machadoleonardo94/Echoes-of-Termina/Firmware/echoes_of_termina/docs/two-button-ui.md

# Two-button interface — evaluation

Scope: what the two buttons can express on this hardware, what was measured on the
bench board while building it, and where the current provisional mapping does not
hold up. Everything below is grounded in a serial capture of real presses, not in
a design sketch: the raw logs are `.pio/_btn_test.log` (diagnostic round) and
`.pio/_btn_final.log` (production round, both modes).

**Pictures:** `docs/diagrams/button-state-machine.png`, `gesture-map.png` and
`feedback-paths.png` (SVG next to each, for zooming). They are generated by
`tools/make_flowcharts.py`, which also self-checks its own layout — see section 10.

---

## 1. What was built

The single button's logic was replaced by two layers, so the interface can be
argued about without touching the state machine:

| file | role |
| --- | --- |
| `src/services/buttons.h` | pin levels → debounced gestures. Knows nothing about audio, WiFi or LEDs. Per-button click window (see section 9). |
| `src/services/controls.h` | gesture → feature. **The only file that decides what a gesture means.** |
| `src/services/audio_cues.h` | tones mixed into the Bluetooth PCM stream (feedback channel 1). |
| `src/services/ui_feedback.h` | the strip as an overlay: volume bar, animation blink count, mode-switch acknowledgement (feedback channel 2). |
| `src/services/wifi_portal.h` | gained a small facade (`audio_next_track`, `audio_restart_track`, `audio_set_volume_percent`, `audio_is_playing`, …) so the action layer never reaches into the player's internals. |
| `src/services/readings.h` | button code removed; keeps the ADC only. |
| `src/services/mode_manager.h` | no longer hard-codes the Bluetooth volume at boot; `controls_begin()` applies the persisted level to whichever backend came up. |
| `src/services/buttons.h` (`BUTTON_TRACE`) | diagnostic build: logs every raw edge plus a 5 s idle-level census, and suppresses the destructive actions. |

What went away: one pin, a shared press counter with four meanings, a 1000 ms
wait-and-see window, an `ISR`-vs-poll story spread over three files, and
`struct_buttonState`.

### Gesture ladder (per button)

```
MIN_PRESS   < 50 ms   electrical blip, discarded, leaves an open burst alone
CLICK       short press, released before 600 ms, no further press within 400 ms
DOUBLE      2 presses in one burst
TRIPLE      3 presses in one burst
HOLD        still down at 600 ms → then REPEAT every 150 ms → RELEASE on letting go
VERY_LONG   still down at 4000 ms, and it stops the repeat train
```

A hold swallows the burst it interrupted: press-press-hold is a `HOLD`, never a
`DOUBLE` followed by a hold.

---

## 2. Verified on hardware

Bench board, `echoes-v1` (8 MB, PSRAM disabled), flashed over OTA; both buttons
exercised by hand with COM7 capturing.

**Input layer — works, on both pins.**

```
[BTN] PROG on GPIO0, active LOW (press to GND) — idle level released
[BTN] EXT on GPIO4, active HIGH (press to 3V3) — idle level released
[BTN] levels: PROG(GPIO0)=HIGH EXT(GPIO4)=LOW          ← 5 s census, both idle correctly
[BTN] EXT raw -> PRESSED @29351 ms / released @29516 ms → [BTN] EXT click (165 ms)
[BTN] EXT double (118 ms)      [BTN] EXT triple (92 ms)
[BTN] PROG hold (600 ms)  →  repeat (750) (900) (1050) …  →  release (2783 ms)
[BTN] PROG very-long (4000 ms)
```

* **Zero** `ignored … blip` lines and zero phantom events across ~15 minutes on
  both pins. The old GPIO0 noise problem did not reappear, but the strip was not
  driving hard audio at the time — the polling design is what protects against it.
* Measured human tap durations: **96–190 ms** (PROG 122–157, EXT 124–190). The
  50 ms blip floor therefore has a 2–4× margin, and no tap ever approached the
  600 ms hold threshold. The thresholds are correctly placed on this hardware.
* Burst separation measured: two taps 273 ms apart → `DOUBLE`; three taps 300 and
  346 ms apart → `TRIPLE`; taps 1.5 s apart → three separate `CLICK`s. The 400 ms
  window is doing exactly what it claims.

**Both playback backends.**

| gesture | WiFi mode (local SD player) | Bluetooth mode (phone) |
| --- | --- | --- |
| PROG click | `[BUTTON] No track to pause` (nothing loaded) | `AVRCP pause` / `AVRCP play`, phone confirmed (`phone playback status -> 1/2`) |
| EXT click | `[CTRL] next: no playlist loaded` | `[CTRL] AVRCP next` — track changed |
| EXT double | `[CTRL] LED animation -> none/envelope/fft` | same |
| PROG triple | `[MODE] Switching to Bluetooth — restarting…` → rebooted, phone auto-reconnected | (reverse) |
| PROG/EXT hold | volume ramp 100→0 %, persisted | audible ramp 100→55 →100 %, `A2DP step 127→69→127` |

**Three defects the log exposed, all fixed and rebuilt:**

1. **NVS write per ramp tick.** A 2 s hold wrote flash 13 times
   (`Volume saved to NVS` every 150 ms). Now the ramp persists on its first tick
   and once on release — 2 writes per gesture — and rebooting actions persist
   first, so a 4 s hold that ends in a reboot cannot come back at the pre-hold
   level.
2. **Limit spam.** Holding a button already at 0 %/100 % logged one line every
   150 ms. Now it reports the limit once per gesture (re-verified: one line, then
   12 silent repeats).
3. **Two owners of the volume.** The portal's slider and the button ramp each kept
   their own idea of the level, so a slider move followed by a button press wrote
   the stale value back. There is now one percent, one writer, one NVS key.

**One observation to watch:** `ASSERT_WARN(1 9), in lc_task.c at line 1409` from
the Bluetooth controller, once, immediately after an AVRCP pause while streaming.
It is a warning, not a panic — the session continued normally. Not from this
firmware, but it is worth recognising if it ever shows up alongside a dropout.

---

## 3. Constraints the interface has to live inside

These are properties of the board and the libraries, each confirmed in this
session or in the library source. They are what make the interface design
non-obvious.

1. **A tap costs 400 ms before it does anything.** A single click cannot be
   committed until the multi-click window closes. Measured consequence: every
   play/pause press is felt ~0.4 s after the finger leaves the button. This is the
   price of having double- and triple-click mean something.

2. **The two modes are exclusive, and the same gesture has two backends.**
   Bluetooth = the phone is the transport (AVRCP only: no playlist, no seek, no
   exact restart). WiFi + standalone = the SD player is the transport, but
   playback **requires the radio down** (no PSRAM on this board: BT mode leaves
   ~42 KB free, WiFi mode ~88 KB, and lwIP plus the decoder do not fit together).
   So while a local track plays there is no portal, no OTA, and no AVRCP — and the
   button path back (`EXT` very-long → `wifi_enable()`) is not a nicety, it is the
   only exit that does not reboot.

3. **AVRCP commands block the main loop for ~100 ms each.** The library's
   `execute_avrc_command()` sends PRESSED, `delay(100)`, RELEASED
   (`BluetoothA2DPSink.cpp:1353-1372`, `delay_ms` is Arduino `delay`). Fine for a
   tap; fatal for a volume ramp, which is why the ramp drives the sink's local
   attenuation with `set_volume()` (no blocking) instead of `volume_up()`.

4. **Who owns the volume is genuinely ambiguous in Bluetooth mode.** Our
   `set_volume()` sets local digital attenuation *and* notifies the phone of the
   new level (`volume_set_by_local_host`); the phone's own slider arrives as
   `SET_ABSOLUTE_VOLUME` and lands in the same `s_volume` (`volume_set_by_controller`).
   Last writer wins. Measured: the button ramp is clearly audible, but a phone
   sitting at 20 % still caps the ceiling no matter what the ramp does.

5. **The local player cannot be created in Bluetooth mode** — `Audio`'s
   constructor installs `I2S_NUM_0`, which the A2DP sink already owns. The old
   firmware allowed a long-press "standalone show" in Bluetooth mode; that is now
   refused explicitly rather than half-executed into silence.

6. **`ESP32-audioI2S` has no mixing hook.** Nothing can be played *on top of* a
   local track, so audio cues behave differently in the two modes (section 5).

---

## 4. Evaluation of the provisional mapping

```
gesture            PROG (GPIO0)                  EXT (GPIO4)
click              play / pause                  next song
double             restart song                  cycle LED animation
triple             switch mode (reboots)         standalone show
hold + repeat      volume down                   volume up
very long (4 s)    reboot the board              bring WiFi back
```

**What holds up.** Hold = volume on both buttons is the best part of this map:
symmetric, memorable, no modes to learn, and it is the one gesture where
continuous input is the natural expression. Click = play/pause and click = next is
the industry-standard pair. Keeping the rare, destructive actions on the two
hardest gestures (triple, 4 s hold) means neither can be triggered by a pocket
squeeze or a dropped device.

**What does not hold up.**

* **P1 — the 400 ms tax is charged to the most frequent action.** Play/pause is
  the gesture a user makes most and feels most. It waits the longest. Mode switch
  (rare, rebooting, 8 s of silence) is what forces that wait.
* **P2 — the transport row is dead exactly where the device is reachable.** In
  WiFi mode with nothing loaded, a click does nothing but log
  (`No track to pause`, `no playlist loaded`). That is the state the device sits
  in when its owner walks up to it: idle, portal up. The most useful click there
  is "play something", not "pause nothing".
* **P3 — "switch animation" is a blind action.** Tapping EXT twice cycles
  none → envelope → fft, and the only confirmation is a serial line. Envelope and
  FFT do not differ visibly until audio is playing, so a user can cycle three
  times and have no idea where they landed. Same for the volume: with nothing
  playing, a ramp is completely silent and invisible.
* **P4 — "restart" is ambiguous, and both readings already share one button.**
  Double-click = restart the current song; 4 s hold = reboot the device. In
  Bluetooth mode "restart song" degrades to `AVRCP previous()`, which is the
  source app's decision, not ours — it may restart, or step back a track.
* **P5 — the very-long tier has no arming feedback.** Nothing tells the user that
  holding past 4 s is different from holding for 1 s, so the only way to learn it
  is to search for it. On a device whose entire output is a LED strip and a
  speaker, that is a missed opportunity — see section 5.
* **P6 — one button carries five gestures, the other five.** Fine on paper, but
  PROG is also the boot-strapping pin (holding it during a reset enters the ROM
  loader) and on the bench board it is the harder button to reach. Legibility
  would improve if the multi-click ladder lived on the accessible button only.

---

## 5. Audio feedback: what is actually possible

The device has a speaker, so "the interface talks back" is not decoration — with
no screen it is the only way some actions can be confirmed at all.

**Bluetooth mode — cues can be mixed into the stream. Feasible, and there are two
insertion points.** The library calls its hooks inside `audio_data_callback`
(`BluetoothA2DPSink.cpp:1311-1349`) in this order:

```
raw_stream_reader(data, len)          ← BEFORE volume control  (already used: the LED tap)
volume_control()->update_audio_data((Frame *)data, len / 4)
stream_reader(data, len)              ← AFTER volume control
write_audio(data, len)                → I2S
```

The buffer is mutable — the library itself casts it to `Frame*` and rewrites it in
place for both the channel swap and the volume — so a cue generator can add into
it. Two deliberate choices follow:

* **post-volume hook** (`set_stream_reader(cb, /*is_output=*/true)`): the cue is
  always audible at the same loudness, independent of the volume setting. This is
  the right place for "animation switched", "mode switch armed", "no source
  connected".
* **pre-volume hook**: the cue's loudness tracks the volume, which is exactly what
  a *volume* cue should do — the beep tells you how loud the output actually is,
  which is the one thing a volume ramp cannot otherwise communicate while silent.
* Caveat: `set_stream_reader()`'s second argument **is** `is_output`; passing
  `false` silences the DAC. This is already documented in `mode_manager.h` and is
  the reason the LED tap uses `set_raw_stream_reader()` instead.
* Cost: a precomputed sine table (a few hundred bytes of `static` data) and a
  couple of adds per frame on the BT data path, with ~33 KB free heap in that
  mode. No allocation, no blocking call — unlike AVRCP, which blocks 100 ms.

**WiFi / standalone mode — no cue can be mixed into a playing track.**
`ESP32-audioI2S` owns `I2S_NUM_0` and has no beep or mixing API. The options, in
order of preference:

1. **Use the strip as the feedback channel.** 144 addressable LEDs, already
   driven, works in both modes, costs nothing on the audio path. A volume ramp
   becomes a bar that fills as you hold; an animation switch becomes a short
   confirmation flash; a 4 s hold becomes a countdown; the mode switch becomes a
   colour. This is the highest-value change in this document, and it is mode
   independent.
2. **Short cue files from the SD card** — only usable between tracks or while
   idle (playing one means re-connecting the decoder to a different file, which
   stops the song), so it cannot serve volume or transport feedback mid-track.
3. **Accept silence** for local playback, and keep serial lines for development.

**Consequence for the feature list.** "Play" and "pause" are inherently audible
(the music starts and stops). "Next song" is audible in Bluetooth mode and
self-evident in local mode. **Volume, animation and mode switch are the three that
need help**, and they need it in both modes — which points at the strip for all
three, with in-stream cues in Bluetooth mode as the refinement that makes volume
feedback honest.

> Superseded in one respect by section 11: the board's *own* states (waiting for a
> phone, paired, hotspot, WiFi up/down) happen with no stream in existence, so a third
> path was added — tones written straight to the I2S wire while the DMA has no writer.
> A track that is already playing is still unreachable; that conclusion stands.

---

## 6. Options for the mapping

**Option A — keep it, tune it.** Leave the map as-is and drop the multi-click
window from 400 ms to 300 ms. Lowest risk, does not fix P1–P5.

**Option B — per-button windows (recommended).** Make the multi-click window a
per-button property, so a button whose clicks are single-purpose fires them
*immediately on release* instead of waiting:

```
PROG (single-purpose, instant)     EXT (laddered, 400 ms window)
click      play / pause            click      play-when-idle, else next song
hold       volume down             double     cycle LED animation
very long  reboot                  triple     switch mode (reboots)
                                   hold       volume up
                                   very long  bring WiFi back
```

This fixes P1 (pause is instant), P2 (the idle click starts a show rather than
aiming at nothing), and P6 (the hidden gestures concentrate on the accessible
button). It costs ~15 lines in `buttons.h`: a `multi_gap_ms` field per wiring
entry, with 0 meaning "commit the click on release".

**Option C — chord for the mode switch, everything instant.** Hold *both* buttons
for 3 s → switch mode, with the strip counting down. Then neither button needs a
multi-click window and every click is instant. The ramps cancel out naturally
during the chord (one steps up, one steps down in the same 150 ms tick), so no
extra arbitration is needed. The risk is an accidental chord — which is why the
countdown on the strip is not optional, and why this is the second choice: it buys
responsiveness by making a rebooting action easier to trigger by accident.

**Recommendation: B now, C only if the 400 ms tap lag on EXT also turns out to
annoy.** Both are cheap; B subsumes the immediate fix and leaves the chord open.

---

## 7. Parameters, as measured

| constant | value | where it came from |
| --- | --- | --- |
| `BTN_DEBOUNCE_MS` | 25 ms | unchanged from the old polled debouncer |
| `BTN_MIN_PRESS_MS` | 50 ms | measured taps 96–190 ms → 2–4× margin |
| `BTN_HOLD_MS` | 600 ms | felt right on hardware; separates cleanly from taps |
| `BTN_REPEAT_MS` | 150 ms | 6.7 steps/s |
| `CTRL_VOLUME_STEP_PERCENT` | 5 % | full sweep ≈ 3 s of holding (measured) |
| `BTN_VERY_LONG_MS` | 4000 ms | fires at exactly 4000 ms in the log |
| `BTN_MULTI_GAP_MS` | 400 ms | doubles at 273 ms and triples at 300/346 ms detected; 1.5 s taps correctly separate |
| A2DP volume range | 0–127 | 5 % ⇒ step 6.35 |
| local volume range | 0–21 | 5 % ⇒ step 1.05, hence the percent is authoritative |

---

## 8. Open questions

Answered by the device's owner:

1. **"Restart" — song or device?** → **Song.** There is therefore no reboot
   gesture at all; `POST /api/reboot` and the power switch remain for that. It also
   freed the second button's ladder (a reboot no longer competes with a transport
   action for a slot).
2. **Should the idle click become "play"?** → **Yes.** See the implemented map below.
3. **Which map?** → **B** (per-button click windows).
4. **Implement the cues?** → **Yes**, both channels: tones in the Bluetooth stream
   and the strip as an overlay.

---

## 9. What was implemented after this evaluation

### The map that ships

```
PROG (GPIO0) — single-purpose, clicks are instant (no multi-click window)
    click        play / pause   (with nothing loaded: play = start a standalone show)
    hold         volume down    (ramp, strip bar, rising/falling ticks)
    very long    restart the current song (the ramp is undone first)

EXT (GPIO4) — carries the ladder, clicks wait for the 400 ms window
    click        play when idle, otherwise next song
    double       cycle LED animation (1/2/3 blue blinks = which animation)
    triple       switch mode (3 white flashes, then the reboot)
    hold         volume up      (same feedback as PROG's ramp)
    very long    bring WiFi back after a standalone show tore it down
```

### The two feedback channels

| channel | file | works when | cannot do |
| --- | --- | --- | --- |
| tones mixed into the A2DP stream | `src/services/audio_cues.h` (`cue_mix`) | Bluetooth mode, **while audio is actually flowing** | anything in local playback; anything while the phone is paused or no source is connected (no data callback = no stream to mix into) |
| tones written straight to the I2S wire | `src/services/audio_cues.h` (`cue_wire_pump`, `cue_play_now`) | every state with no stream: Bluetooth waiting/paired, WiFi hotspot/connected/failed | while a track or a phone's stream owns the DMA (section 11) |
| the strip as an overlay | `src/services/ui_feedback.h` | both modes, always | show fine detail (it is a bar and a blink count) |

Measured reasons each is placed where it is:

* The cue mixer registers through `set_stream_reader(cue_mix, true)`, i.e. **after**
  volume control, so a cue is equally loud at 5 % and at 100 %. That is the right
  behaviour for "the animation changed", and it is why the *volume* cue reports the
  level by **pitch** (400 Hz → 1400 Hz) rather than by loudness.
* The overlay pre-empts both LED renderers. `run_lightshow()` and
  `run_led_animation()` consult `ui_feedback_active()` and stand down, because each
  renderer ends its frame in `majora.show()`, which blocks for the whole RMT
  transfer (~29 µs/LED, ~4 ms at 144 LEDs). Two renderers drawing the same frame
  would halve the frame rate for no visible gain.
* The ramp's strip bar refreshes on every tick (150 ms) and is deliberately not
  frame-paced, or the bar would visibly lag the finger on a long strip.
* `ui_flash_blocking()` (the mode-switch acknowledgement) blocks ~0.9 s on purpose:
  the action it confirms is about to take the CPU away, and a user who does not see
  the acknowledgement cannot tell an accepted triple-click from a missed one.

### Decisions taken while implementing

* **A very-long hold undoes the ramp it interrupted.** The gesture starts as a
  volume ramp and only becomes "restart" at 4 s; without the undo, restarting a
  song would also have dragged the volume to one end.
* **The Bluetooth→WiFi direction is the only one with an audible mode-switch
  cue.** The arpeggio is mixed into the A2DP stream, and that stream exists only
  while Bluetooth mode is up — switching *to* Bluetooth happens with the mixer off.
  Both directions get the white flashes.
* **The diagnostic build suppresses two actions, not three**: mode switch and
  play-from-idle (which tears WiFi down). A reboot gesture no longer exists to
  suppress.
* **`ctrl_reboot()` was removed** rather than left unused: the feature list asks for
  restart-the-song, and dead code that reboots a board is not worth keeping for
  nostalgia.
* `lightshow_frame_period_ms()` lost its `static`, because the overlay (included
  above the renderers so they can yield to it) paces its frames with it.

---

## 10. Diagrams

Generated by `tools/make_flowcharts.py` (matplotlib), written to `docs/diagrams/` as
PNG at 200 dpi plus SVG:

```
python tools/make_flowcharts.py
```

The script **checks its own layout** before it declares success, because the
diagrams were laid out without anyone looking at them: it registers every box, note
and arrow, then fails the run if two of them overlap, if any text is wider or taller
than the box holding it, if anything falls outside the canvas, or if an arrow starts
or ends in empty space rather than on a box. That is a real check, not a formality —
the first run reported five overlaps and one box hanging off the canvas.

### button-state-machine.png / .svg

The gesture ladder in `src/services/buttons.h`: the release path (click / double /
triple, and the `multi_gap_ms == 0` branch that makes PROG's clicks instant) and the
hold path (HOLD at 600 ms → REPEAT every 150 ms → VERY_LONG at 4 s → RELEASE).

### gesture-map.png / .svg

The interface as shipped, gesture by gesture, for both buttons — including the
actions the state machine can never produce for PROG, which is the consequence of a
zero click window.

### feedback-paths.png / .svg

How an action answers back: the strip overlay (both modes, always) and the tones
mixed into the A2DP stream (Bluetooth only, and only while the phone is sending
audio), plus the yield relationship that keeps the two LED renderers from drawing
the same frame twice.

---

## 11. State cues — the board says what it is doing

Gesture feedback answers a press. It says nothing about the far more common question:
**what is this thing doing right now?** In Bluetooth mode the answer used to be
unavailable everywhere — dark strip, silent speaker, and no way to tell "waiting for a
phone" from "hung". Five states now announce themselves.

### What each one sounds like, and why

| state | kind | motif | where it is triggered |
| --- | --- | --- | --- |
| Bluetooth mode, no source | `CUE_BT_WAIT` | two long low notes rising (D5→G5, 260 ms) | `setup_bluetooth_mode()`, immediately after `a2dp_sink.start()` — **once per boot** |
| source connected | `CUE_BT_PAIRED` | three fast notes, 880→1175→1568 Hz | `cue_on_bt_connection_state()` → `CONNECTION_STATE_CONNECTED` |
| config hotspot created | `CUE_AP_UP` | the same note twice, 60 ms apart | the WiFiManager `setAPCallback()` in `wifi_settings.h` |
| WiFi up | `CUE_WIFI_OK` | rising triad ending high | `setup_WIFI()` on success, and `wifi_enable()` when the 4 s hold works |
| no network | `CUE_WIFI_FAIL` | falling triad ending low | `setup_WIFI()` on portal timeout, and `wifi_enable()` when it cannot reconnect |

One rule makes the set learnable after two or three encounters: **rising = on, falling
= no, a repeated note = "listen, I need something"**. The state motifs also sit in a
different register from the transport cues, so "paired" cannot be mistaken for
"playing".

Three decisions worth recording:

* **"Waiting" plays once, not forever.** A repeating beacon would answer "is it even
  on?" better, but it is also the sound a user would hate by day two. The owner chose
  once-at-boot; the change of state gets announced instead.
* **Disconnect is silent on purpose.** `set_auto_reconnect(true, 3)` cycles through
  `DISCONNECTED` up to three times, so an announcement there would stutter.
* **A cue is never lost to ordering.** `ctrl_switch_mode()` and `ctrl_wifi_restore()`
  call `cue_play_now()` (render here, return when done) because both are followed by
  blocking work — three flashes, or a reboot — that would starve the loop pump.

### Why a second sink was needed

The stream mixer can only speak while the phone is *sending audio*, which is exactly
never in the four states above. What makes the cues possible is the shape of the A2DP
sink itself:

* `a2dp_sink.start()` → `init_i2s()` → `out->begin()` → `i2s_driver_install(I2S_NUM_0)`
  (`BluetoothA2DPSink.cpp:231-237`, `BluetoothA2DPOutput.cpp:74-104`) at 44100 Hz /
  16-bit / stereo with `tx_desc_auto_clear=true` — the DAC is clocked and fed silence
  from boot.
* The base `BluetoothA2DPSink` has **no I2S task**: `i2s_task_handler()` and
  `bt_i2s_task_start_up()` are empty dummies meant for `BluetoothA2DPSinkQueued`
  (`BluetoothA2DPSink.h:603-605`). PCM reaches I2S only from `audio_data_callback()`.

So until a source streams, the DMA has no writer and the wire belongs to the firmware.
The cue engine (`services/audio_cues.h`) renders the **same** `CuePattern` table into
`i2s_write()` for that window, from one dedicated voice, so a cue is identical whichever
sink carries it.

Rules that keep this safe:

* **The gate is the AUDIO state, not the connection state.** `handle_connection_state()`
  publishes `CONNECTED` *before* invoking our callback, so gating on
  `is_connected()` would silence the one cue that matters most. The wire is free while
  `get_audio_state() != STARTED`.
* **In WiFi mode the peripheral is installed per cue.** The decoder is created lazily
  (`wifi_portal.h:_ensure_player`), so nothing owns `I2S_NUM_0` at boot — the cue
  installs it, plays, and uninstalls, which is the sequence the boot beep test already
  proved on both boards. Its DMA is 2 KB, not the decoder's 32 KB, and a silent tail is
  pushed before the uninstall so a cue never ends in a click.
* **One request, one render.** `cue_play()` drops a request into a single slot; both
  sinks claim it under one critical section, so it is rendered exactly once. The pump
  checks that the wire is free *before* claiming, so a cue requested while music plays
  is left for the mixer instead of being consumed and lost.
* **The volume cue stays pitch-coded.** The wire path bypasses the sink's volume
  control entirely, so a cue written there is the same loudness at 0 % and at 100 % —
  correct for a status beep, useless for reporting a level, which is why
  `CUE_VOLUME_TICK` still reports the level as pitch (400→1400 Hz).
* **Nothing here is heard in local playback.** `ESP32-audioI2S` owns the DMA while a
  track runs and has no mixing hook, so `cue_play()` is a no-op in WiFi mode and the
  strip remains the channel for gestures there.

---

## 12. "Next song" walked a one-entry playlist

**Symptom reported from the bench board:** with a standalone show playing off the SD
card (WiFi mode), an EXT click **restarted the same song** instead of moving to the
next one.

**What the log said** (`.pio/_next_bug.log`, pre-fix):

```
[Lightshow] t=96000 ms  fired=461  next=96043 ms  period=5 ms  leds=28
[BTN] EXT click (125 ms)
[AUDIO] SD file 4331564 bytes, first4=49 44 33 04 (ID3=1 MP3sync=0)
[PORTAL] Playing: /Echoes/Lightshows/wisdom/wisdom.mp3
[AUDIO] play_index -> running=1 rate=48000 ch=2 bits=16 dur=0 s size=4331564
[Lightshow] Attaching /Echoes/Lightshows/wisdom/wisdom.echoes
[Lightshow] t=0 ms  fired=0  next=2000 ms  period=5 ms  leds=28
```

The transport was right — `_play_next()` ran, the file was re-opened, the show was
re-attached — but the *index it moved to was index 0 of a one-entry list*.

**Cause.** `_play_path()` built `playlist` from the **parent folder** of the track it
was given, and the card's layout is one song per Lightshows project
(`/Echoes/Lightshows/<project>/<song>.<ext>` + `<song>.echoes`). So
`playlist.size() == 1`, `_play_next()` computed `index + 1 == 1`, `_play_index()`
wrapped it to `0`, and the same file started again from the top with its lightshow
restarted at t=0. Three projects on the card, and the transport could only ever see
one of them.

**A second, quieter face of the same bug** was visible in the same capture: every
track looped itself at its natural end. `wisdom.mp3` is 270.7 s, the reset happened at
`t=270000 ms`, and `audio_eof_mp3()` → `player_eof` → `_play_next()` hit the identical
wrap. 240 s of capture showed one song playing twice, and a click was *not* required
to reproduce it — which is also why the report ("a click resets the song") was
plausible but the mechanism was not the click.

**Fix** (`src/services/wifi_portal.h`). When the current folder IS a Lightshows project
folder — a direct child of `/Echoes/Lightshows` — and it holds at most one playable
track, the playlist is widened to **one track per project, sorted by path**
(`_build_lightshows_playlist()`, capped at `PLAYLIST_MAX_TRACKS` = 128 with a log line
when the cap is hit). A folder that holds several songs keeps the per-folder list, so
`/Echoes/Music` (three songs, flat) behaves exactly as before. `_play_next()`,
`_play_prev()` and the end-of-track advance are untouched — they simply have
somewhere to go now:

| case | playlist before | playlist after |
| --- | --- | --- |
| a Lightshows project folder (1 song) | `[wisdom.mp3]` | `[changing_seasons.mp3, lost_woods.mp3, wisdom.mp3]` |
| `/Echoes/Music` (3 songs) | its 3 songs | its 3 songs |

Sorted order means `changing_seasons → lost_woods_stereo → wisdom → wrap`, and the
`[PORTAL] Playing:` line now reports the position (`(track 2/3)`) so a skip can be
confirmed from the serial log alone.

**Verified after the OTA flash** (`.pio/_next_fixed.log`):

```
[BTN] EXT click (102 ms)
[CTRL] nothing loaded — starting a standalone show
[SHOW] Standalone: /Echoes/Lightshows/changing_seasons/changing_seasons.mp3  +  .../changing_seasons.echoes
[PORTAL] Playing: /Echoes/Lightshows/changing_seasons/changing_seasons.mp3  (track 1/3)
[BTN] EXT click (115 ms)
[PORTAL] Playing: /Echoes/Lightshows/lost_woods_stereo/lost_woods.mp3  (track 2/3)
[Lightshow] Attaching /Echoes/Lightshows/lost_woods_stereo/lost_woods_stereo.echoes
[Lightshow] Streaming /Echoes/Lightshows/lost_woods_stereo/lost_woods_stereo.echoes  (first command at 3429 ms, heap 28 KB free)
```

Two clicks, two different songs, and the second song brought **its own** lightshow
(28 KB free after the swap — the load fits while a track is streaming). The click is
still silent in local playback for the reason in section 11, so the change of song is
its own confirmation.

**Note for whoever measures next:** the widening happens while the radio is down
(~86 KB free at build time, 127 KB after `wifi_disable_for_show()`), so the extra
`String`s are cheap there — but `_play_index()` runs the swap *while streaming* with
~31 KB free, which is why the list is built once at play time and never rebuilt on a
skip.

---

## 13. Status lights — the strip as a state display

Section 11 makes the board *say* what changed. A cue is an **edge**: it fires at the
transition and then there is nothing. The question a user asks from across a room, in
silence, of a mask hanging on a wall, is the **level**: what is this doing *now*?

There is one case where the cue set cannot answer it at all. `CUE_WIFI_FAIL` fires from
`setup_WIFI()` on portal timeout and from `wifi_enable()` when the 4 s hold cannot
reconnect. A connection that drops *hours after* a successful join is announced
nowhere: the portal is unreachable, the phone is not streaming, the strip is idle — and
the board is indistinguishable from a healthy one until somebody tries the portal and
finds it gone. That, more than convenience, is what justifies this section.

Four rules govern it:

1. **It never fights the show.** The status layer is a renderer like the others and
   stands down exactly as `run_lightshow()` and `run_led_animation()` already do
   (`ui_feedback_active()`).
2. **It never fights the owner.** Two settings, below.
3. **It is readable by pattern, not only by hue** — see the colour-blindness note.
4. **It costs little.** A few pixels at a cap well under the show ceiling
   (`led_config.h`), because a held indicator is a permanent load.

### 13.1 Which radio, and what state

The modes are exclusive: `setup_bluetooth_mode()` calls `WiFi.mode(WIFI_OFF)`, so hue
alone cannot carry both *which radio* and *how it stands*. **Hue carries the radio,
pattern carries the state.**

| state | class | hue | pattern | where the state comes from |
| --- | --- | --- | --- | --- |
| Bluetooth paired | idle | blue | steady, very dim | `a2dp_sink.is_connected()` |
| Bluetooth awaiting a source | idle | cyan | two short breaths | boot, and after a disconnect |
| Wi-Fi connected | idle | green | steady, very dim | `WiFi.status() == WL_CONNECTED` |
| Wi-Fi lost after a join | idle | green | one long breath | Wi-Fi mode with `status() != WL_CONNECTED` |
| config portal open | transient | white-amber | double-blink | WiFiManager `setAPCallback()`, ≤60 s |
| file transfer running | activity | yellow | chase, **one step per chunk written** | `POST /api/upload` handler |
| drop-in update | activity | purple | **static** | `updatefromSD()` |
| OTA update | activity | purple | ramp | `ArduinoOTA.onProgress` |
| SD card unreadable | fault | red | fast double-blink | SD mount failure |
| battery low | action | red | three blinks, then unlatch | ADC < 3.1 V and not charging |

Three consequences worth stating:

* **"Wi-Fi lost" is green, and that is deliberate.** Red is reserved for faults — the
  card and the battery — because a mask whose network went away still plays everything
  on its card. Losing Wi-Fi is a *degraded connection*, not a failure, and painting it
  red would teach the user to ignore red.
* **The fresh-board ambiguity is solved by family, not by brightness.** A board that
  never connected shows green-breathing (Wi-Fi mode) or cyan-breathing (fallback to
  Bluetooth); the two breaths differ in length *and* the hues differ, which survives
  red-green colour blindness where a red/amber pair would not.
* **Red and amber are now free of the transfer colour.** Yellow is an activity hue and
  never appears beside a warm idle hue, in the same way purple never does.

**Which pixels carry it.** The board knows which shape it is wearing from its own LED
count (`/api/leds` `count`, 1–200): a mask is the 28-zone default, and a plain strip is
almost never exactly 28 pixels.

| board | pixels lit for a status colour |
| --- | --- |
| mask (`count == 28`) | the ten onboard spikes only |
| strip (anything else) | the whole chain, at the status brightness cap |

Two assumptions worth confirming on the board rather than trusting: that the ten onboard
pixels are the first ten of the chain (so a status colour cannot land on a detached
breakout strip), and that no real strip is 28 pixels long. The second is a known
collision, accepted — a 28-pixel strip would be treated as a mask and light only its
first ten pixels.

**Two chains are easier to count than one.** The mask chain stays where it already is,
`LED_output` (GPIO23); the second strip hangs off GPIO33. A board with that second output
declares its shape in hardware, so nothing has to be inferred from a number:

| board | what `count` means | how "is this a mask?" is answered |
| --- | --- | --- |
| two outputs (GPIO23 + GPIO33) | the **additional** strip's length; the mask chain is fixed at its own 28 | by the hardware, not by the number |
| one output (GPIO23 only) | the total chain length | `count == 28` → mask, anything else → strip |

That also decides the status colour: on a two-output board the spikes are always the mask
chain, whatever `count` says. The I2S pins are untouched by any of it — GPIO27 stays the
amplifier's bit clock. The only untested part is the second output itself.

### 13.2 Two layers, two lifetimes

An idle indicator holds for hours; an activity indicator holds for as long as the
operation. They are not the same kind of thing and must not share a timeout.

**Priority, highest first:**

```
drop-in / OTA update
> file transfer
> low-battery alert
> gesture acknowledgement (existing ui_feedback overlay)
> SD fault
> show (lightshow or animation)
> status colour
> idle decoration
```

The status colour draws only when nothing above it wants the strip, which is why "idle"
is in its name: a running show owns the pixels, and a status light that interrupted a
show would be the loudest possible version of the wrong idea. The one exception is
deliberate and opt-in: `anim=3` (13.4) spends the animation slot itself on the status
colour.

**Idle decoration** starts after roughly 60 s in which nothing user-visible happened —
no button gesture, no transport change, no HTTP request, no audio. It is the answer to
a mask being used as a decoration: dim, moving, or dark, chosen by the owner. **The
default is dark** — the feature ships silent, and a pulse or an animation is something
the owner switches on. Once on, it runs until the low-battery cutoff; nothing else stops
it. At roughly 5 % white a 28-pixel mask draws on the order of 80 mA, so "animated"
costs about a day on a 2000 mAh cell — the practical bound on the feature, not a bug.

### 13.3 The radio while idle

Two tiers, because a connected radio and a dark one cost different amounts and the same
mask needs both behaviours at different moments:

| tier | when | radio | portal reachable |
| --- | --- | --- | --- |
| 1 | the first ~10 min of idle | associated, **modem sleep on** (`WiFi.setSleep(true)`) | yes |
| 2 | after that | `WIFI_OFF`, the same call the show teardown uses | **no** |

Tier 1 exists because tier 2 makes the board undiscoverable: with the radio off, mDNS
goes with it, the HTTP server cannot be reached, and the editor's discovery cannot find
`echoes.local`. Ten minutes is far longer than the 60 s HTTP-activity timer, so anyone
actually using the portal never falls through to tier 2, and anyone who walked away does.

This changes one line at the source. `get_saved_wifi()` currently forces
`WiFi.setSleep(false)`, so the radio draws at full RX whenever the board is up; modem
sleep is the fix and costs nothing in reachability. Playback is unaffected either way —
a track tears the radio down completely (`wifi_disable_for_show()`), which is the same
`WIFI_OFF` state as tier 2.

**One wake path serves both tiers.** Any press, or any of the intent events, returns the
board to tier 1 and — if it had fallen to tier 2 — runs the bounded reconnect in 13.5. A
failed reconnect reports offline and leaves the board in tier 1, so the next wake tries
again instead of parking the user with a portal that looks dead.

**The 4 s hold is the manual recovery, and that is what makes tier 2 safe.** The EXT
very-long hold calls `ctrl_wifi_restore()` → `wifi_enable()`, which releases the decoder's
buffers, re-inits the driver (`WIFI_OFF` → `WIFI_STA` → `WiFi.begin()`), restarts the
portal if it was down, re-arms OTA and cues `CUE_WIFI_OK` / `CUE_WIFI_FAIL` on the result.
So a board can be genuinely network-independent — `retry_on_wake=no`, radio off in tier 2 —
and still not be unreachable to someone who wants the portal: press to wake, hold to
restore. One code consequence: `wifi_enable()` currently sets `WiFi.setSleep(false)`,
which under this policy undoes tier 1 — it should leave modem sleep on.

Scope: Wi-Fi mode only. Bluetooth mode has its radio off already, and the tiers are
meaningless there.

### 13.4 Settings

Two LED selectors under `POST /api/leds`, beside the existing `LED_count` and `anim`:

| setting | values | meaning |
| --- | --- | --- |
| `status` | `off` / `change` / `always` | lights off; a brief indication on each state change; held while the state lasts |
| `idle` | `dark` / `dim` / `animated` | what an idle board does after the timeout (default `dark`) |

And one connectivity preference, which belongs with the credentials in the `"wifi"`
namespace rather than with the LED settings:

| setting | values | meaning |
| --- | --- | --- |
| `retry_on_wake` | `yes` / `no` | whether waking a board that is in Wi-Fi mode but offline re-tries the saved network (13.5) |

The settings are preferences and persist: `status` and `idle` in the same `"leds"`
namespace that already holds `LED_count` and `anim`, `retry_on_wake` in `"wifi"` beside
the credentials. The **states** are not stored at all. The board
re-derives everything at boot and re-measures the battery rather than remembering it, so
a persisted "was offline" or "was idling" would only be a stale copy of something already
known — and one that could disagree with reality after the battery is swapped.

**One rename and one new mode, recorded so the code can follow the doc.**

* `count` becomes **`LED_count`**: same value, unambiguous name. The NVS key moves with
  it, and there is deliberately no legacy fallback — nothing is in production, the testers
  expect breakage, and a renamed key that a board forgets exactly once (back to 28 pixels
  and the 28-pixel ceiling) is the cheapest migration available. The portal takes the new
  argument name; there is no reason to carry the old one.
* `anim` keeps its name and gains a fourth value, **`3` = status echo**:

  | value | mode | what the strip does for a track with no `.echoes` show |
  | --- | --- | --- |
  | 0 | none | stays dark (the default) |
  | 1 | envelope | amplitude bar, mirrored from the centre |
  | 2 | FFT | frequency spectrum, low end in the middle |
  | 3 | status echo | draws the state colour |

  It costs nothing on the audio path — no PCM-tap processing, none of the FFT's ~5.2 KB
  — because it renders the same code the status layer already uses. It does not overlap
  the idle layer either: the animation slot only runs during playback, and the status
  colour only runs when nothing above it wants the strip.

### 13.5 Waking a board that is idling

A hung mask will be brushed against, and a touch module gives no tactile feedback to
tell a real press from a sleeve. The module drives the existing `button` input (GPIO19 on
Marajoara V3), so it presents itself to the firmware as an ordinary active-high press and
nothing in `buttons.h` or `controls.h` changes. So:

* **The first press is absorbed.** While idle decoration runs, any press cancels it and
  is consumed; the gesture the user then makes behaves normally. This is what keeps a
  brush from pausing music or switching modes, and it makes the destructive gestures
  (mode switch, reboot, standalone show) require a second, deliberate interaction.
* **The acknowledgement is three bright blinks of the current state colour** —
  `ui_flash(3, color)`, which already fits `UI_FLASH_TOTAL_MS` (700 ms, 233 ms a blink)
  and caps at four. Bright flashes for a transient, dim steady/breathing for a held
  state: the same hue at two brightnesses is not ambiguous.
* **Events that already imply intent do not need the gate.** A Bluetooth connection, an
  HTTP request, or playback starting cancels the decoration without consuming anything.
* **A wake can re-check the network.** If the board is in Wi-Fi mode and currently
  offline, the wake runs a bounded attempt against the saved credentials — five seconds,
  no captive portal, no AP — and reports the result. Some owners deliberately run this
  board with no network at all while still wanting the standalone show the touch button
  starts, which is why this is the `retry_on_wake` setting rather than fixed behaviour.
  A failure is announced on the edge as well as held as a colour: the cue fires when the
  speaker is free, and the light always.
* **Cost, stated honestly:** skipping a track from idle becomes press-then-double-click.

### 13.6 Low battery

`ADC < 3.1 V` and not charging — where "not charging" is now unambiguous, because
CHRG/STDBY both read HIGH only when the module has no VBUS. Three dim red blinks, then
the latch is released.

* **Checked early on boot**, before `setup_WIFI()` is allowed to bring the radio up, and
  again every 60 s.
* **Sag is the signal, not the noise.** While charging the battery sources nothing, so
  it cannot sag; while discharging, a 3.1 V reading during a Wi-Fi burst or a
  MAX98357A peak is the warning itself. Triggering protection on it is the point —
  waiting for a resting voltage lets the cell go deeper for no benefit.
* **The blinks are deliberately dim.** They land at the moment the rail is weakest, and
  a full-brightness ring there is the one thing that could brown the board out
  mid-signal.
* **No NVS latch.** After a shutdown the board re-measures on the next boot and shuts
  down again if it is still low: the indication repeats, which is the desired
  behaviour, and nothing has to be cleared by hand.

**Charge sensing on Marajoara V3.** The TP4056's `CHRG#`/`STDBY#` are wired to the charge
LEDs and nothing else — the V3 board file carries no net on either pad beyond the package's
own pin names — so there is no MCU path today and this revision has to add one.

**No single status pin can carry the answer.** With VBUS absent the TP4056 is unpowered, and
its output pins are dragged near ground by the pull-up leaking through the pin's ESD diode —
so both `CHRG#` and `STDBY#` read LOW, which is also what "terminated" reads on one pin
alone. Two pins plus the ADC resolve it completely:

| `CHRG#` | `STDBY#` | V_REG | state |
| --- | --- | --- | --- |
| LOW | HIGH | climbing | charging |
| HIGH | LOW | ≥ ~4.1 V and steady | charge complete |
| LOW | LOW | falling, sagging under load | unpowered — discharging |
| LOW | LOW | ~4.05 → 4.2 V, brief | the recharge transition, not a fault |

Both-low is the "the charger is not talking" signature; V_REG and the history separate an
unplugged cell from the recharge transition. Steady both-low with a *falling* cell is the
unplugged case, and the only one where the mask has to think about battery life.

**VBUS is not measured, and it would buy nothing.** With Q3/Q4 holding the battery off the
load whenever VBUS is present, the cell cannot discharge during a charge, and a charger too
weak for the load browns the rail out rather than draining the cell — a failure the BMS
handles bluntly on its own. Either VBUS is there or it is not; what the ADC contributes is
the cell's voltage, not the rail's.

**Pins: `CHRG#` on GPIO4, `STDBY#` on GPIO35, second strip output on GPIO33.** GPIO4 brings
its own pull-up; GPIO35 is input-only with none, so an external one is required — and the
board already carries 100 k, so two in parallel (~50 k) is the value to use rather than
introducing a 47 k. Keeping it weak is better electrically too: ~50 k drives only tens of µA
into the unpowered part's ESD diode, holding the node at a comfortable logic low instead of
pushing it into the ambiguous band that a stiff pull-up would. That leaves **GPIO39** as the
only spare pin on the board, which is why it is pencilled in for a second touch input.

GPIO33 becoming the second strip output means the ten-spike rule in 13.1 now needs a story
for two chains — carried to 13.8.

Reading `STDBY#` rather than `CHRG#` is the cleaner half of the pair: "charge complete" is
asserted directly instead of inferred from the cell having reached 4.1 V. Rapid `STDBY#`
cycling is the fault case — a healthy full cell re-enters the 4.05 V recharge threshold
every few hours at most, so flipping every few seconds means the cell cannot hold its
voltage. That is also what V1 looks like from outside, because its board load steals charge
current and the TP4056 never reaches termination; V3's VBUS-supplied topology is the fix.

**No board needs the rule gated off.** A cell being charged is being pushed up, not
drained, so the ADC cannot read below 3.1 V while a charger is attached; a board that reads
low is genuinely low, and the correct answer is to blink, unlatch and let it charge rather
than let the user force another session out of a flat cell. The BMS will cut the drain far
less politely, and browning out under the amplifier is worse than a mask that declines to
start. `PINOUT_HAS_CHARGE_SENSE` therefore buys an accurate state for the log, not safety.

### 13.7 Where each piece goes

| piece | file |
| --- | --- |
| the renderer, joining the `ui_feedback_active()` stand-down gate | `services/ui_feedback.h` |
| a `status_state()` poll (1 Hz is enough) feeding it | `services/mode_manager.h` / `loop()` |
| transfer step, one per chunk | `_portal_upload_handler` in `services/wifi_portal.h` |
| update colour | `components/SDCARD/setup.h`, `features/update_firmware_ota.h` |
| battery threshold and unlatch | `main.cpp` (boot check before mode setup) + `read_adc()` |
| the LED settings | `_portal_leds` in `services/wifi_portal.h` |
| the wake reconnect (`retry_on_wake`) | `services/wifi_settings.h`, polled from `loop()` |

**The one real hazard:** during a drop-in update the flash cache is disabled while
`Update.writeStream()` erases and writes, so code in flash and DMA-driven peripherals
must not be touched. Render purple **once, before `Update.begin()`**, then stay silent
through the write — the reboot or the failure path is what follows. The OTA path is the
opposite: `ArduinoOTA.onProgress` runs in `loop()` in normal context, so a real ramp is
safe there, which is why the two purple behaviours differ.

Two notes on the wake reconnect. It must be a **polled state machine with a five-second
deadline, never a `while` loop** — the wake press usually also starts playback, and five
blocking seconds would stall the audio pump and the lightshow behind it. And the
"offline" cue can only be played when the decoder does not own `I2S_NUM_0` (section 11:
`cue_play_now()` installs the peripheral per cue in Wi-Fi mode), so a wake that goes
straight into a track reports by light alone. A successful reconnect re-binds the OTA
socket (`setup_OTA()` is idempotent and re-arms port 3232 on the new netif); the portal
itself never stopped listening.

### 13.8 Open

Settled while writing this section: a dropped connection announces itself on the edge
(cue) and holds as a light (green breath), and it does not re-announce on its own — the
wake path is what re-checks it; states are never stored, settings are; a mask lights its
ten spikes and a strip lights the whole chain; the idle default is `dark`; the radio
sleeps through two tiers; and nothing stops the decoration except the low-battery cutoff.

Still open:

1. **Idle animations** — a soft pulse, a clock, rainbow fluid. Not today: the default is
   no animation, and `idle=animated` therefore has no animation assigned to it yet. Worth
   noting before one is chosen that a *clock* needs network time, so it can only ever
   work in Wi-Fi mode connected.
2. **Which chain indices are the ten spikes.** The renderer should index 0–9 only once
   that is confirmed on Marajoara V3.
3. **The second strip output itself.** The pins are settled — mask chain on `LED_output`
   (GPIO23), second chain on GPIO33, amplifier bit clock untouched on GPIO27 — and so is
   the counting rule in 13.1. What remains is that the second output has never been driven:
   no cable, no strip, no measured frame rate with two chains refreshing.
