machadoleonardo94/Echoes-of-Termina/Executable/echoes/projects/Azumi Takahashi - Changing Seasons -Reload- (lopk223)/album.jpg

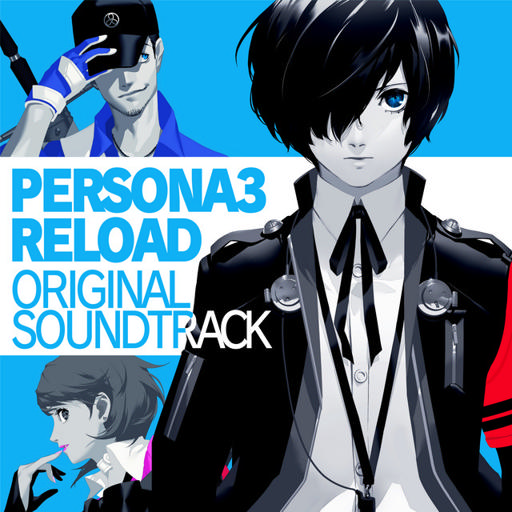
Executable/echoes/projects/Azumi Takahashi - Changing Seasons -Reload- (lopk223)/album.jpg
