machadoleonardo94/Echoes-of-Termina/Firmware/echoes_of_termina/docs/diagrams/button-state-machine.png

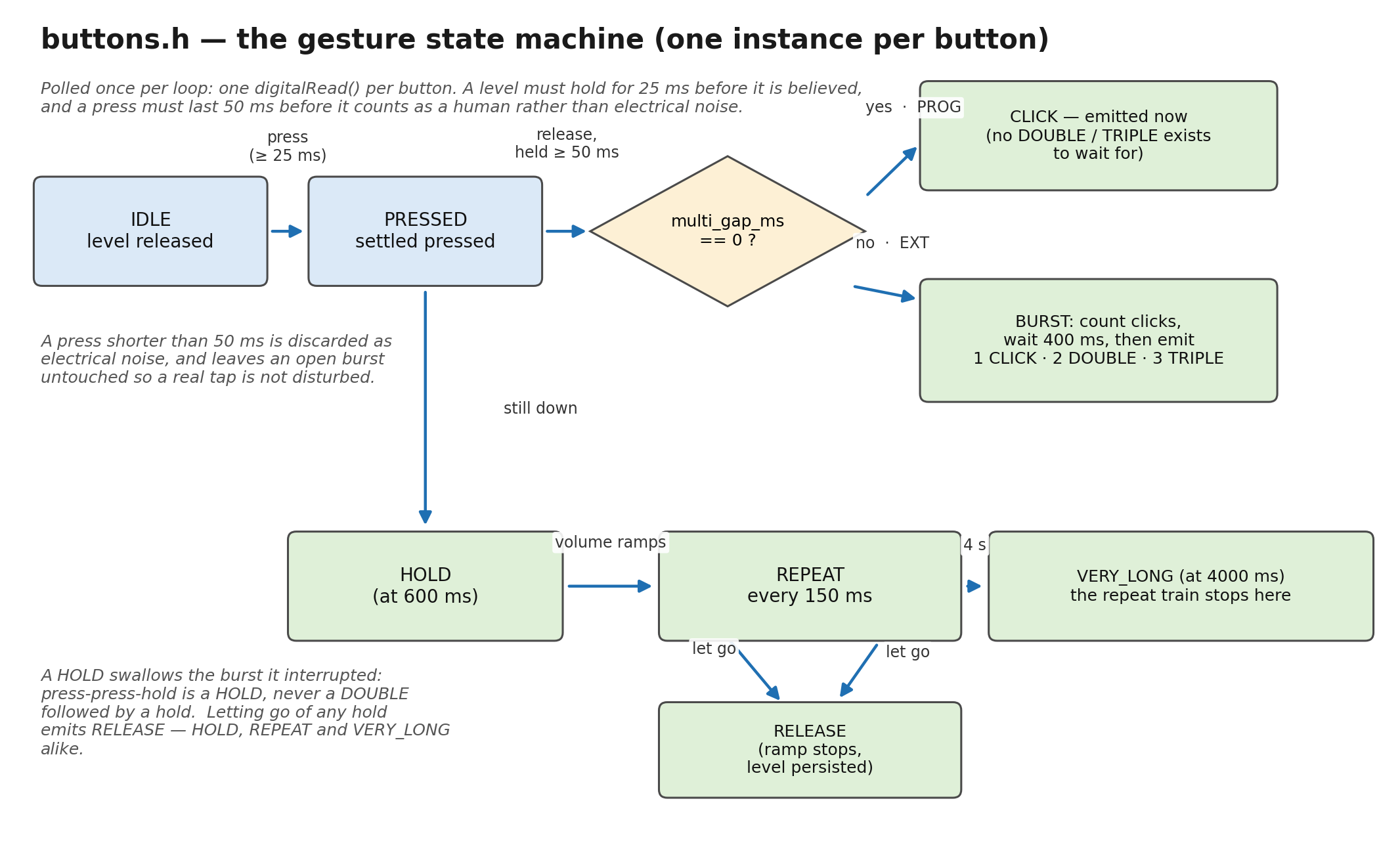
Firmware/echoes_of_termina/docs/diagrams/button-state-machine.png
