machadoleonardo94/Echoes-of-Termina/Firmware/echoes_of_termina/docs/diagrams/feedback-paths.png

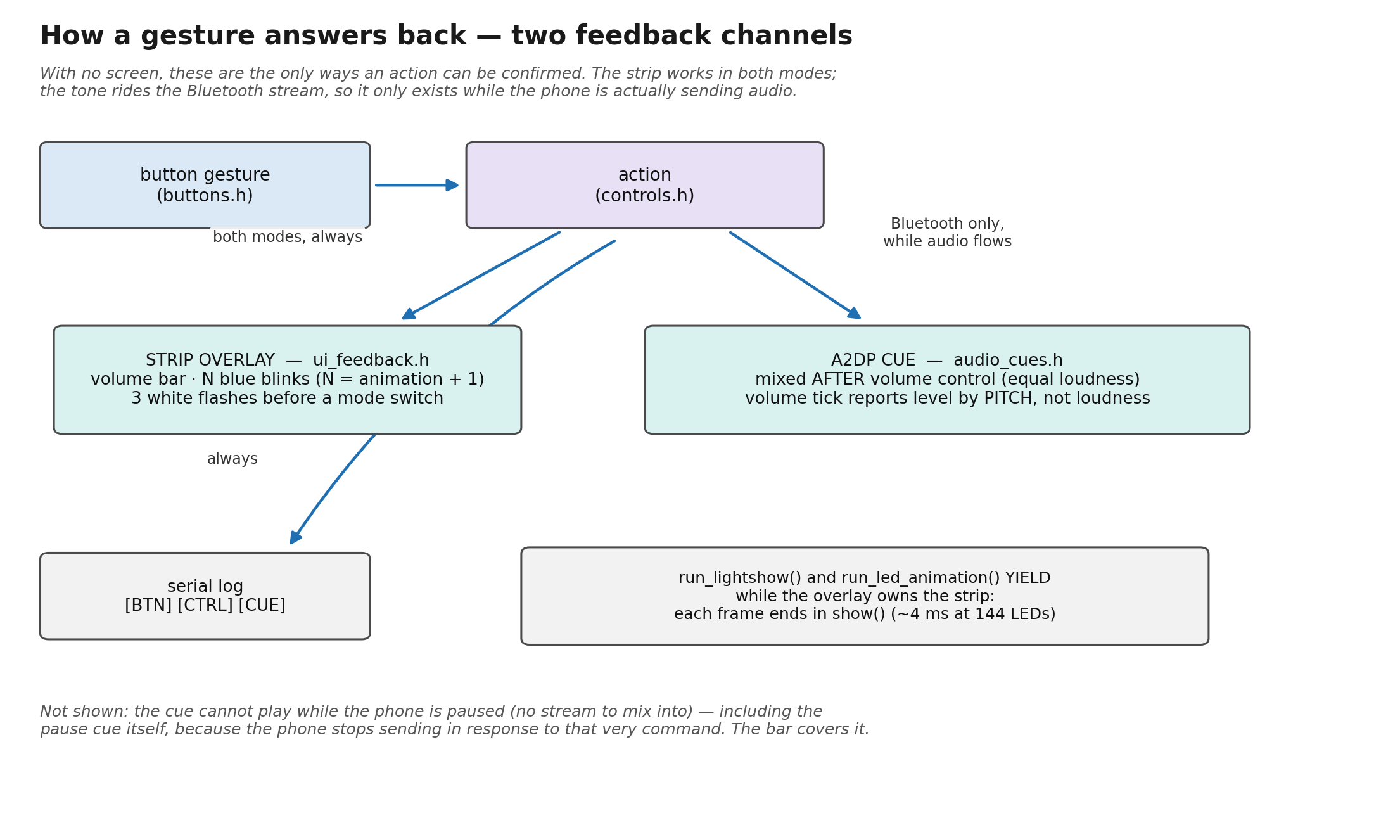
Firmware/echoes_of_termina/docs/diagrams/feedback-paths.png
