machadoleonardo94/Echoes-of-Termina/Firmware/echoes_of_termina/docs/diagrams/gesture-map.png

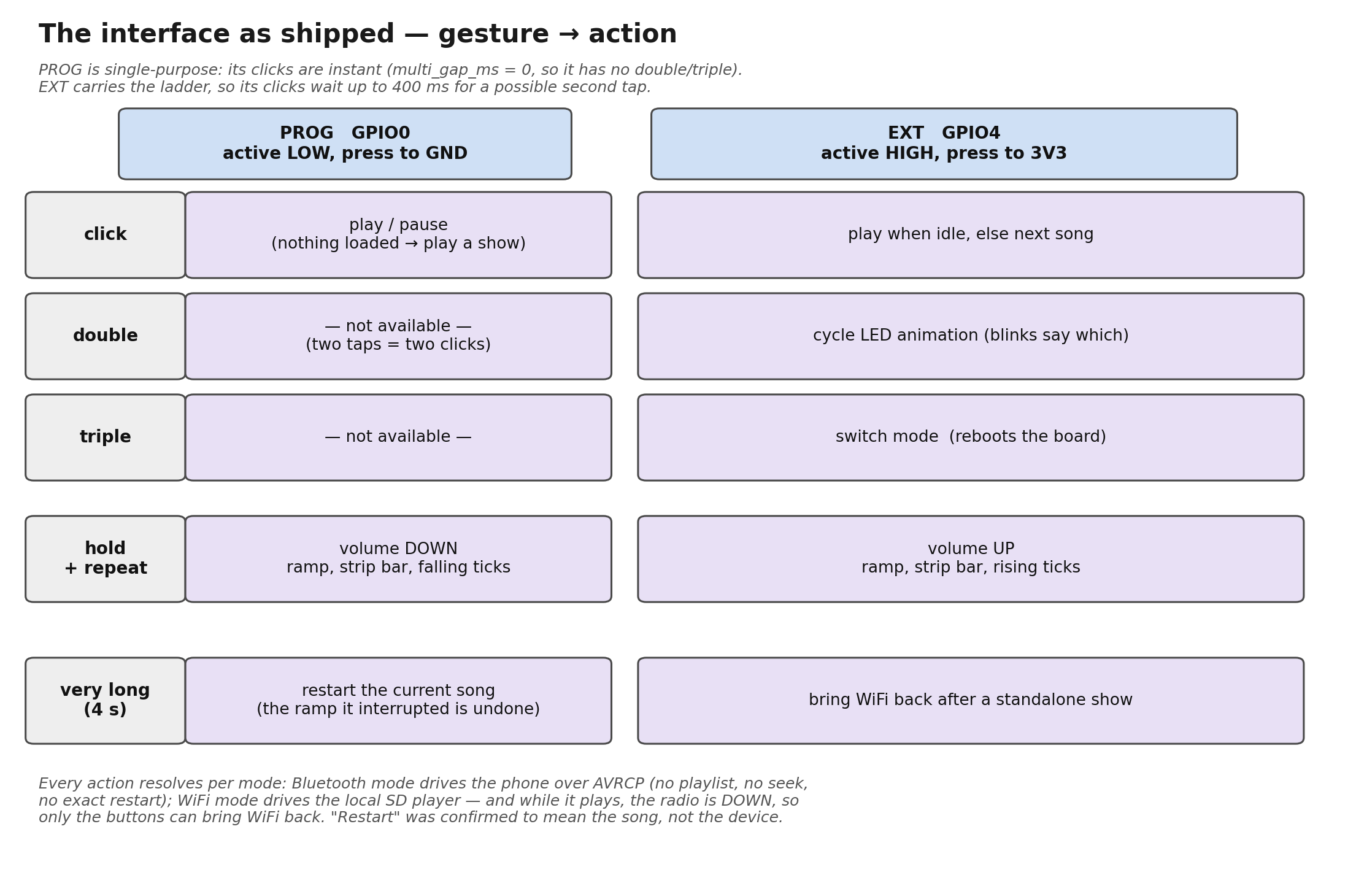
Firmware/echoes_of_termina/docs/diagrams/gesture-map.png
