machadoleonardo94/Echoes-of-Termina/Hardware/Marajoara_V3/Assets/V3.jpg

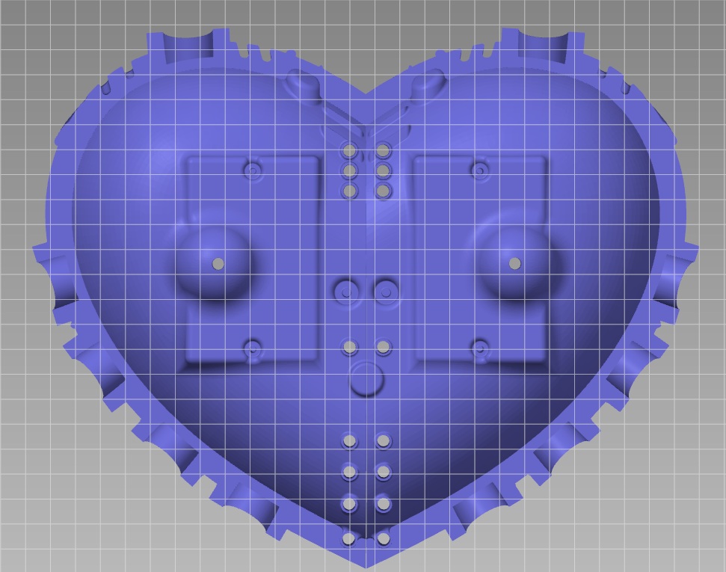
Hardware/Marajoara_V3/Assets/V3.jpg
