machadoleonardo94/Echoes-of-Termina/Hardware/Marajoara_V3/yahaha.jpg

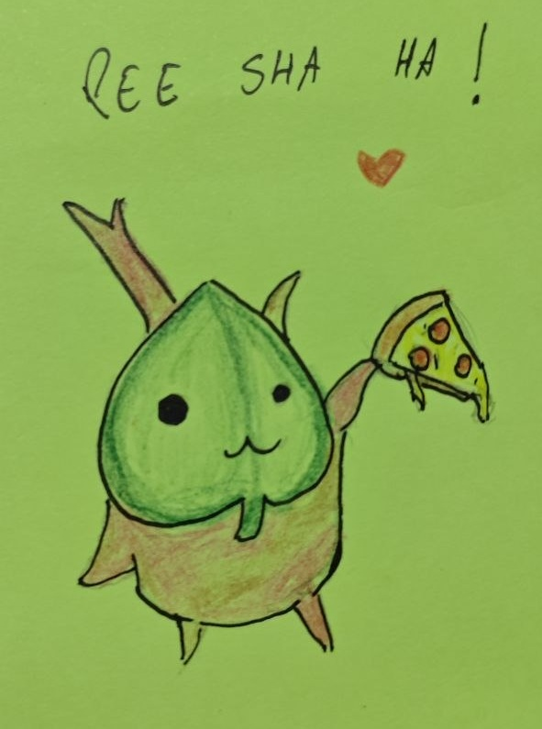
Hardware/Marajoara_V3/yahaha.jpg
