machadoleonardo94/Echoes-of-Termina/Hardware/PCBs/Marajoara_V3/Assets/Marajoara_V3.png

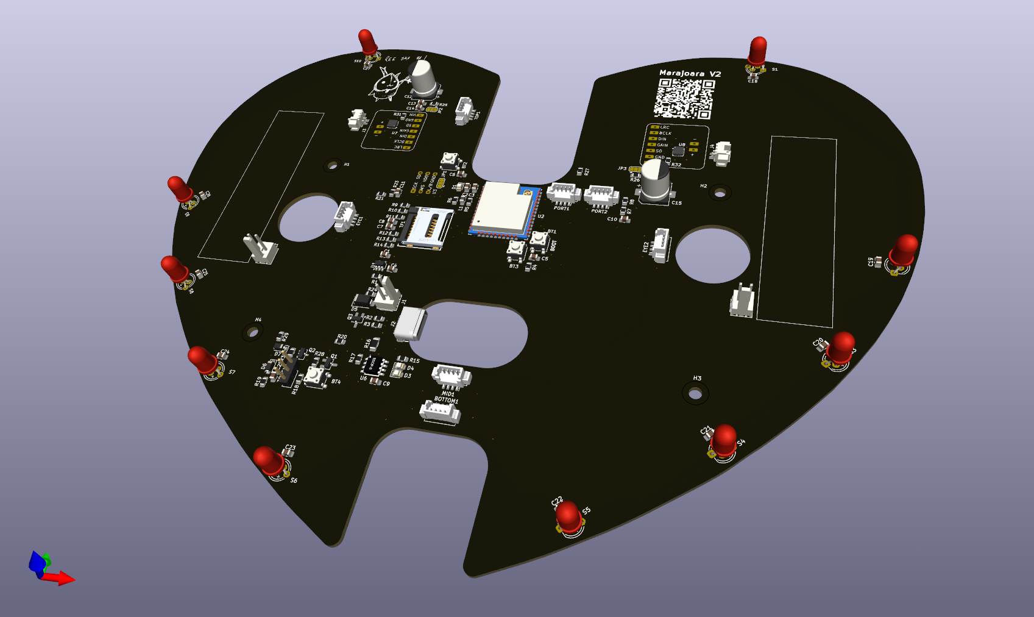
Hardware/PCBs/Marajoara_V3/Assets/Marajoara_V3.png
