machadoleonardo94/Echoes-of-Termina/Media/C3_no_audio_version.jpg

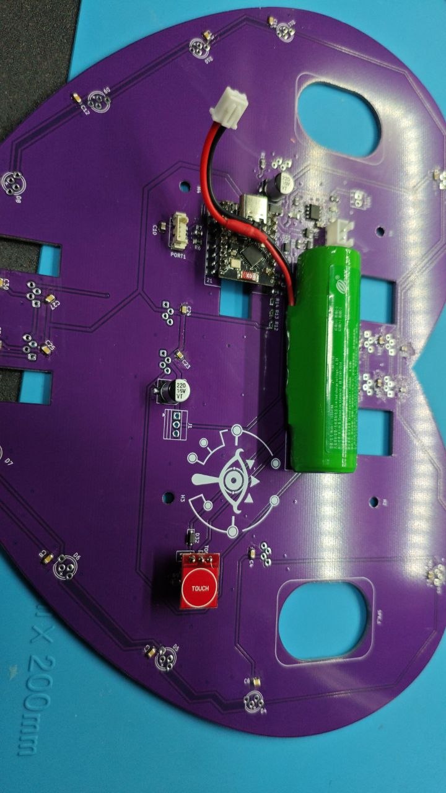
Media/C3_no_audio_version.jpg
