machadoleonardo94/Echoes-of-Termina/Media/Echoes V1 PCB render.jpg

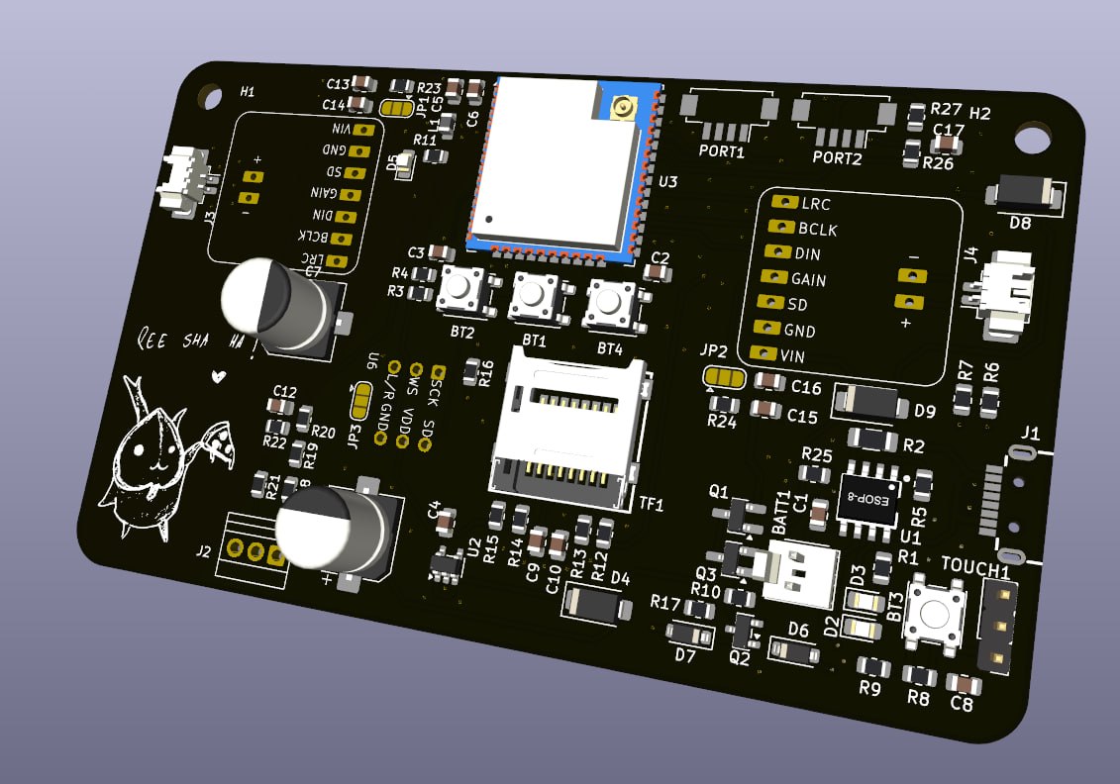
Media/Echoes V1 PCB render.jpg
