machadoleonardo94/Echoes-of-Termina/Media/Echoes V1.jpg

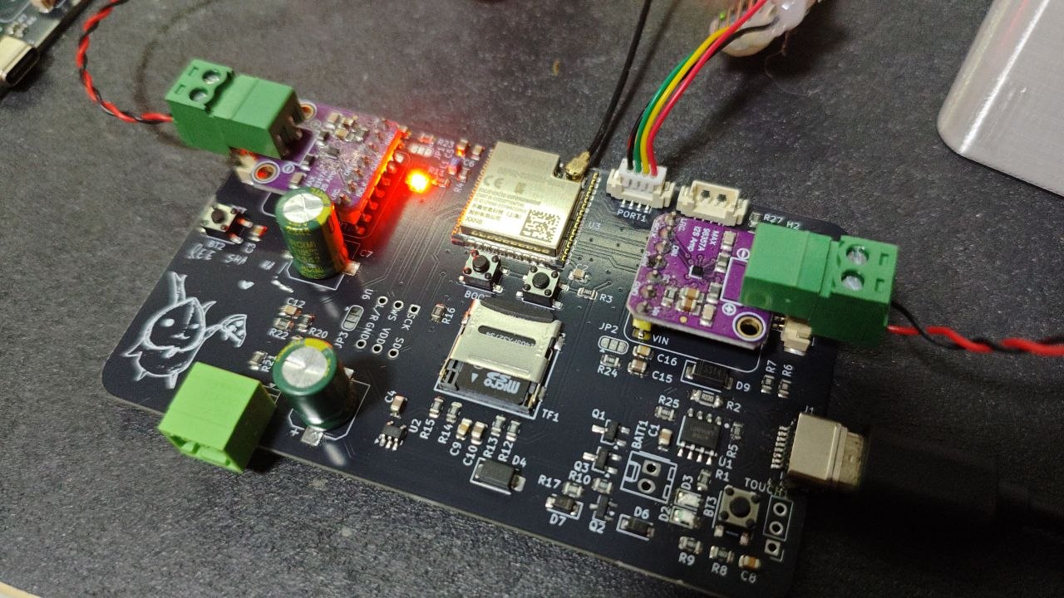
Media/Echoes V1.jpg
