machadoleonardo94/Echoes-of-Termina/Media/Echoes_V1_PCB.jpg

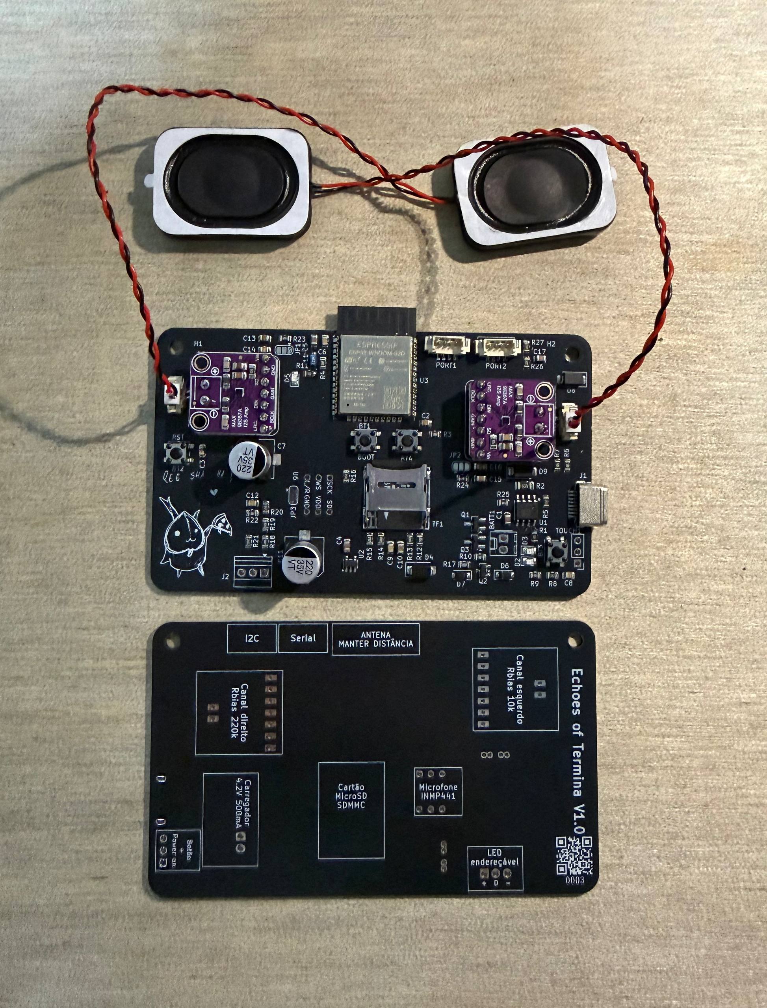
Media/Echoes_V1_PCB.jpg
