machadoleonardo94/Echoes-of-Termina/Media/Executable_example_FFT.jpg

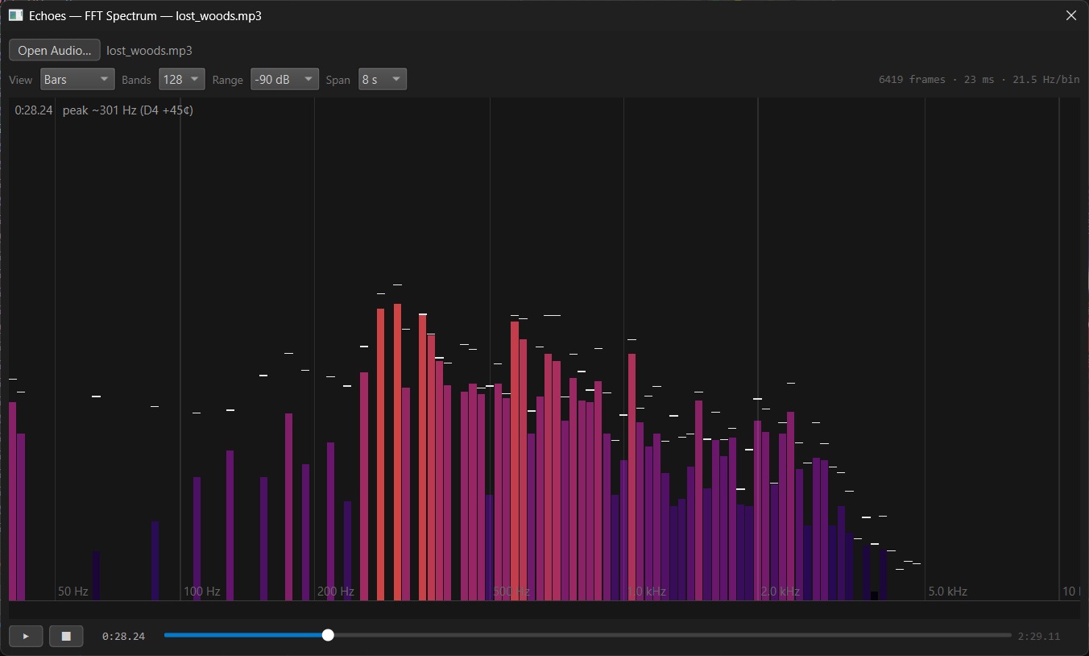
Media/Executable_example_FFT.jpg
