machadoleonardo94/Echoes-of-Termina/Media/PCB + Mask render.jpg

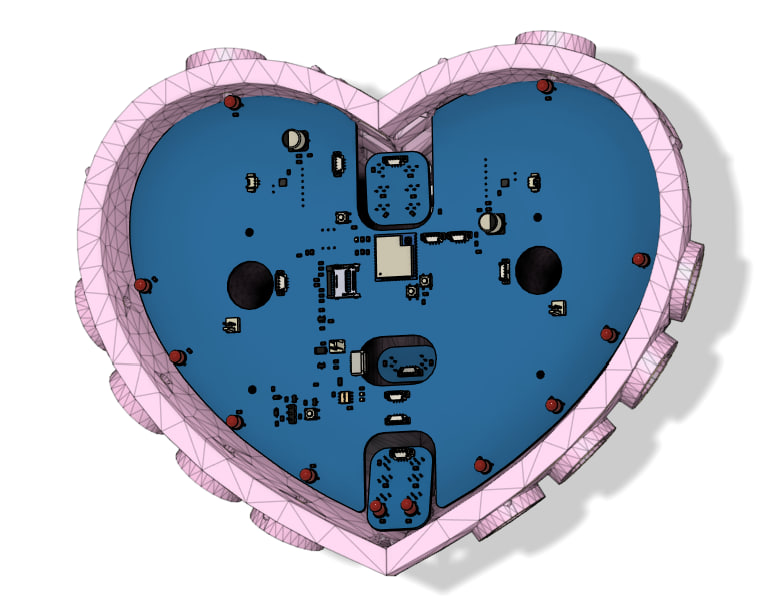
Media/PCB + Mask render.jpg
