machadoleonardo94/Echoes-of-Termina/Hardware/Marajoara_V3/production/bom.csv

Designator | Footprint | Quantity | Value | LCSC Part #
BATT1, BATT2, J1 | Molex_KK-254_AE-6410-02A_1x02_P2.54mm_Vertical | 3 | Conn_01x02_Socket | C49023803
BOTTOM1, EYE1, EYE2, MID1, PORT1, PORT2, TOP1 | Hirose_DF13C_CL535-0404-8-51_1x04-1MP_P1.25mm_Vertical | 7 | Conn_01x04_Socket | C7433470
BT1, BT2, BT3, BT4 | SW_SPST_PTS647_Sx38 | 4 | SW_Push | C2888502
C1, C10, C13, C16, C2, C7, C9 | 0805 | 7 | 10u | C162422
C11, C14, C17, C18, C19, C20, C21, C22, C23, C24, C25, C26, C27, C28, C3, C4, C5, C6, C8 | 0805 | 19 | 100n | C49678
C12, C15 | Cap_polymer | 2 | 220uF | C2162971
D1 | 0805 | 1 | LED_GREEN | C84256
D3 | 0805 | 1 | LED_BLUE | C965817
D4 | 0805 | 1 | LED_RED | C84256
D5 | D_SMA | 1 | SS14 | C2909920
D6, D7 | D_SOD-123 | 2 | 1N4148W | C83528
J2 | USB-C-SMD_GT-USB-7101A | 1 | USB_C_Receptacle_USB2.0_8P | C7469647
J3, J4 | Molex_PicoBlade_53261-0271_1x02-1MP_P1.25mm_Horizontal | 2 | Conn_01x02_Socket | C7433468
L1 | 0805 | 1 | 22n | C108962
Q1, Q3, Q4 | SOT-23_Handsoldering | 3 | PMOS | C42456992
Q2 | SOT-23 | 1 | 2N7002K | C65189
R1, R19, R20, R22, R23, R25, R26, R28 | 0805 | 8 | 100k | C149504
R10, R11, R12, R13, R14, R18, R30, R31, R4, R5, R9 | 0805 | 11 | 10k | C17414
R15, R17, R6, R7, R8 | 0805 | 5 | 2.2k | C17520
R16 | 1206 | 1 | 220mR 1W 1% | C2683384
R2, R3 | 0805 | 2 | 5.1k | C27834
R21, R32 | 0805 | 2 | 220k | C149504
R27, R29 | 0805 | 2 | 330 | C17630
S1, S10, S2, S3, S4, S5, S6, S7, S8, S9 | WS2812B_PTH_staggered | 10 | WS2812B
TF1 | TF-SMD_TF-CARD-XG8P-H1.5 | 1 | microSD tray
TOUCH1 | PinHeader_1x03_P2.54mm_Vertical | 1 | Conn_01x03_Socket
U1 | SOT-23-5 | 1 | AP2112K-3.3 | C51118
U2 | ESP32-WROOM-32U | 1 | ESP32-WROOM-32-N8R2 | C5361945
U3 | INMP441 Module | 1 | INMP441
U6 | ESOP-8_L4.9-W3.9-P1.27-LS6.0-BL-EP | 1 | TP4056 | C382139
U7, U8 | TQFN-16_L3.0-W3.0-P0.50-BL-EP1.5 | 2 | MAX98357AETE+T | C910544
