machadoleonardo94/Echoes-of-Termina/Hardware/Bottom_8_WS2812B/production/bom.csv

Designator | Footprint | Quantity | Value | LCSC Part #
BOT1 | Hirose_DF13C_CL535-0404-8-51_1x04-1MP_P1.25mm_Vertical | 1 | Conn_01x04_Socket | C7433470
C1, C2, C3, C4, C5, C6, C7, C8 | 0805 | 8 | 100n | C49678
U1, U2, U3, U4, U5, U6, U7, U8 | WS2812B_PTH_staggered | 8 | WS2812B
