machadoleonardo94/Echoes-of-Termina/Hardware/Marajoara_V3/Assets/Marajoara V3 - full.dxf

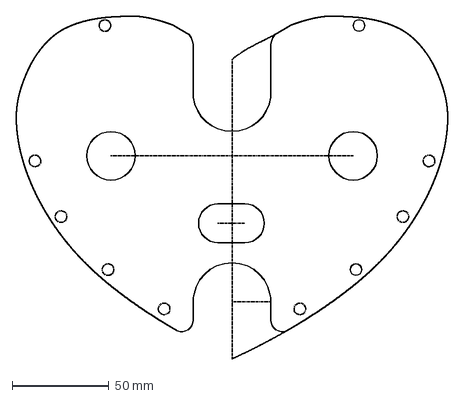
[picture p18: CAD file, 2026-09-07]
Hardware/Marajoara_V3/Assets/Marajoara V3 - full.dxf
222.6 x 176.9 mm
