machadoleonardo94/Echoes-of-Termina/Hardware/Printed parts/Speaker_40mm_Case/export/assembly.stl

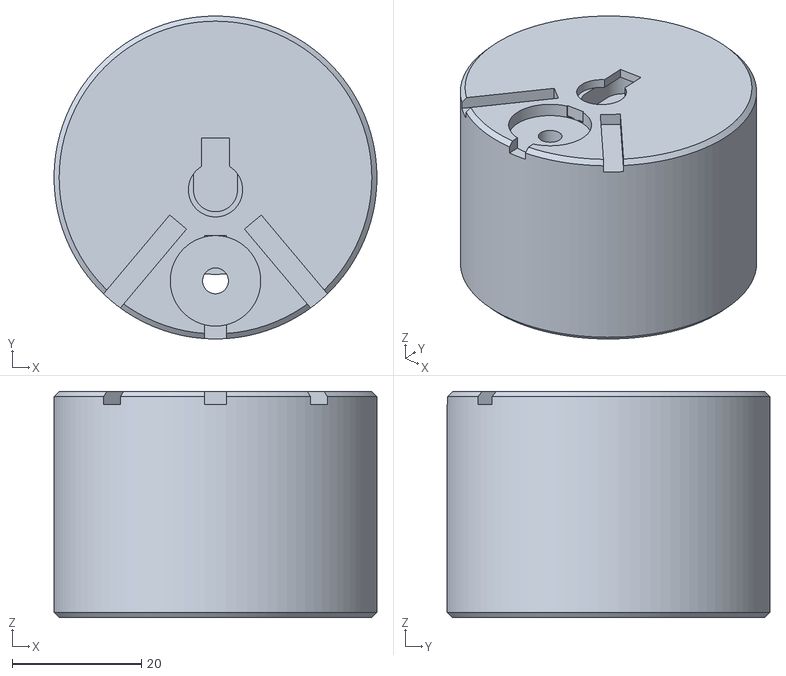
[picture p19: CAD file, 2026-10-22]
Hardware/Printed parts/Speaker_40mm_Case/export/assembly.stl
50.0 x 50.0 x 35.0
