machadoleonardo94/Echoes-of-Termina/Executable/echoes/assets/echoes_outline.dxf

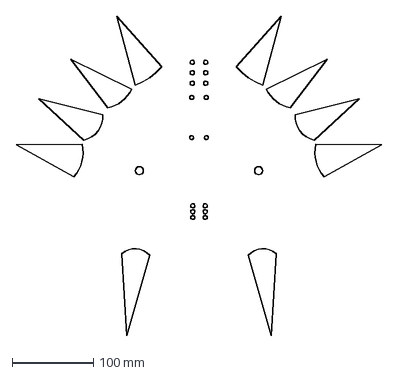
[picture p20: CAD file, 2026-08-06]
Executable/echoes/assets/echoes_outline.dxf
448.9 x 392.3 mm
