machadoleonardo94/Echoes-of-Termina/Firmware/Executable/echoes/assets/LED_order.dxf

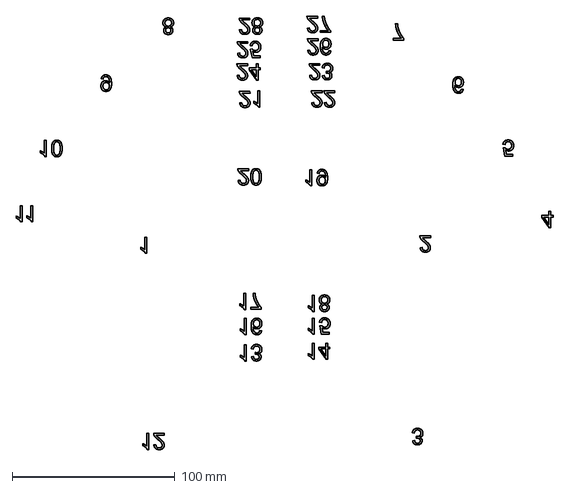
[picture p21: CAD file, 2026-08-06]
Firmware/Executable/echoes/assets/LED_order.dxf
329.5 x 265.9 mm
