machadoleonardo94/Echoes-of-Termina/Hardware/Bottom_8_WS2812B/Bottom LEDs.dxf

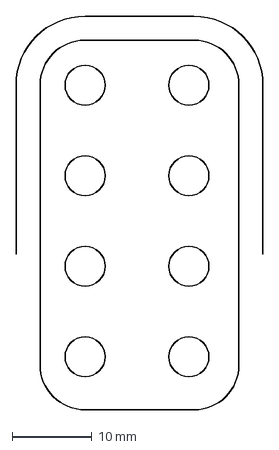
[picture p22: CAD file, 2026-09-29]
Hardware/Bottom_8_WS2812B/Bottom LEDs.dxf
30.9 x 49.3 mm
