machadoleonardo94/Echoes-of-Termina/Hardware/Marajoara_V3/Assets/Echoes Base 35.dxf

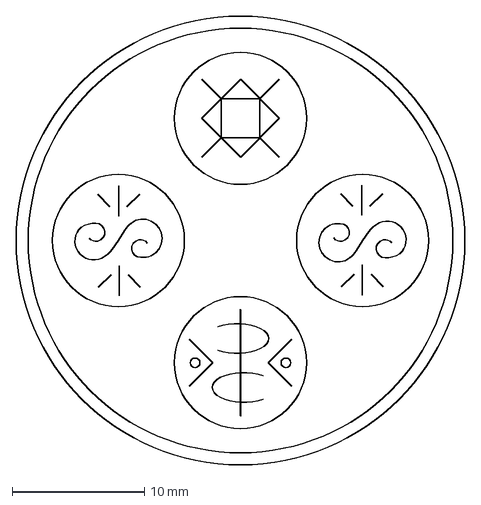
[picture p23: CAD file, 2026-09-29]
Hardware/Marajoara_V3/Assets/Echoes Base 35.dxf
34.0 x 34.0 mm
