machadoleonardo94/Echoes-of-Termina/Hardware/Marajoara_V3/Marajoara_V3.step

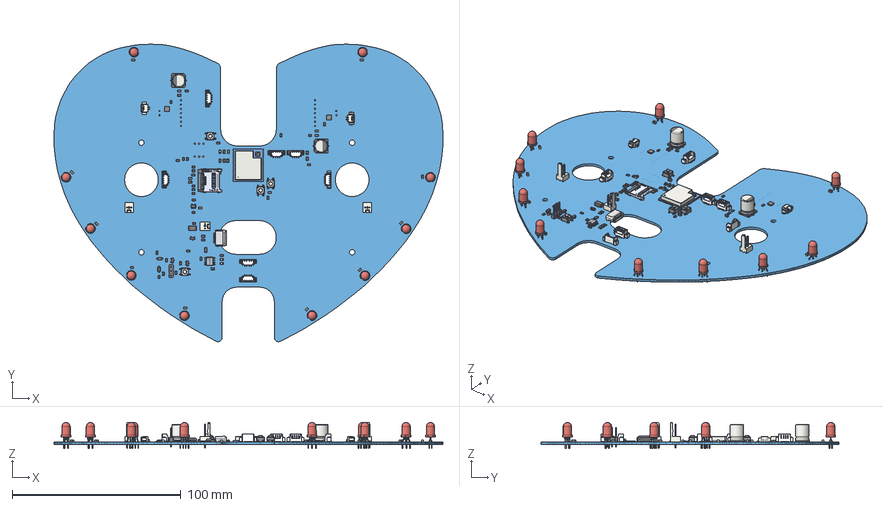
[picture p24: CAD file, 2026-09-29]
Hardware/Marajoara_V3/Marajoara_V3.step
230.7 x 176.5 x 15.7 mm
CONN-SMD_4P-P1.25_HCZZ0015-4 x 7
C_0805_2012Metric x 26
LED_0805_2012Metric x 3
R_1206_3216Metric
R_0805_2012Metric x 30
SW_SPST_PTS647Sx38 x 4
Marajoara_V3 1.10.1
LED_D5.0mm-4_RGB_Staggered_Pins x 10
Molex_KK-254_AE-6410-02A_1x02_P2.54mm_Vertical x 3
L_0805_2012Metric
D_SMA
Molex_PicoBlade_53261-0271_1x02-1MP_P1.25mm_Horizontal x 2
SOT-23 x 3
D_SOD-123 x 2
TQFN-16_L3.0-W3.0-P0.50-BL-EP1.5 x 2
CP_Elec_8x10.5 x 2
USB-C-SMD_GT-USB-7101A
PinHeader_1x03_P2.54mm_Vertical
ESP32-WROOM-32U
SOT-23-5
Marajoara_V3_PCB
