machadoleonardo94/Echoes-of-Termina/Hardware/Mid_2_WS2812B/Mid_2_WS2812B.step

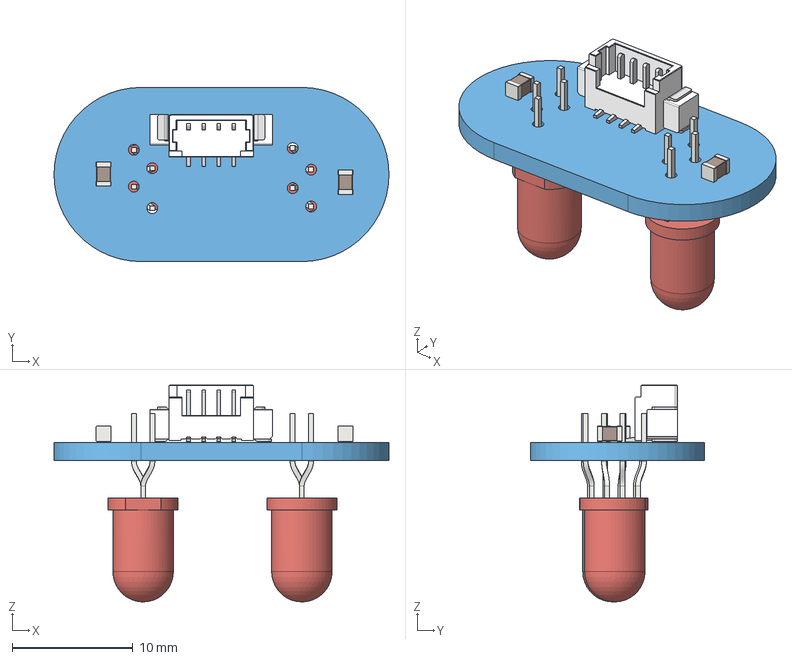
[picture p25: CAD file, 2026-09-29]
Hardware/Mid_2_WS2812B/Mid_2_WS2812B.step
27.7 x 14.4 x 17.9 mm
C_0805_2012Metric x 2
CONN-SMD_4P-P1.25_HCZZ0015-4
LED_D5.0mm-4_RGB_Staggered_Pins x 2
Mid_2_WS2812B_PCB
