machadoleonardo94/Echoes-of-Termina/Hardware/PCBs/Echoes_V2/Echoes_V2.step

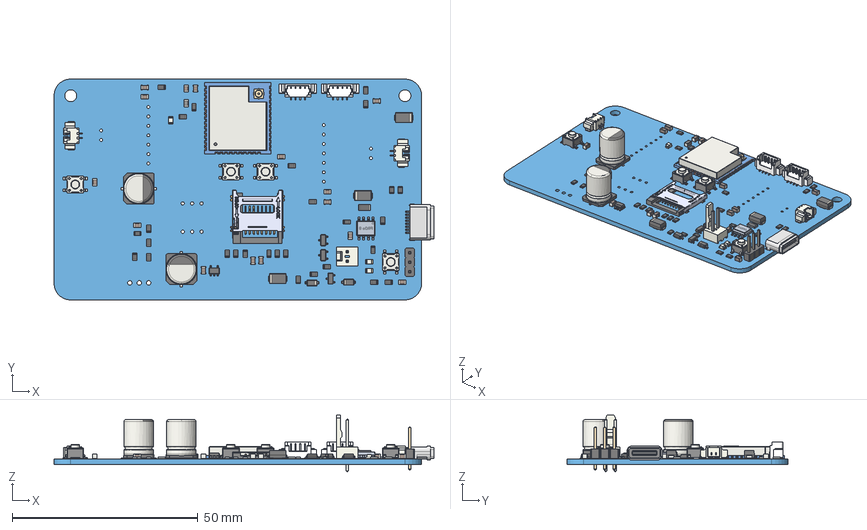
[picture p26: CAD file, 2026-10-22]
Hardware/PCBs/Echoes_V2/Echoes_V2.step
102.3 x 59.5 x 15.3 mm
CONN-SMD_4P-P1.25_HCZZ0015-4 x 2
LED_0805_2012Metric x 3
R_0805_2012Metric x 28
SW_SPST_PTS647Sx38 x 4
C_0805_2012Metric x 15
L_0805_2012Metric
SOT-23 x 3
D_SMA x 3
D_SOD-123 x 2
Molex_PicoBlade_53261-0271_1x02-1MP_P1.25mm_Horizontal x 2
Molex_KK-254_AE-6410-02A_1x02_P2.54mm_Vertical
R_1206_3216Metric
CP_Elec_8x10.5 x 2
SOT-23-5
Echoes_of_Termina 1.58.1
ESP32-WROOM-32U
PinHeader_1x03_P2.54mm_Vertical
USB-C-SMD_GT-USB-7101A
Echoes_of_Termina_PCB
