machadoleonardo94/Echoes-of-Termina/Hardware/PCBs/LED breakout boards/Bottom_8_WS2812B/Bottom_8_WS2812B.step

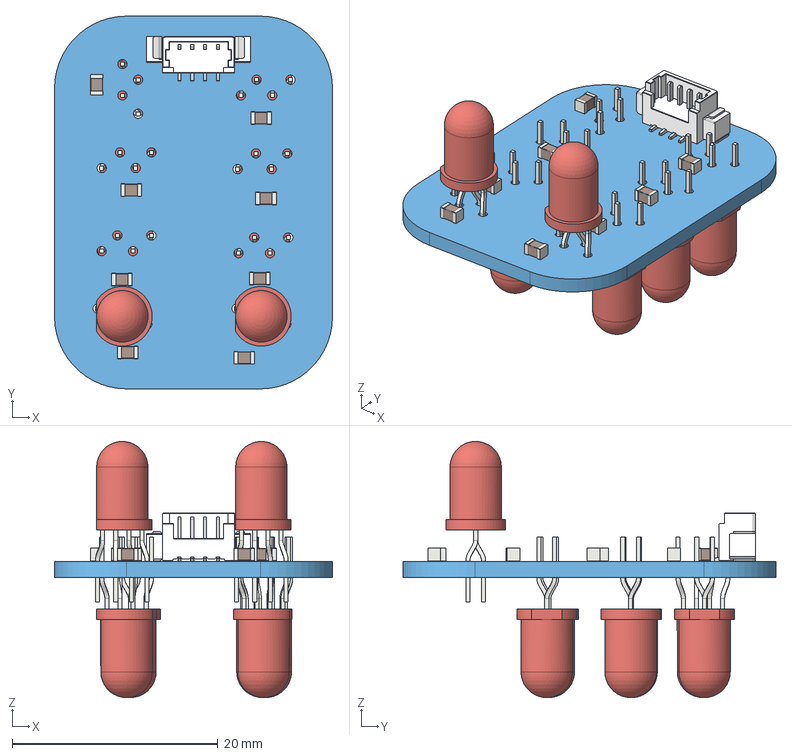
[picture p27: CAD file, 2026-10-22]
Hardware/PCBs/LED breakout boards/Bottom_8_WS2812B/Bottom_8_WS2812B.step
27.0 x 36.2 x 24.9 mm
C_0805_2012Metric x 8
LED_D5.0mm-4_RGB_Staggered_Pins x 8
CONN-SMD_4P-P1.25_HCZZ0015-4
Bottom_8_WS2812B_PCB
