machadoleonardo94/Echoes-of-Termina/Hardware/PCBs/Marajoara_V3/Assets/Echoes Base.dxf

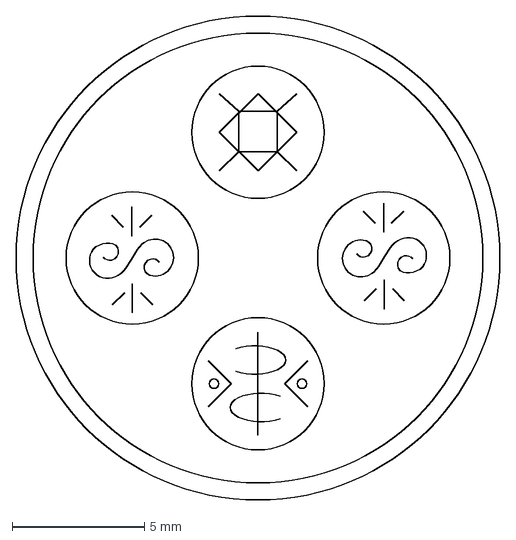
[picture p28: CAD file, 2026-10-22]
Hardware/PCBs/Marajoara_V3/Assets/Echoes Base.dxf
18.3 x 18.3 mm
