machadoleonardo94/Echoes-of-Termina/Hardware/Printed parts/Basic Echoes case/Echoes tampa.stl

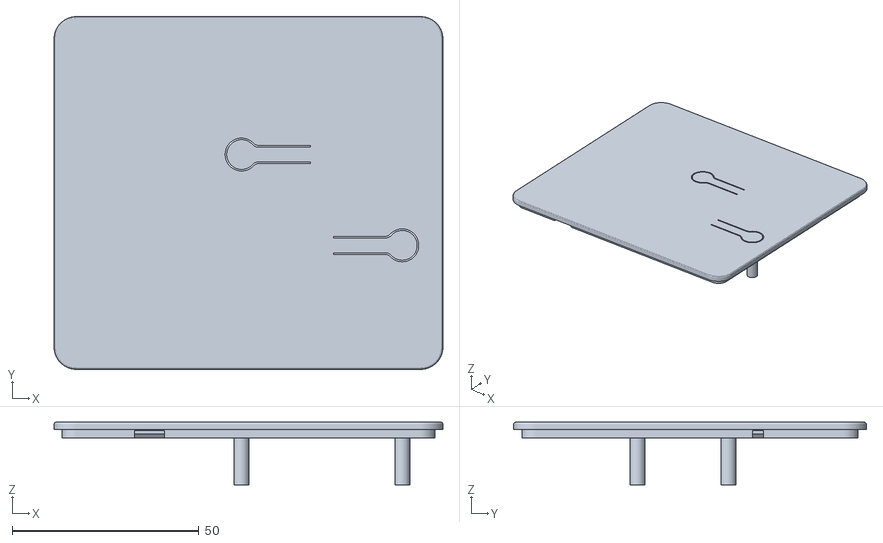
[picture p29: CAD file, 2026-10-22]
Hardware/Printed parts/Basic Echoes case/Echoes tampa.stl
104.2 x 94.5 x 16.8
