machadoleonardo94/Echoes-of-Termina/Hardware/Printed parts/Speaker_40mm_Case/export/print_plate.stl

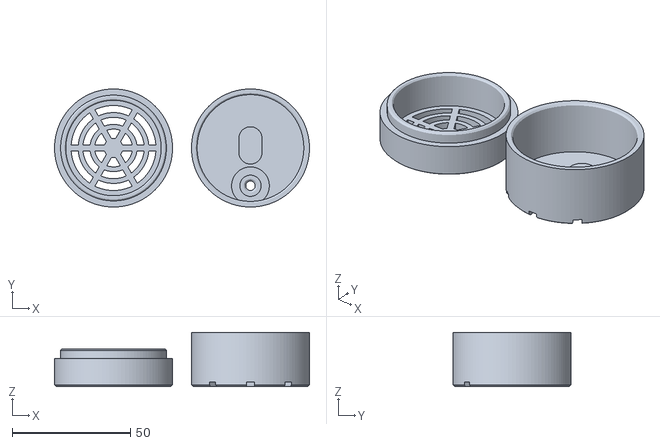
[picture p30: CAD file, 2026-10-22]
Hardware/Printed parts/Speaker_40mm_Case/export/print_plate.stl
108.0 x 50.0 x 23.0
