machadoleonardo94/Echoes-of-Termina/Hardware/Printed parts/Speaker_40mm_Case/Fusion360/Spk 40mm Faceplate v1.stl

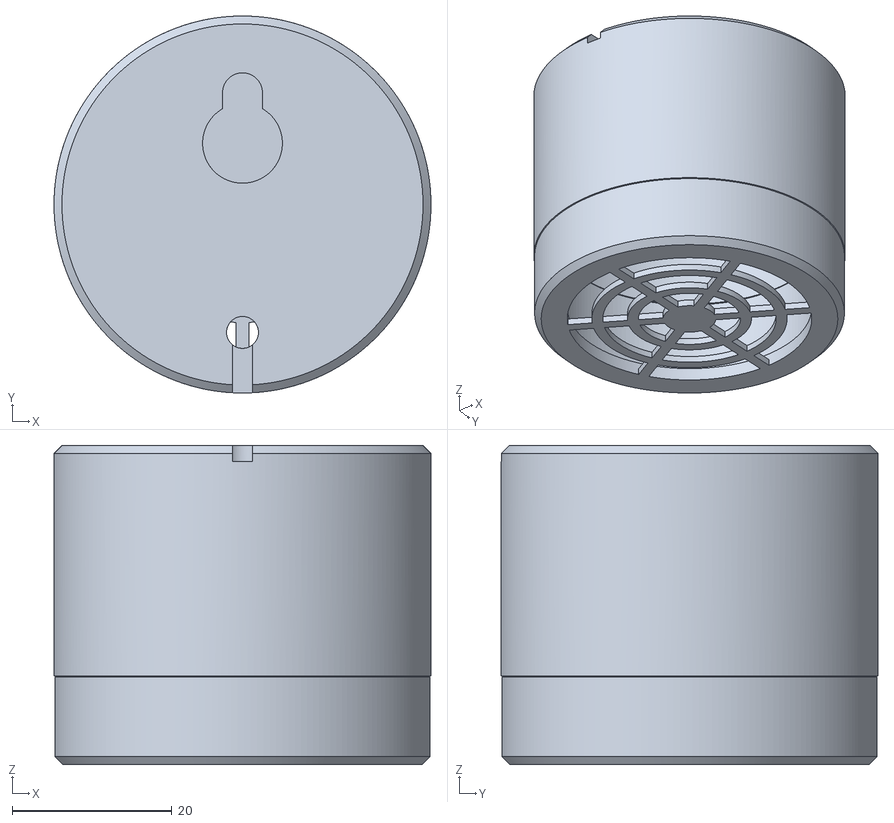
[picture p31: CAD file, 2026-10-22]
Hardware/Printed parts/Speaker_40mm_Case/Fusion360/Spk 40mm Faceplate v1.stl
47.2 x 47.2 x 40.0
