machadoleonardo94/Echoes-of-Termina/Hardware/Top_6_WS2812B/Top_6_WS2812B.step

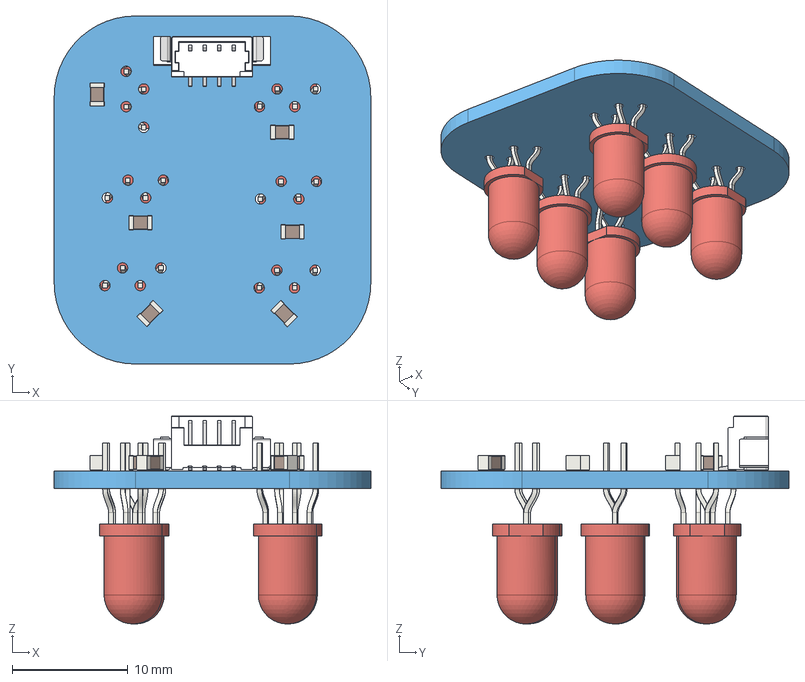
[picture p32: CAD file, 2026-09-29]
Hardware/Top_6_WS2812B/Top_6_WS2812B.step
27.3 x 30.0 x 17.9 mm
C_0805_2012Metric x 6
CONN-SMD_4P-P1.25_HCZZ0015-4
LED_D5.0mm-4_RGB_Staggered_Pins x 6
Top_6_WS2812B_PCB
