machadoleonardo94/Echoes-of-Termina/Firmware/Executable/echoes/assets/areas_clean.dxf

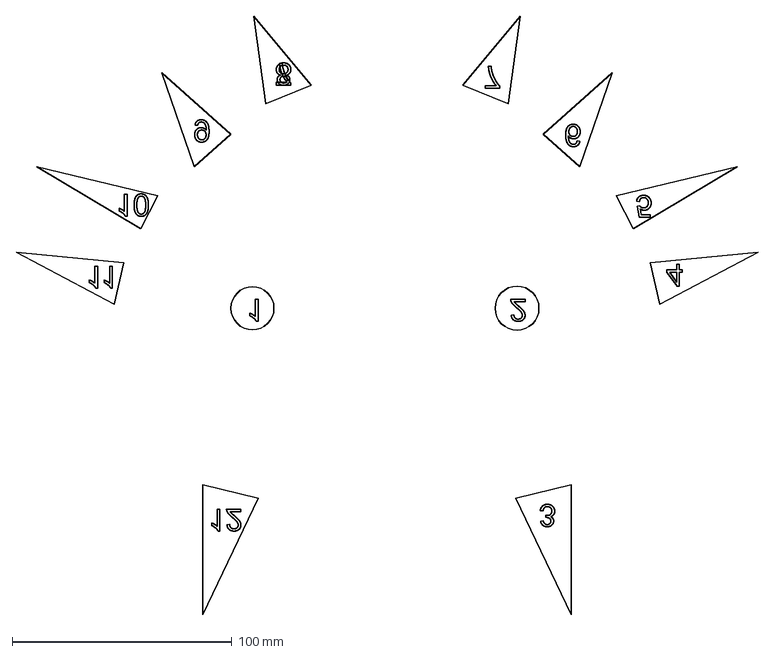
[picture p33: CAD file, 2026-08-06]
Firmware/Executable/echoes/assets/areas_clean.dxf
337.5 x 272.4 mm
