machadoleonardo94/Echoes-of-Termina/Hardware/Marajoara_V3/Assets/majora low poly 1-10.stl

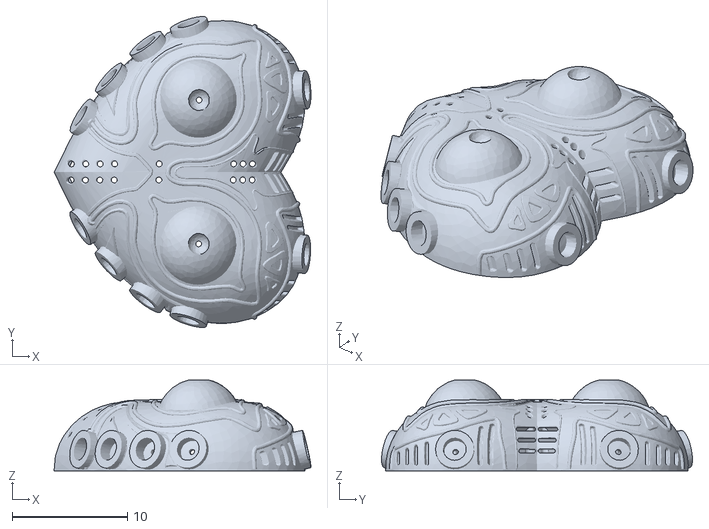
[picture p34: CAD file, 2026-09-29]
Hardware/Marajoara_V3/Assets/majora low poly 1-10.stl
22.3 x 27.0 x 7.88
