machadoleonardo94/Echoes-of-Termina/Hardware/Printed parts/Basic Echoes case/Echoes base.stl

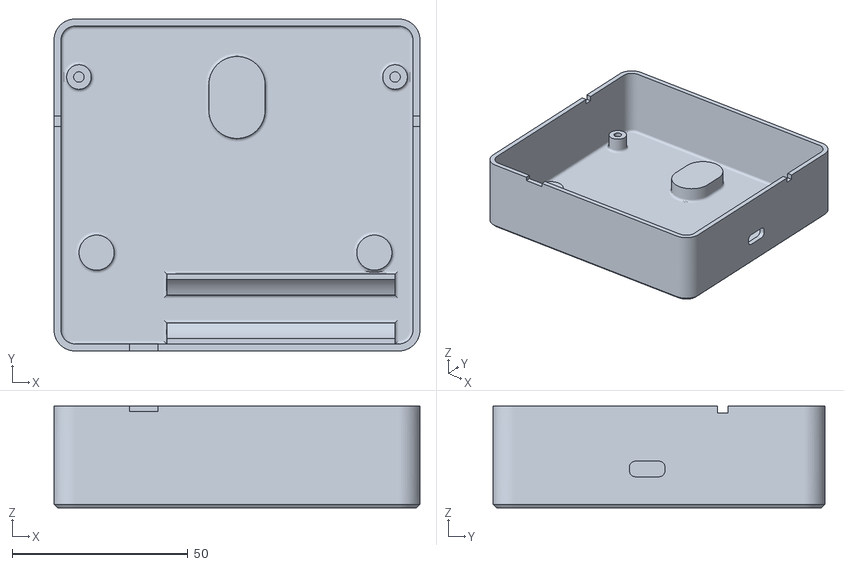
[picture p36: CAD file, 2026-10-22]
Hardware/Printed parts/Basic Echoes case/Echoes base.stl
104.2 x 94.5 x 29.0
