machadoleonardo94/Echoes-of-Termina/Hardware/Printed parts/Speaker_40mm_Case/export/part_A_front_bezel.stl

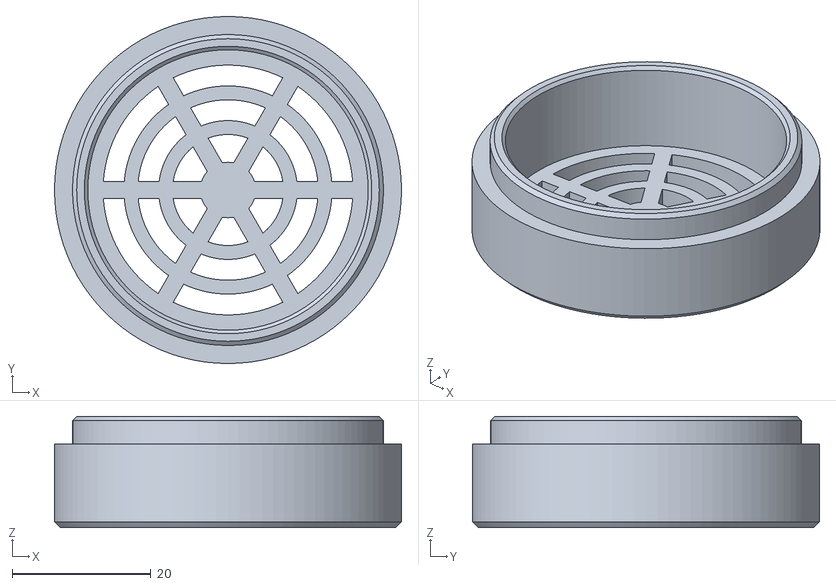
[picture p37: CAD file, 2026-10-22]
Hardware/Printed parts/Speaker_40mm_Case/export/part_A_front_bezel.stl
50.0 x 50.0 x 16.0
