machadoleonardo94/Echoes-of-Termina/Hardware/Speaker_40mm_Case/export/cavity.stl

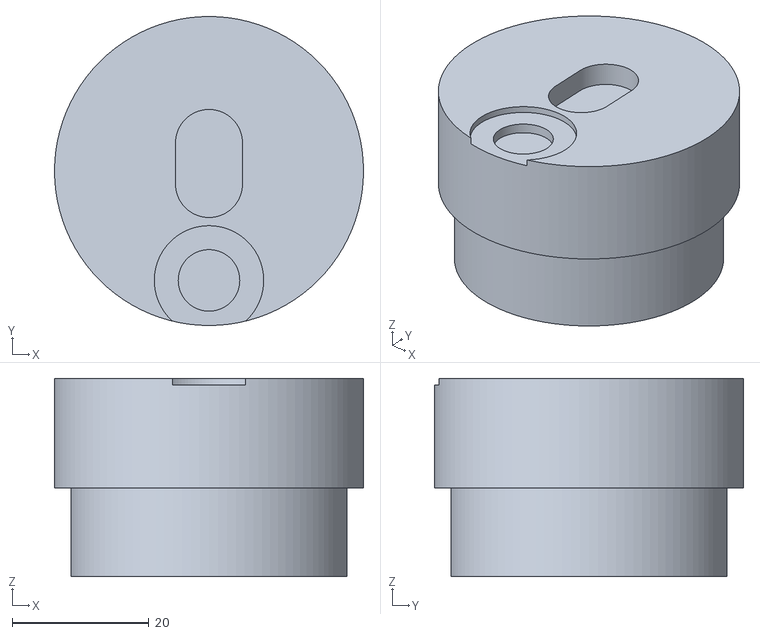
[picture p38: CAD file, 2026-10-21]
Hardware/Speaker_40mm_Case/export/cavity.stl
45.2 x 45.2 x 29.0
