machadoleonardo94/Echoes-of-Termina/Hardware/Top_6_WS2812B/Top LEDs.dxf

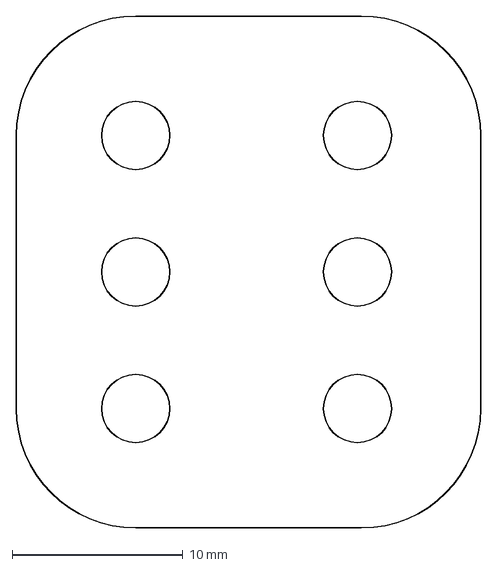
[picture p39: CAD file, 2026-09-29]
Hardware/Top_6_WS2812B/Top LEDs.dxf
27.2 x 30.0 mm
