machadoleonardo94/Echoes-of-Termina/Firmware/Executable/echoes/assets/LED_order2.dxf

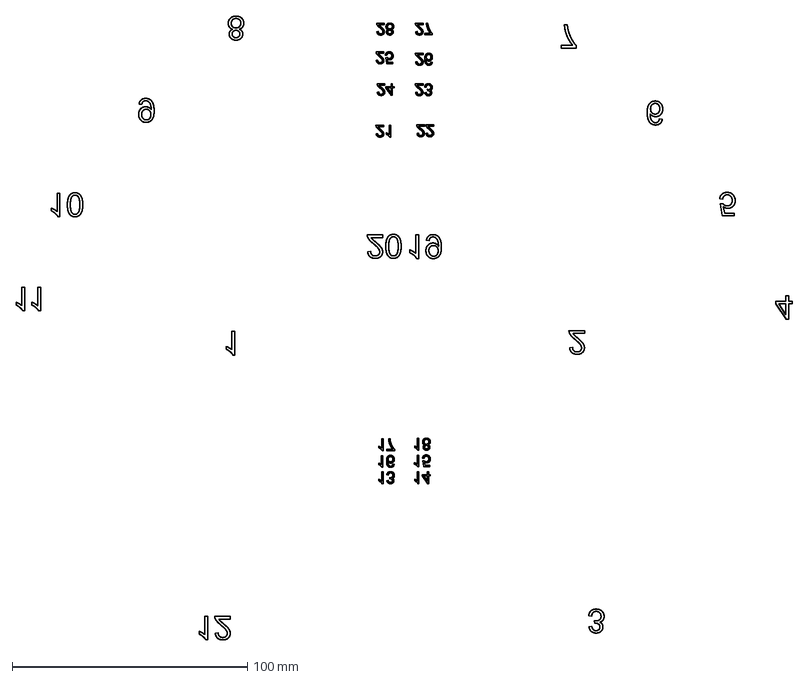
[picture p40: CAD file, 2026-08-06]
Firmware/Executable/echoes/assets/LED_order2.dxf
329.5 x 264.9 mm
