machadoleonardo94/Echoes-of-Termina/Hardware/Marajoara_V3/Assets/majora low poly.stl

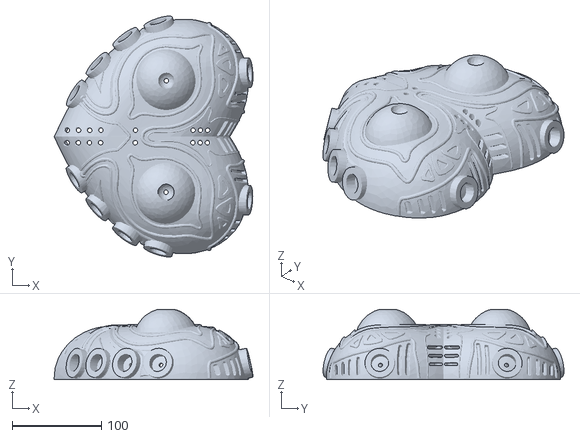
[picture p41: CAD file, 2026-09-29]
Hardware/Marajoara_V3/Assets/majora low poly.stl
223.0 x 270.0 x 78.8
