machadoleonardo94/Echoes-of-Termina/Hardware/PCBs/Marajoara_V3/Assets/V3_rough_sketch.stl

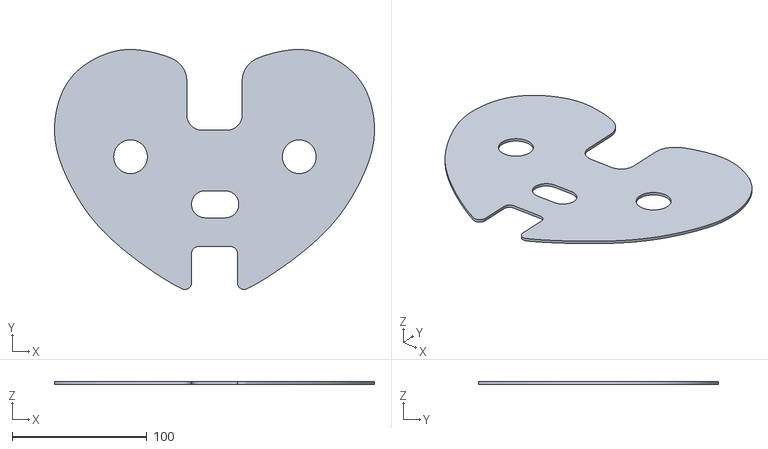
[picture p42: CAD file, 2026-10-22]
Hardware/PCBs/Marajoara_V3/Assets/V3_rough_sketch.stl
237.2 x 177.9 x 2.00
