machadoleonardo94/Echoes-of-Termina/Hardware/Printed parts/Speaker_40mm_Case/export/part_B_back_cup.stl

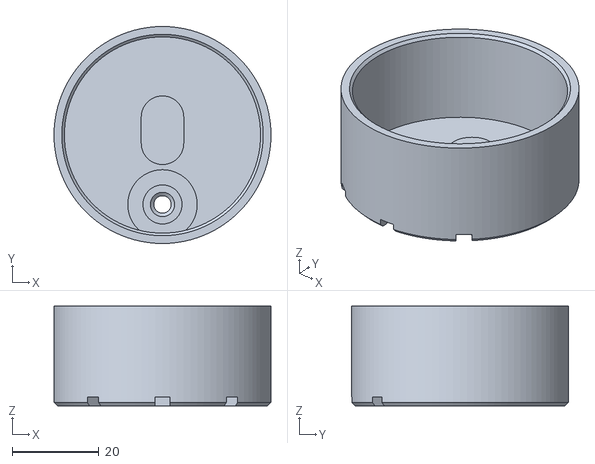
[picture p43: CAD file, 2026-10-22]
Hardware/Printed parts/Speaker_40mm_Case/export/part_B_back_cup.stl
50.0 x 50.0 x 23.0
