machadoleonardo94/Echoes-of-Termina/Firmware/Executable/echoes/assets/LED_areas.dxf

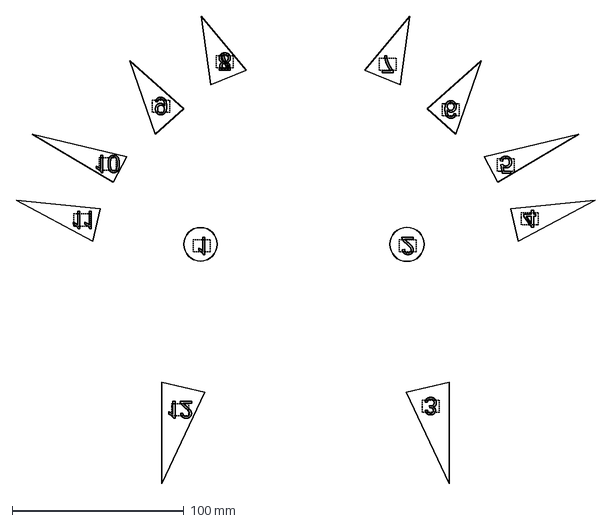
[picture p44: CAD file, 2026-08-06]
Firmware/Executable/echoes/assets/LED_areas.dxf
337.5 x 272.4 mm
