machadoleonardo94/Echoes-of-Termina/Hardware/PCBs/Marajoara_V3/Assets/ugauga.step

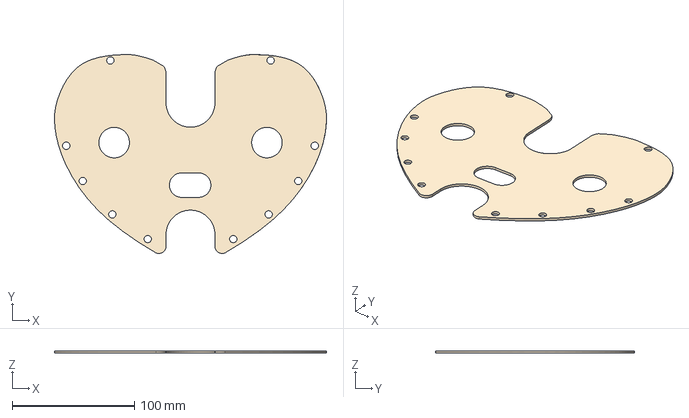
[picture p45: CAD file, 2026-10-22]
Hardware/PCBs/Marajoara_V3/Assets/ugauga.step
222.6 x 162.8 x 2.00 mm
