machadoleonardo94/Echoes-of-Termina/Hardware/Marajoara_V3/Assets/Marajoara V3.dxf

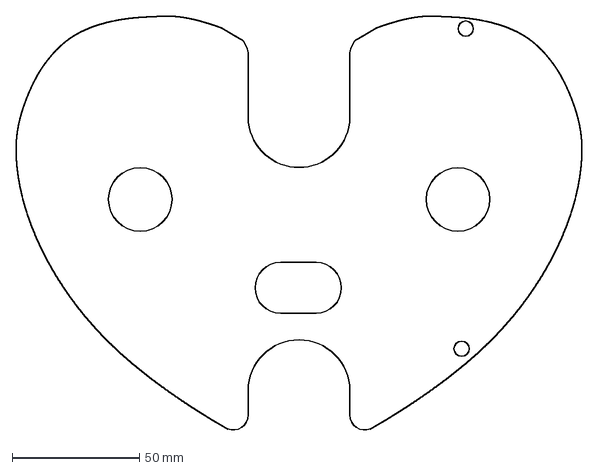
[picture p46: CAD file, 2026-09-07]
Hardware/Marajoara_V3/Assets/Marajoara V3.dxf
222.6 x 163.1 mm
