machadoleonardo94/Echoes-of-Termina/(list of files, cad)

Other CAD files:
Hardware/Speaker_40mm_Case/export/section_2d_case.dxf
Hardware/Speaker_40mm_Case/Fusion360/Spk 40mm Faceplate.step
Executable/Echoes_V2/assets/echoes_timesheet.dxf
Hardware/Echoes_of_Termina/Case/Echoes base.stl
Hardware/Echoes_of_Termina/Case/Echoes tampa.stl
Hardware/PCBs/Marajoara_V2/STEPs and 3D printing/Marajoara V2.dxf
Hardware/PCBs/Marajoara_V2/STEPs and 3D printing/V2_body.dxf
Hardware/Printed parts/Basic Echoes case/Echoes box.f3z
Hardware/Printed parts/Speaker_40mm_Case/Fusion360/Spk 40mm Faceplate.f3d
