machadoleonardo94/Echoes-of-Termina/Hardware/Echoes_of_Termina/Echoes_of_Termina.pdf

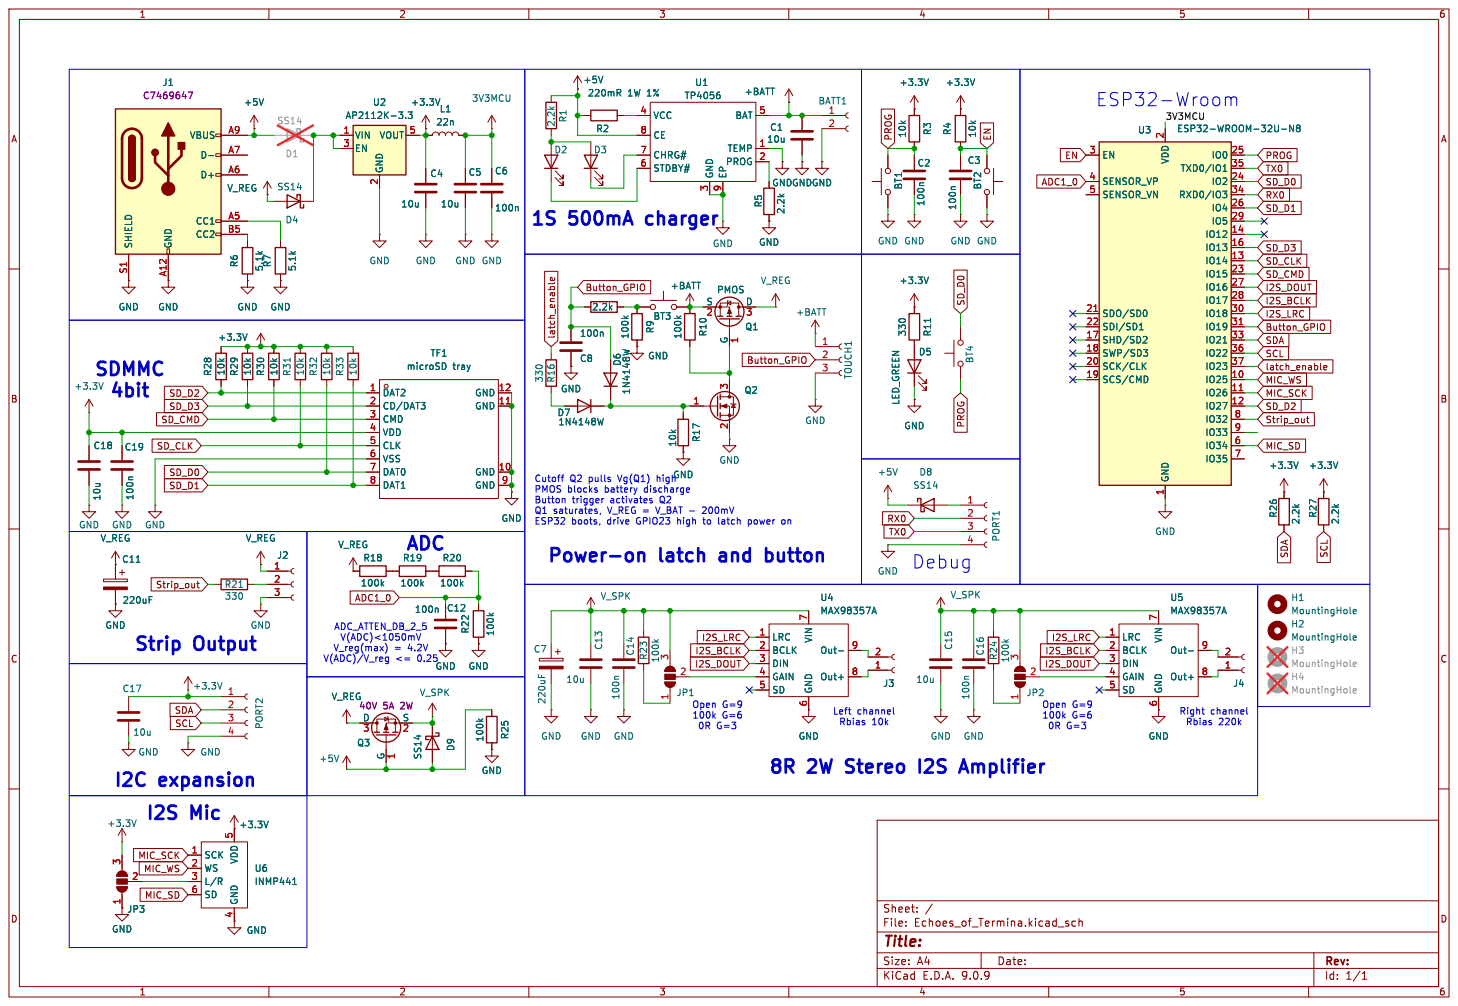
[picture p47: page 1]

9 BAT 5 TEMP 1 PROG 2 U1 TP4056 330 R16 D4 SS14 GND GND

9 BAT 5 TEMP 1 PROG 2GND GND
3V3MCU Open G=9

6 Out- 9 Out+ 8 U5 MAX98357A H3 MountingHole H4 MountingHole H2 MountingHole H1 MountingHole BT2 GND GND

6 Out- 9 Out+ 8 GND 100k R9 100k R10 GND R17 10k GND D6 1N4148W

ESP32 boots, drive GPIO23 high to latch power on

V_REG
Id: 1/1 Title: File: Echoes_of_Termina.kicad_sch Sheet: / C11

Right channel Rbias 220k ADC_ATTEN_DB_2_5 V(ADC)<1050mV

Left channel Rbias 10k 8R 2W Stereo I2S Amplifier
