machadoleonardo94/Echoes-of-Termina/Hardware/Marajoara_V3/Marajoara_V3.pdf

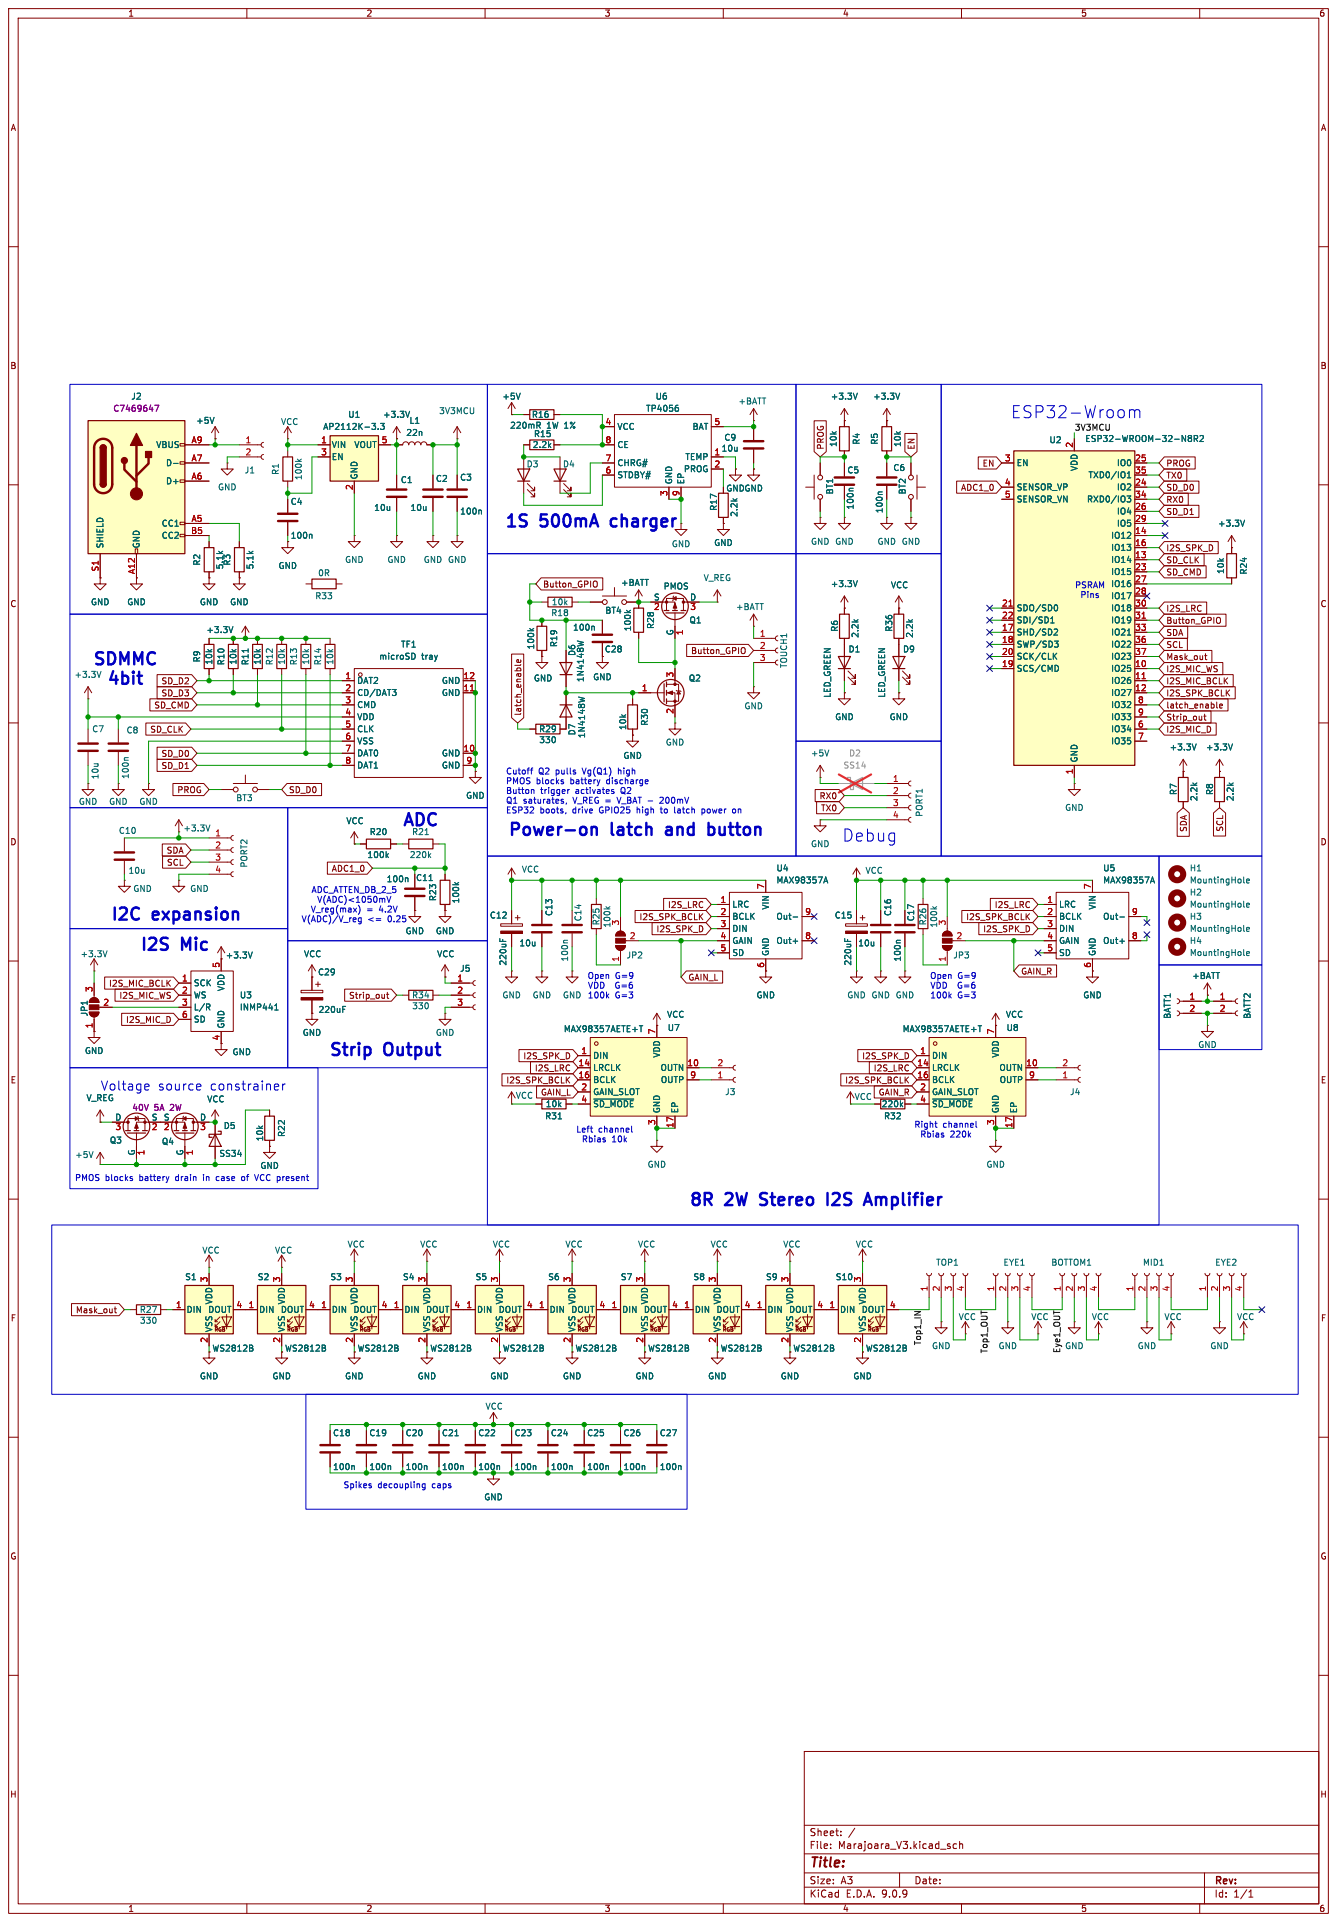
[picture p48: page 1]

9 BAT 5 TEMP 1 PROG 2 U6 TP4056 GND

9 BAT 5 TEMP 1 PROG 2 GND

ESP32 boots, drive GPIO25 high to latch power on

6 Out- 9 Out+ 8 U5 MAX98357A H1 MountingHole H3 MountingHole H4 MountingHole H2 MountingHole GND GND GND GND GND

3 EP 17 OUTN 10 OUTP 9 C17 100n GND C16

6 Out- 9 Out+ 8 GND GND

Right channel Rbias 220k Open G=9 VDD G=6

3 EP 17 OUTN 10 OUTP 9 VCC

3 EP 17 OUTN 10 OUTP 9 MAX98357AETE+T U8 VCC

Id: 1/1 Title: File: Marajoara_V3.kicad_sch Sheet: /
