machadoleonardo94/Echoes-of-Termina/Hardware/PCBs/Echoes_V2/Echoes_V2.pdf

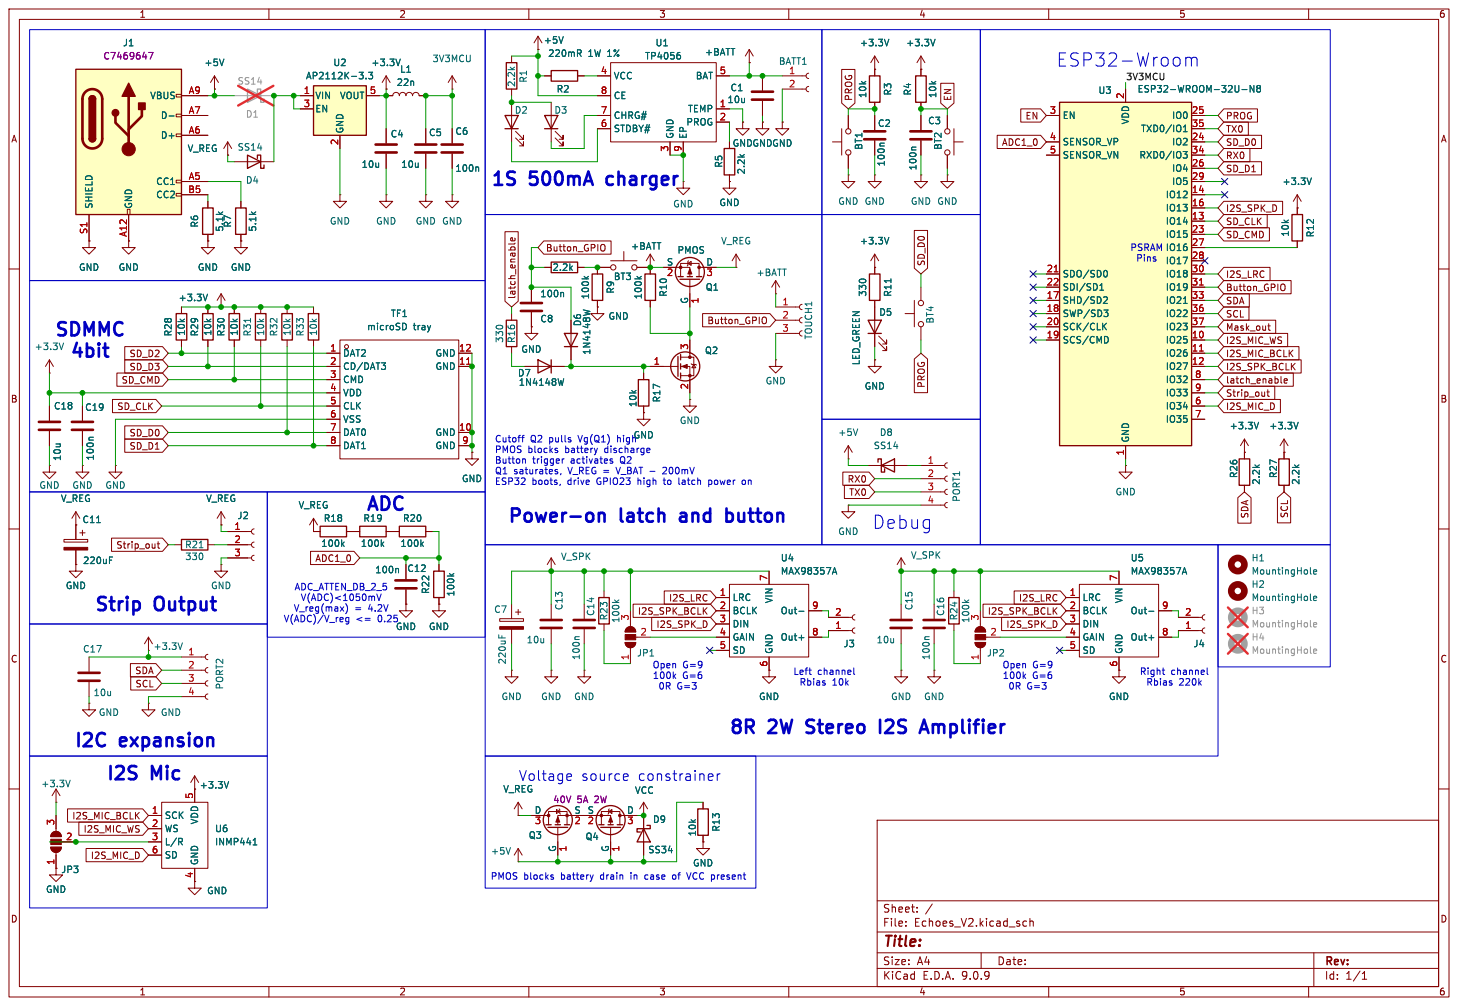
[picture p49: page 1]

9 BAT 5 TEMP 1 PROG 2 100k R10 +BATT R9 100k 2.2k +3.3V C1

ESP32 boots, drive GPIO23 high to latch power on SDMMC
+3.3V GND GND GND

6 Out- 9 Out+ 8 U5 MAX98357A GND GND

Id: 1/1 Title: File: Echoes_V2.kicad_sch Sheet: /
