machadoleonardo94/Echoes-of-Termina/Hardware/PCBs/Marajoara_PCB/Marajoara_PCB.pdf

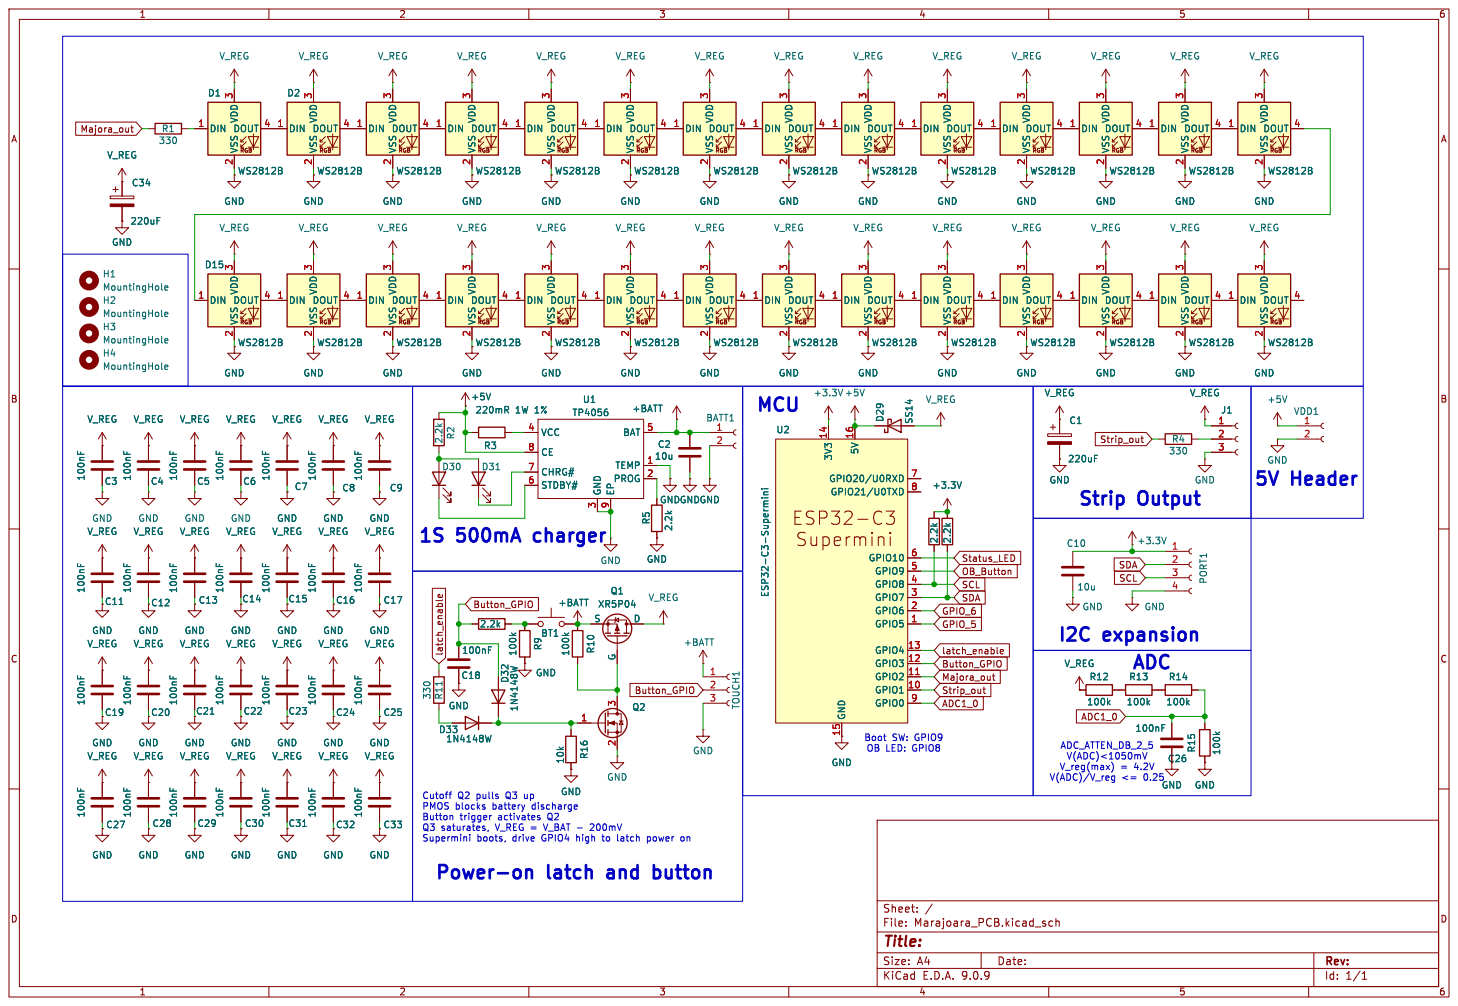
[picture p50: page 1]

2 DOUT 4 GND WS2812B DIN 1 VDD

2 DOUT 4 GND GND GND WS2812B DIN 1 VDD

2 DOUT 4 GND GND GND GND GND GND GND

2 DOUT 4 GND GND GND GND

2 DOUT 4 GND GNDWS2812B DIN 1 VDD

2 DOUT 4 GND GND WS2812B DIN 1 VDD

9 BAT 5 TEMP 1 PROG 2 U1 TP4056 GND

9 BAT 5 TEMP 1 PROG 2 GND R9 100k R16 10k GND GND Q2

Id: 1/1 Title: File: Marajoara_PCB.kicad_sch Sheet: /
