machadoleonardo94/Echoes-of-Termina/Hardware/PCBs/Marajoara_V3/Marajoara_V3.kicad_pcb

## KiCad design Hardware/PCBs/Marajoara_V3/Marajoara_V3.kicad_pcb (2026-10-22)

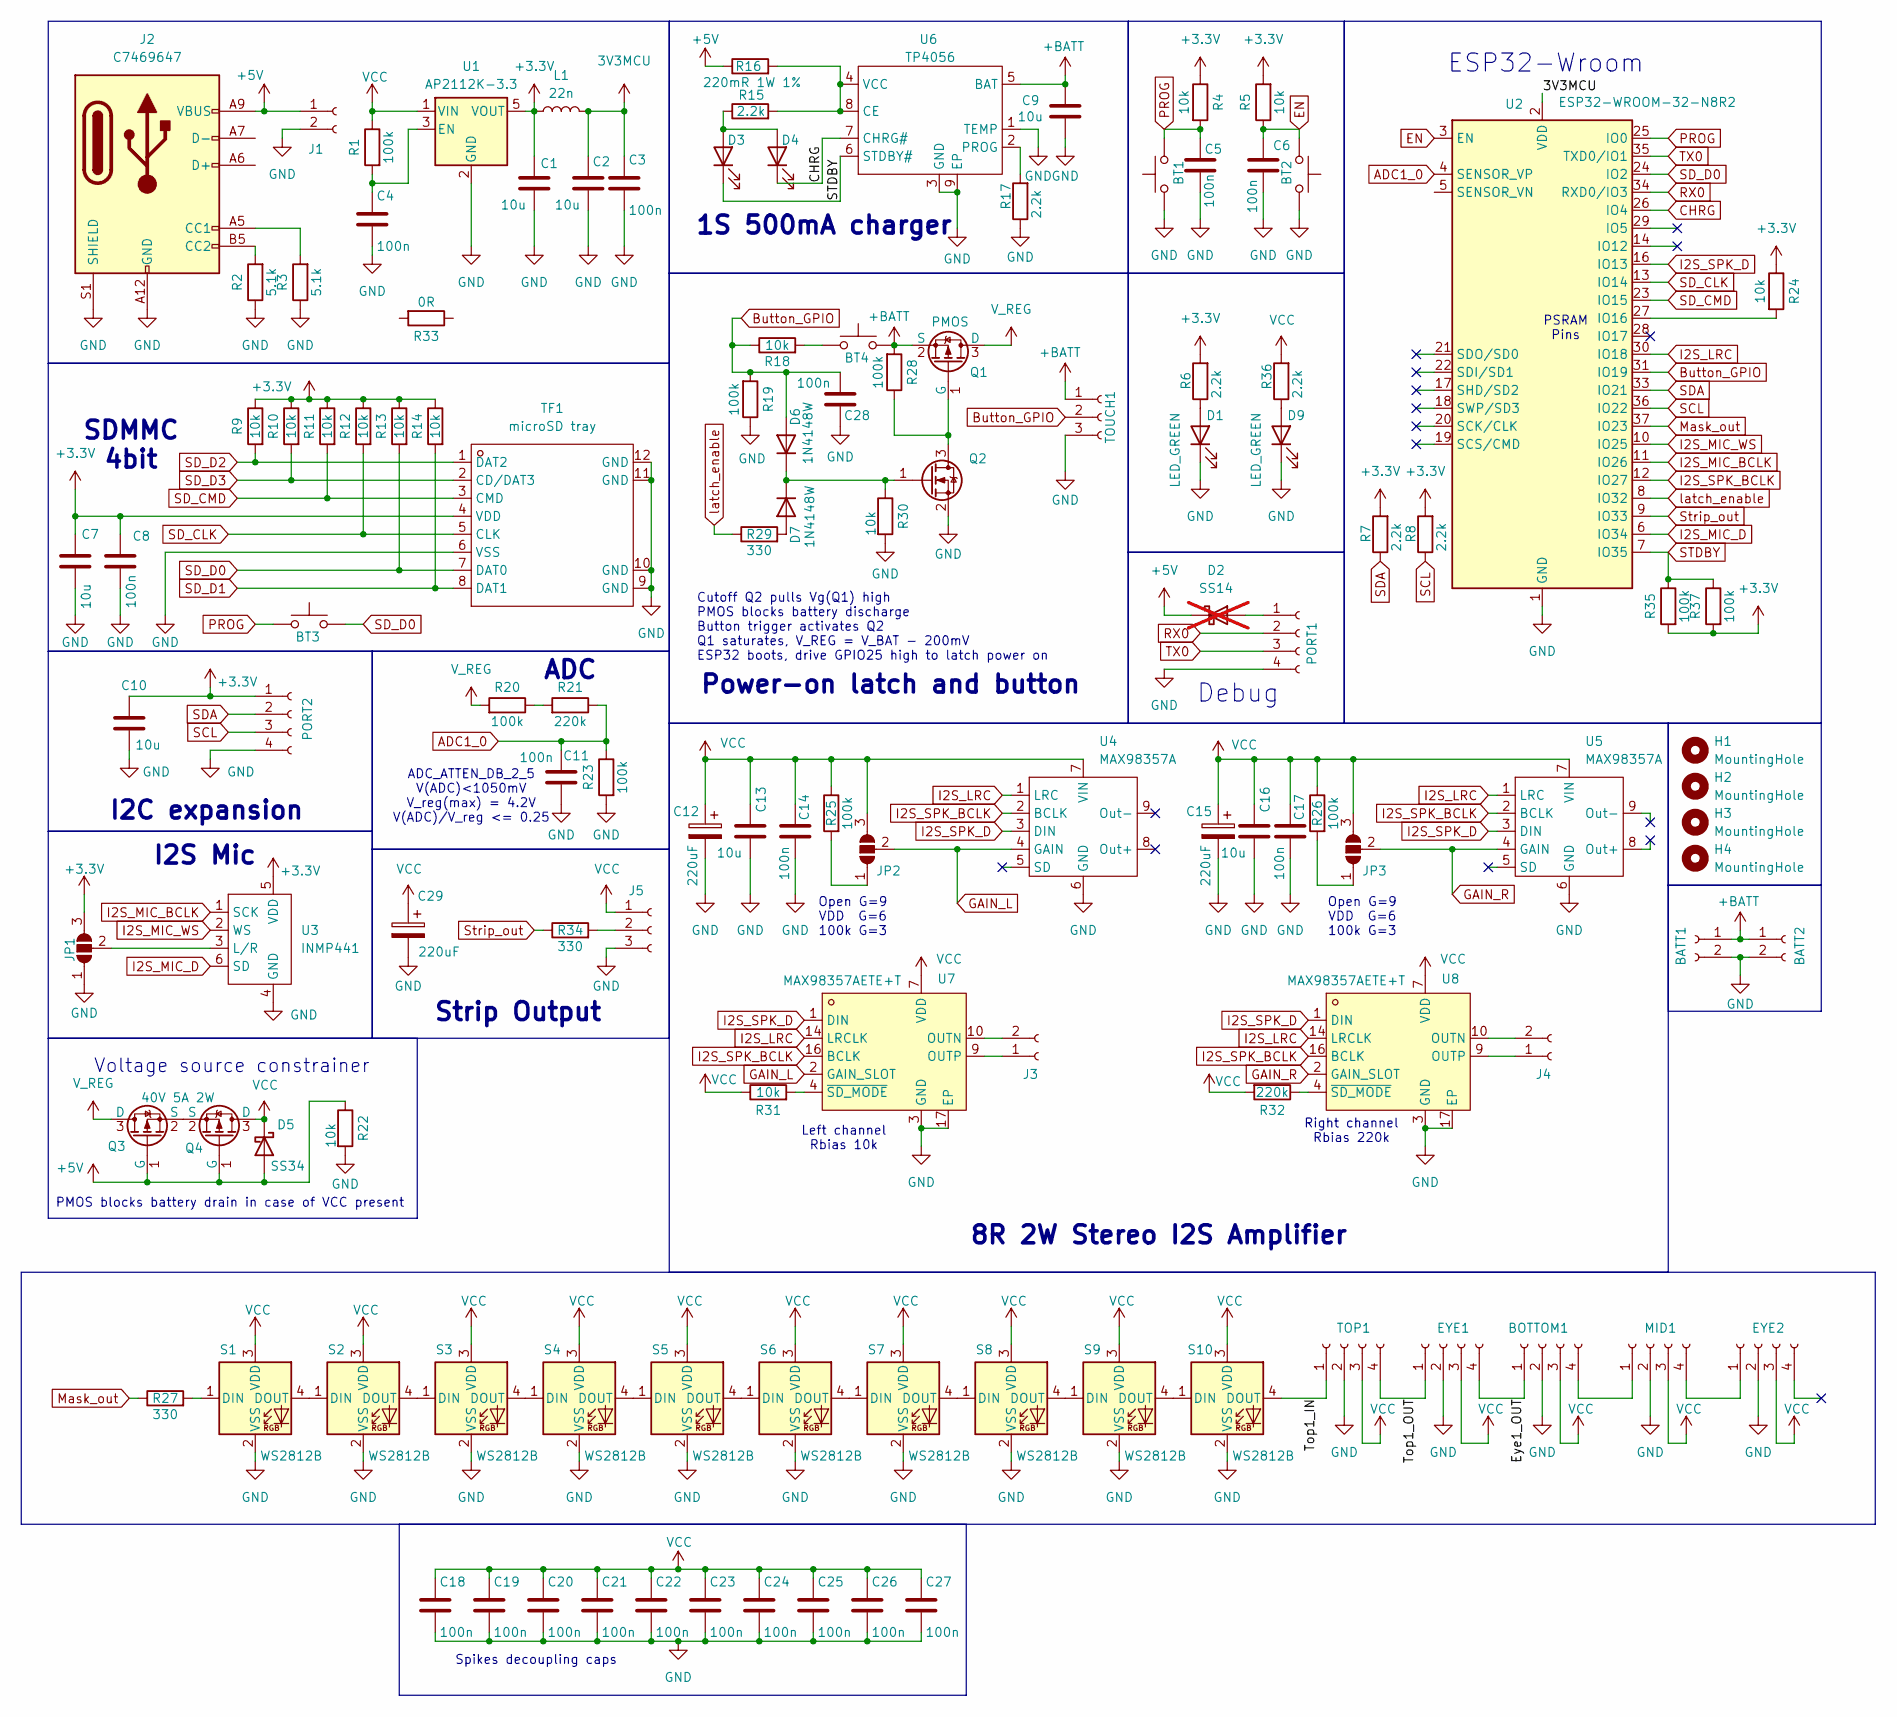
[picture p51: schematic Marajoara_V3.kicad_sch]

Parts:
BATT1, BATT2: Conn_01x02_Socket; Molex_KK-254_AE-6410-02A_1x02_P2.54mm_Vertical; LCSC C49023803
BOTTOM1: Conn_01x04_Socket; Hirose_DF13C_CL535-0404-8-51_1x04-1MP_P1.25mm_Vertical; LCSC C7433470
BT1, BT2, BT3, BT4: SW_Push; SW_SPST_PTS647_Sx38; LCSC C2888502
C1, C2, C7, C9, C10, C13, C16: 10u; C_0805_2012Metric_Pad1.18x1.45mm_HandSolder; LCSC C162422
C3, C4, C5, C6, C8, C11, C14, C17, C18, C19, C20, C21, C22, C23, C24, C25, C26, C27, C28: 100n; C_0805_2012Metric_Pad1.18x1.45mm_HandSolder; LCSC C49678
C12, C15: 220uF; Cap_polymer; LCSC C2162971
C29: 220uF; Cap_polymer; Mfr. Part Number 35TKV220M8X10.5; LCSC C2162971
D1, D9: LED_GREEN; LED_0805_2012Metric_Pad1.15x1.40mm_HandSolder; LCSC C84256
D2: SS14; D_SMA; LCSC C2480; not fitted
D3: LED_BLUE; LED_0805_2012Metric_Pad1.15x1.40mm_HandSolder; LCSC C965817
D4: LED_RED; LED_0805_2012Metric_Pad1.15x1.40mm_HandSolder; LCSC C84256
D5: SS34; D_SMC_Handsoldering; Mfr. Part Number SS34; LCSC C8678
D6, D7: 1N4148W; D_SOD-123; LCSC C83528
EYE1, EYE2: Conn_01x04_Socket; Hirose_DF13C_CL535-0404-8-51_1x04-1MP_P1.25mm_Vertical; LCSC C7433470
H1, H2, H3, H4: MountingHole; MountingHole_3.2mm_M3
J1: Conn_01x02_Socket; Molex_KK-254_AE-6410-02A_1x02_P2.54mm_Vertical; LCSC C49023803
J2: USB_C_Receptacle_USB2.0_8P; USB-C-SMD_GT-USB-7101A; LCSC C7469647
J3, J4: Conn_01x02_Socket; Molex_PicoBlade_53261-0271_1x02-1MP_P1.25mm_Horizontal; LCSC C7433468
J5: Conn_01x03_Socket; TerminalBlock_Xinya_XY308-2.54-3P_1x03_P2.54mm_Horizontal
JP1, JP2, JP3: SolderJumper_3_Open; SolderJumper-3_P1.3mm_Open_RoundedPad1.0x1.5mm
L1: 22n; L_0805_2012Metric_Pad1.05x1.20mm_HandSolder; LCSC C108962
MID1: Conn_01x04_Socket; Hirose_DF13C_CL535-0404-8-51_1x04-1MP_P1.25mm_Vertical; LCSC C7433470
PORT1, PORT2: Conn_01x04_Socket; Hirose_DF13C_CL535-0404-8-51_1x04-1MP_P1.25mm_Vertical; LCSC C7433470
Q1, Q3, Q4: PMOS; SOT-23_Handsoldering; LCSC C42456992
Q2: 2N7002K; SOT-23; LCSC C65189
R1, R19, R20, R23, R25, R26, R28, R35, R37: 100k; R_0805_2012Metric_Pad1.20x1.40mm_HandSolder; LCSC C149504
R2, R3: 5.1k; R_0805_2012Metric_Pad1.20x1.40mm_HandSolder; LCSC C27834
R4, R5, R9, R10, R11, R12, R13, R14, R18, R22, R24, R30, R31: 10k; R_0805_2012Metric_Pad1.20x1.40mm_HandSolder; LCSC C17414
R6, R7, R8, R15, R17, R36: 2.2k; R_0805_2012Metric_Pad1.20x1.40mm_HandSolder; LCSC C17520
R16: 220mR 1W 1%; R_1206_3216Metric_Pad1.30x1.75mm_HandSolder; LCSC C2683384
R21, R32: 220k; R_0805_2012Metric_Pad1.20x1.40mm_HandSolder; LCSC C149504
R27, R29, R34: 330; R_0805_2012Metric_Pad1.20x1.40mm_HandSolder; LCSC C17630
R33: 0R; R_0805_2012Metric_Pad1.20x1.40mm_HandSolder; LCSC 1
S1, S2, S3, S4, S5, S6, S7, S8, S9, S10: WS2812B; WS2812B_PTH_staggered
TF1: microSD tray; TF-SMD_TF-CARD-XG8P-H1.5; LCSC Part Name 翻盖式 MicroSD卡(TF卡) 卡座
TOP1: Conn_01x04_Socket; Hirose_DF13C_CL535-0404-8-51_1x04-1MP_P1.25mm_Vertical; LCSC C7433470
TOUCH1: Conn_01x03_Socket; PinHeader_1x03_P2.54mm_Vertical
U1: AP2112K-3.3; SOT-23-5; LCSC C51118
U2: ESP32-WROOM-32-N8R2; ESP32-WROOM-32UE; LCSC C5361945
U3: INMP441; INMP441 Module
U4, U5: MAX98357A; LCSC C910544
U6: TP4056; ESOP-8_L4.9-W3.9-P1.27-LS6.0-BL-EP; LCSC Part Name 1A锂电池充电IC
U7, U8: MAX98357AETE+T; TQFN-16_L3.0-W3.0-P0.50-BL-EP1.5; MPN MAX98357AETE+T; LCSC Part C910544

Connections:
3V3MCU: C2.1, C3.1, L1.2, U2.2 (VDD)
+3.3V: C1.1, C7.1, C8.2, C10.1, JP1.3 (B), L1.1, PORT2.1, R4.1, R5.2, R6.2, R7.2, R8.2, R9.1, R10.1, R11.1, R12.1, R13.1, R14.1, R24.1, R35.2, R37.2, TF1.4 (VDD), U1.5 (VOUT), U3.5 (VDD)
+5V: D2.1 (K), D5.2 (A), J1.1, J2.A9 (VBUS), J2.B9 (VBUS), Q3.1 (G), Q4.1 (G), R16.1, R22.1
+BATT: BATT1.1, BATT2.1, BT4.1, C9.1, Q1.2 (S), R28.2, TOUCH1.1, U6.5 (BAT)
/Eye1_OUT: BOTTOM1.1, EYE1.4
/Top1_IN: S10.4 (DOUT), TOP1.1
/Top1_OUT: EYE1.1, TOP1.4
ADC1_0: C11.2, R21.1, R23.1, U2.4 (SENSOR_VP)
Button_GPIO: C28.2, D6.2 (A), R18.1, R19.2, TOUCH1.2, U2.31 (IO19)
EN: BT2.2, C6.1, R5.1, U2.3 (EN)
GAIN_L: JP2.2 (C), U4.4 (GAIN), U7.2 (GAIN_SLOT)
GAIN_R: JP3.2 (C), U5.4 (GAIN), U8.2 (GAIN_SLOT)
GND: BATT1.2, BATT2.2, BOTTOM1.2, BT1.1, BT2.1, C1.2, C2.2, C3.2, C4.2, C5.2, C6.2, C7.2, C8.1, C9.2, C10.2, C11.1, C12.2, C13.2, C14.1, C15.2, C16.2, C17.1, C18.2, C19.2, C20.2, C21.2, C22.2, C23.2, C24.2, C25.2, C26.2, C27.2, C28.1, C29.2, D1.1 (K), D9.1 (K), EYE1.2, EYE2.2, J1.2, J2.A12 (GND), J2.B12 (GND), J2.S1 (SHIELD), J5.3, JP1.1 (A), MID1.2, PORT1.4, PORT2.4, Q2.2 (S), R2.1, R3.1, R17.1, R19.1, R22.2, R23.2, R30.2, S1.2 (VSS), S2.2 (VSS), S3.2 (VSS), S4.2 (VSS), S5.2 (VSS), S6.2 (VSS), S7.2 (VSS), S8.2 (VSS), S9.2 (VSS), S10.2 (VSS), TF1.6 (VSS), TF1.9 (GND), TF1.10 (GND), TF1.11 (GND), TF1.12 (GND), TOP1.2, TOUCH1.3, U1.2 (GND), U2.1 (GND), U2.15 (GND), U2.38 (GND), U2.39 (GND), U3.4 (GND), U4.6 (GND), U5.6 (GND), U6.1 (TEMP), U6.3 (GND), U6.9 (EP), U7.3 (GND), U7.11 (GND), U7.15 (GND), U7.17 (EP), U8.3 (GND), U8.11 (GND), U8.15 (GND), U8.17 (EP)
I2S_LRC: U2.30 (IO18), U4.1 (LRC), U5.1 (LRC), U7.14 (LRCLK), U8.14 (LRCLK)
I2S_MIC_BCLK: U2.11 (IO26), U3.1 (SCK)
I2S_MIC_D: U2.6 (IO34), U3.6 (SD)
I2S_MIC_WS: U2.10 (IO25), U3.2 (WS)
I2S_SPK_BCLK: U2.12 (IO27), U4.2 (BCLK), U5.2 (BCLK), U7.16 (BCLK), U8.16 (BCLK)
I2S_SPK_D: U2.16 (IO13), U4.3 (DIN), U5.3 (DIN), U7.1 (DIN), U8.1 (DIN)
Mask_out: R27.1, U2.37 (IO23)
unnamed: BOTTOM1.4, MID1.1
unnamed: BT4.2, R18.2
unnamed: D1.2 (A), R6.1
unnamed: D3.2 (A), D4.2 (A), R15.1
unnamed: D3.1 (K), U6.6 (STDBY#)
unnamed: D4.1 (K), U6.7 (CHRG#)
unnamed: D6.1 (K), D7.1 (K), Q2.1 (G), R30.1
unnamed: D7.2 (A), R29.2
unnamed: D9.2 (A), R36.1
unnamed: EYE2.1, MID1.4
unnamed: J2.A5 (CC1), R3.2
unnamed: J2.B5 (CC2), R2.2
unnamed: J3.1, U7.9 (OUTP)
unnamed: J3.2, U7.10 (OUTN)
unnamed: J4.1, U8.9 (OUTP)
unnamed: J4.2, U8.10 (OUTN)
unnamed: J5.2, R34.2
unnamed: JP1.2 (C), U3.3 (L/R)
unnamed: JP2.1 (A), R25.2
unnamed: JP3.1 (A), R26.2
unnamed: D2.2 (A), PORT1.1
unnamed: Q1.1 (G), Q2.3 (D), R28.1
unnamed: Q3.2 (S), Q4.2 (S)
unnamed: R20.1, R21.2
unnamed: R35.1, R37.1, U2.7 (IO35)
unnamed: R27.2, S1.1 (DIN)
unnamed: S1.4 (DOUT), S2.1 (DIN)
unnamed: S2.4 (DOUT), S3.1 (DIN)
unnamed: S3.4 (DOUT), S4.1 (DIN)
unnamed: S4.4 (DOUT), S5.1 (DIN)
unnamed: S5.4 (DOUT), S6.1 (DIN)
unnamed: S6.4 (DOUT), S7.1 (DIN)
unnamed: S7.4 (DOUT), S8.1 (DIN)
unnamed: S8.4 (DOUT), S9.1 (DIN)
unnamed: S9.4 (DOUT), S10.1 (DIN)
unnamed: C4.1, R1.2, U1.3 (EN)
unnamed: R24.2, U2.27 (IO16)
unnamed: R15.2, R16.2, U6.4 (VCC), U6.8 (CE)
unnamed: R17.2, U6.2 (PROG)
unnamed: R31.2, U7.4 (~SD_MODE)
unnamed: R32.1, U8.4 (~SD_MODE)
PROG: BT1.2, BT3.2, C5.1, R4.2, U2.25 (IO0)
RX0: PORT1.2, U2.34 (RXD0/IO3)
SCL: PORT2.3, R8.1, U2.36 (IO22)
SDA: PORT2.2, R7.1, U2.33 (IO21)
SD_CLK: R12.2, TF1.5 (CLK), U2.13 (IO14)
SD_CMD: R11.2, TF1.3 (CMD), U2.23 (IO15)
SD_D0: BT3.1, R13.2, TF1.7 (DAT0), U2.24 (IO2)
SD_D2: R9.2, TF1.1 (DAT2)
SD_D3: R10.2, TF1.2 (CD/DAT3)
Strip_out: R34.1, U2.9 (IO33)
TX0: PORT1.3, U2.35 (TXD0/IO1)
latch_enable: R29.1, U2.8 (IO32)

Notes on the sheet:
PMOS blocks battery drain in case of VCC present
Right channel Rbias 220k
I2S Mic
Open G=9 VDD G=6 100k G=3
Power-on latch and button
8R 2W Stereo I2S Amplifier
ADC_ATTEN_DB_2_5 V(ADC)<1050mV V_reg(max) = 4.2V V(ADC)/V_reg <= 0.25
ADC
Spikes decoupling caps
SDMMC 4bit
Left channel Rbias 10k
I2C expansion
Cutoff Q2 pulls Vg(Q1) high PMOS blocks battery discharge Button trigger activates Q2 Q1 saturates, V_REG = V_BAT - 200mV ESP32 boots, drive GPIO25 high to latch power on
Strip Output
PSRAM Pins
Debug
Voltage source constrainer
ESP32-Wroom
1S 500mA charger

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
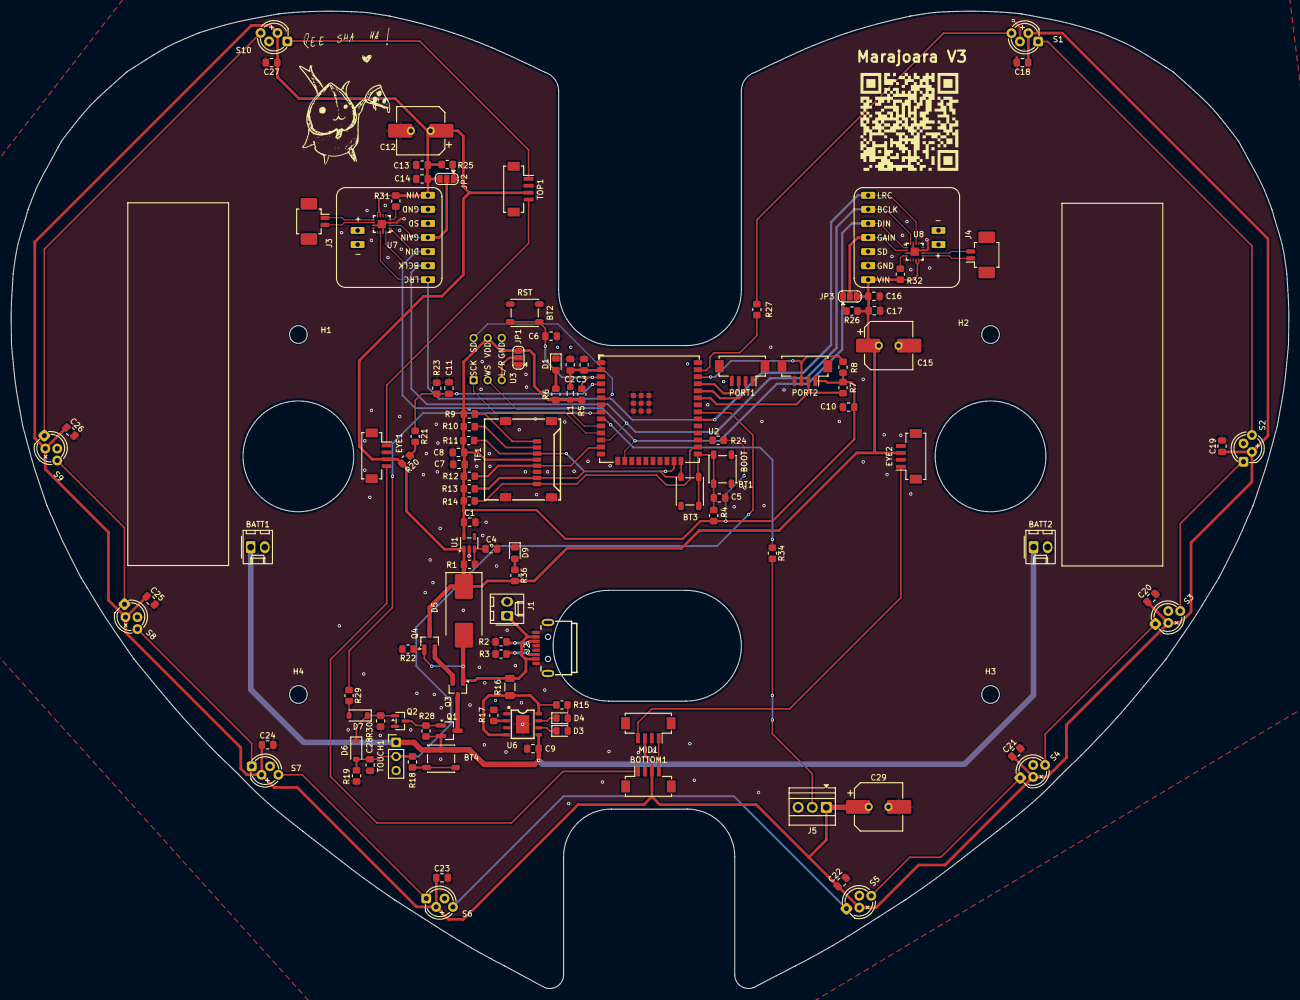
[picture p52: board Marajoara_V3.kicad_pcb from above]

Board: 2 copper layers, 230.7 x 176.5 mm, 121 parts (1 on the bottom side), 74 nets.
