machadoleonardo94/Echoes-of-Termina/Hardware/PCBs/Echoes_V2/Echoes_V2.kicad_pcb

## KiCad design Hardware/PCBs/Echoes_V2/Echoes_V2.kicad_pcb (2026-10-22)

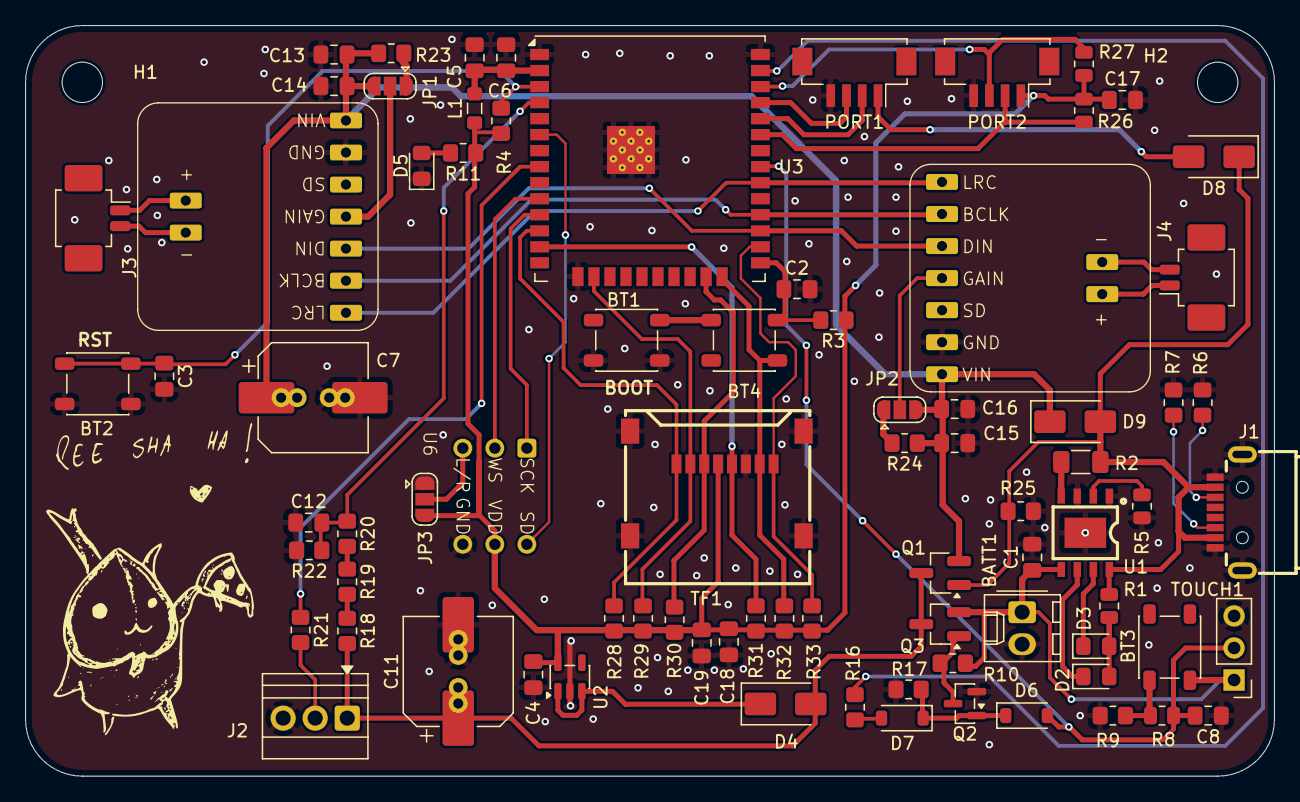
[picture p53: board Echoes_V2.kicad_pcb from above]

Board: 2 copper layers, 99.0 x 59.5 mm, 82 parts (0 on the bottom side), 55 nets.

Parts:
BATT1: Conn_01x02_Socket; Molex_KK-254_AE-6410-02A_1x02_P2.54mm_Vertical
BT1, BT2, BT3, BT4: SW_Push; SW_SPST_PTS647_Sx38
C1, C4, C5, C13, C15, C17, C18: 10u; C_0805_2012Metric_Pad1.18x1.45mm_HandSolder
C2, C3, C6, C8, C12, C14, C16, C19: 100n; C_0805_2012Metric_Pad1.18x1.45mm_HandSolder
C7, C11: 220uF; Cap_polymer
D2: LED_BLUE; LED_0805_2012Metric_Pad1.15x1.40mm_HandSolder
D3: LED_RED; LED_0805_2012Metric_Pad1.15x1.40mm_HandSolder
D4, D8, D9: SS14; D_SMA
D5: LED_GREEN; LED_0805_2012Metric_Pad1.15x1.40mm_HandSolder
D6, D7: 1N4148W; D_SOD-123
H1, H2: MountingHole; MountingHole_3.2mm_M3
J1: USB_C_Receptacle_USB2.0_8P; USB-C-SMD_GT-USB-7101A
J2: Conn_01x03_Socket; TerminalBlock_Xinya_XY308-2.54-3P_1x03_P2.54mm_Horizontal
J3, J4: Conn_01x02_Socket; Molex_PicoBlade_53261-0271_1x02-1MP_P1.25mm_Horizontal
JP1, JP2, JP3: SolderJumper_3_Open; SolderJumper-3_P1.3mm_Open_RoundedPad1.0x1.5mm
L1: 22n; L_0805_2012Metric_Pad1.05x1.20mm_HandSolder
PORT1, PORT2: Conn_01x04_Socket; Hirose_DF13C_CL535-0404-8-51_1x04-1MP_P1.25mm_Vertical
Q1, Q3: PMOS; SOT-23_Handsoldering
Q2: 2N7002K; SOT-23
R1, R5, R8, R26, R27: 2.2k; R_0805_2012Metric
R2: 220mR 1W 1%; R_1206_3216Metric_Pad1.30x1.75mm_HandSolder
R3, R4, R17, R28, R29, R30, R31, R32, R33: 10k; R_0805_2012Metric_Pad1.20x1.40mm_HandSolder
R6, R7: 5.1k; R_0805_2012Metric_Pad1.20x1.40mm_HandSolder
R9, R10, R18, R19, R20, R22, R23, R24, R25: 100k; R_0805_2012Metric_Pad1.20x1.40mm_HandSolder
R11, R16, R21: 330; R_0805_2012Metric_Pad1.20x1.40mm_HandSolder
TF1: microSD tray; TF-SMD_TF-CARD-XG8P-H1.5
TOUCH1: Conn_01x03_Socket; PinHeader_1x03_P2.54mm_Vertical
U1: TP4056; ESOP-8_L4.9-W3.9-P1.27-LS6.0-BL-EP
U2: AP2112K-3.3; SOT-23-5
U3: ESP32-WROOM-32U-N8; ESP32-WROOM-32U
U4, U5: MAX98357A
U6: INMP441; INMP441 Module

Connections:
3V3MCU: C5.1, C6.1, L1.2, U3.2 (VDD)
+3.3V: C4.1, C17.1, C18.1, C19.2, JP3.3 (B), L1.1, PORT2.1, R3.1, R4.2, R11.1, R26.2, R27.2, R28.1, R29.1, R30.1, R31.1, R32.1, R33.1, TF1.4 (VDD), U2.5 (VOUT), U6.5 (VDD)
+5V: D8.1 (K), D9.2 (A), J1.A9 (VBUS), J1.B9 (VBUS), Q3.1 (G), R1.1, R2.1, R25.2, U1.8 (CE)
+BATT: BATT1.1, BT3.1, C1.1, Q1.2 (S), R10.2, TOUCH1.1, U1.5 (BAT)
ADC1_0: C12.2, R20.1, R22.1, U3.4 (SENSOR_VP)
Button_GPIO: C8.2, D6.2 (A), R8.2, TOUCH1.2, U3.31 (IO19)
EN: BT2.2, C3.1, R4.1, U3.3 (EN)
GND: BATT1.2, BT1.1, BT2.1, C1.2, C2.2, C3.2, C4.2, C5.2, C6.2, C7.2, C8.1, C11.2, C12.1, C13.2, C14.1, C15.2, C16.1, C17.2, C18.2, C19.1, D5.1 (K), J1.A12 (GND), J1.B12 (GND), J1.S1 (SHIELD), J2.3, JP3.1 (A), PORT1.4, PORT2.4, Q2.2 (S), R5.1, R6.1, R7.1, R9.1, R17.2, R22.2, R25.1, TF1.6 (VSS), TF1.9 (GND), TF1.10 (GND), TF1.11 (GND), TF1.12 (GND), TOUCH1.3, U1.1 (TEMP), U1.3 (GND), U1.9 (EP), U2.2 (GND), U3.1 (GND), U3.15 (GND), U3.38 (GND), U3.39 (GND), U4.6 (GND), U5.6 (GND), U6.4 (GND)
I2S_BCLK: U3.28 (IO17), U4.2 (BCLK), U5.2 (BCLK)
I2S_DOUT: U3.27 (IO16), U4.3 (DIN), U5.3 (DIN)
I2S_LRC: U3.30 (IO18), U4.1 (LRC), U5.1 (LRC)
MIC_SCK: U3.11 (IO26), U6.1 (SCK)
MIC_SD: U3.6 (IO34), U6.6 (SD)
MIC_WS: U3.10 (IO25), U6.2 (WS)
unnamed: BT3.2, R8.1, R9.2
unnamed: D2.2 (A), D3.2 (A), R1.2
unnamed: D2.1 (K), U1.6 (STDBY#)
unnamed: D3.1 (K), U1.7 (CHRG#)
unnamed: D4.1 (K), U2.1 (VIN), U2.3 (EN)
unnamed: D5.2 (A), R11.2
unnamed: D6.1 (K), D7.1 (K), Q2.1 (G), R17.1
unnamed: D7.2 (A), R16.2
unnamed: D8.2 (A), PORT1.1
unnamed: J1.A5 (CC1), R7.2
unnamed: J1.B5 (CC2), R6.2
unnamed: J2.2, R21.2
unnamed: J3.1, U4.8 (Out+)
unnamed: J3.2, U4.9 (Out-)
unnamed: J4.1, U5.8 (Out+)
unnamed: J4.2, U5.9 (Out-)
unnamed: JP1.1 (A), R23.2
unnamed: JP1.2 (C), U4.4 (GAIN)
unnamed: JP2.1 (A), R24.2
unnamed: JP2.2 (C), U5.4 (GAIN)
unnamed: JP3.2 (C), U6.3 (L/R)
unnamed: Q1.1 (G), Q2.3 (D), R10.1
unnamed: R18.1, R19.2
unnamed: R19.1, R20.2
unnamed: R5.2, U1.2 (PROG)
unnamed: R2.2, U1.4 (VCC)
PROG: BT1.2, BT4.2, C2.1, R3.2, U3.25 (IO0)
RX0: PORT1.2, U3.34 (RXD0/IO3)
SCL: PORT2.3, R27.1, U3.36 (IO22)
SDA: PORT2.2, R26.1, U3.33 (IO21)
SD_CLK: R31.2, TF1.5 (CLK), U3.13 (IO14)
SD_CMD: R30.2, TF1.3 (CMD), U3.23 (IO15)
SD_D0: BT4.1, R32.2, TF1.7 (DAT0), U3.24 (IO2)
SD_D1: R33.2, TF1.8 (DAT1), U3.26 (IO4)
SD_D2: R28.2, TF1.1 (DAT2), U3.12 (IO27)
SD_D3: R29.2, TF1.2 (CD/DAT3), U3.16 (IO13)
Strip_out: R21.1, U3.8 (IO32)
TX0: PORT1.3, U3.35 (TXD0/IO1)
V_REG: C11.1, D4.2 (A), J2.1, Q1.3 (D), Q3.3 (D), R18.2
V_SPK: C7.1, C13.1, C14.2, C15.1, C16.2, D9.1 (K), JP1.3 (B), JP2.3 (B), Q3.2 (S), R23.1, R24.1, U4.7 (VIN), U5.7 (VIN)
latch_enable: R16.1, U3.37 (IO23)
