machadoleonardo94/Echoes-of-Termina/Hardware/PCBs/LED breakout boards/Top_6_WS2812B/Top_6_WS2812B.kicad_pcb

## KiCad design Hardware/PCBs/LED breakout boards/Top_6_WS2812B/Top_6_WS2812B.kicad_pcb (2026-10-22)

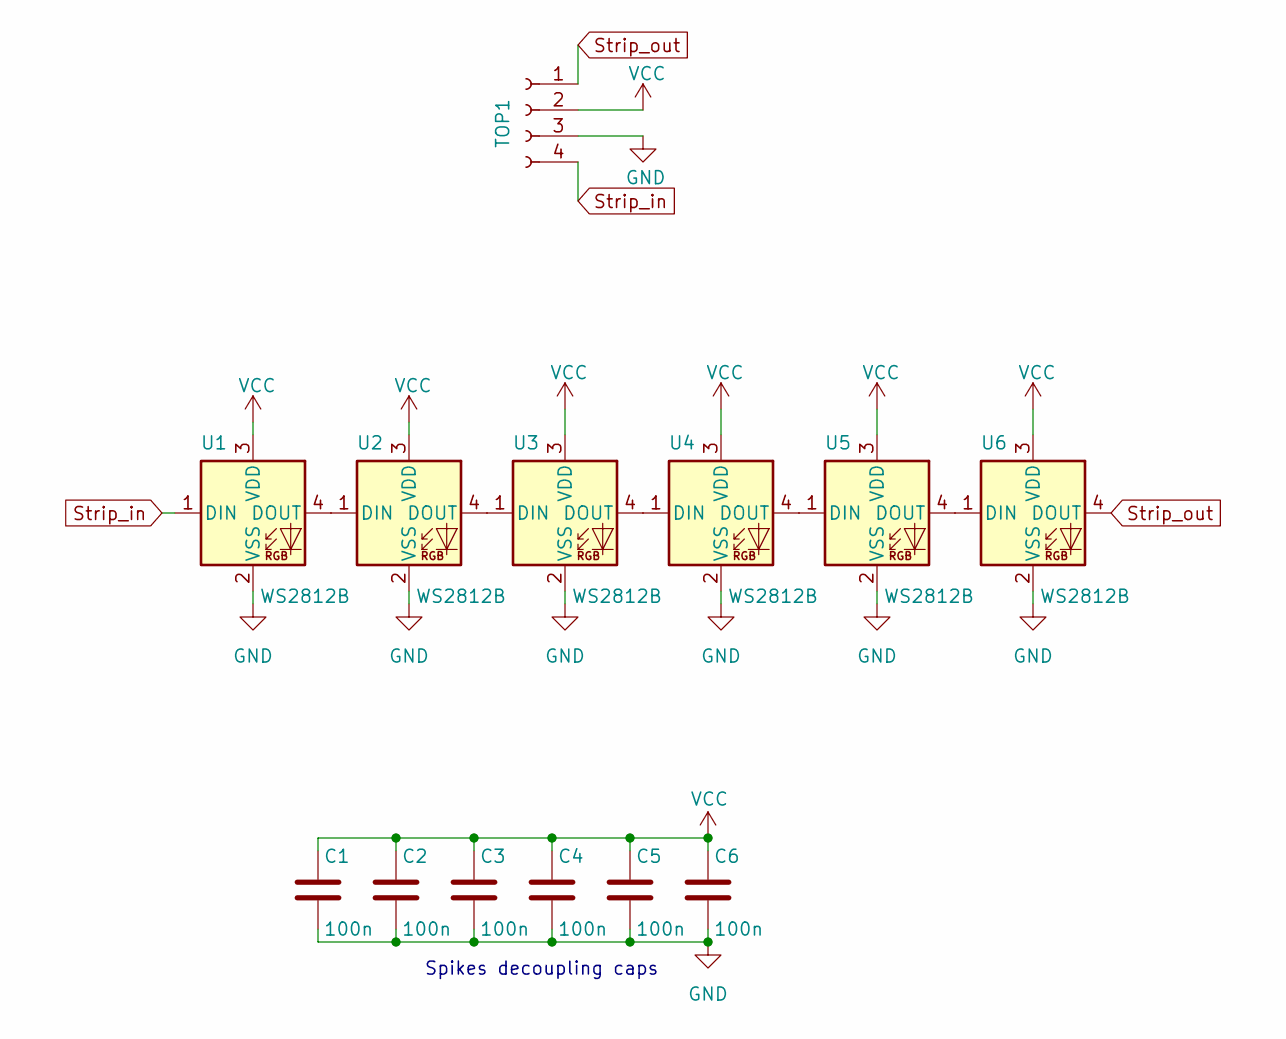
[picture p54: schematic Top_6_WS2812B.kicad_sch]

Parts:
C1, C2, C3, C4, C5, C6: 100n; C_0805_2012Metric_Pad1.18x1.45mm_HandSolder; LCSC C49678
TOP1: Conn_01x04_Socket; Hirose_DF13C_CL535-0404-8-51_1x04-1MP_P1.25mm_Vertical; LCSC C7433470
U1, U2, U3, U4, U5, U6: WS2812B; WS2812B_PTH_staggered

Connections:
GND: C1.2, C2.2, C3.2, C4.2, C5.2, C6.2, TOP1.3, U1.2 (VSS), U2.2 (VSS), U3.2 (VSS), U4.2 (VSS), U5.2 (VSS), U6.2 (VSS)
unnamed: U1.4 (DOUT), U2.1 (DIN)
unnamed: U2.4 (DOUT), U3.1 (DIN)
unnamed: U3.4 (DOUT), U4.1 (DIN)
unnamed: U4.4 (DOUT), U5.1 (DIN)
unnamed: U5.4 (DOUT), U6.1 (DIN)
Strip_in: TOP1.4, U1.1 (DIN)
Strip_out: TOP1.1, U6.4 (DOUT)
VCC: C1.1, C2.1, C3.1, C4.1, C5.1, C6.1, TOP1.2, U1.3 (VDD), U2.3 (VDD), U3.3 (VDD), U4.3 (VDD), U5.3 (VDD), U6.3 (VDD)

Notes on the sheet:
Spikes decoupling caps

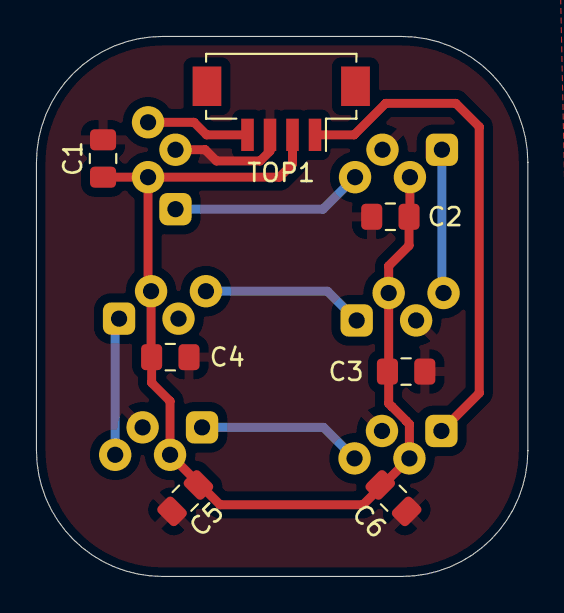
[picture p55: board Top_6_WS2812B.kicad_pcb from above]

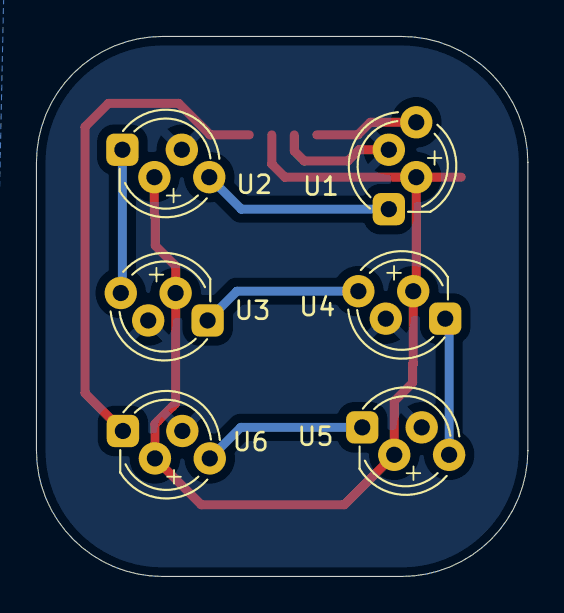
[picture p56: board Top_6_WS2812B.kicad_pcb from below]

Board: 2 copper layers, 27.3 x 30.0 mm, 13 parts (6 on the bottom side), 9 nets.
