machadoleonardo94/Echoes-of-Termina/Hardware/PCBs/Marajoara_PCB/Marajoara_PCB.kicad_pcb

## KiCad design Hardware/PCBs/Marajoara_PCB/Marajoara_PCB.kicad_pcb (2026-10-22)

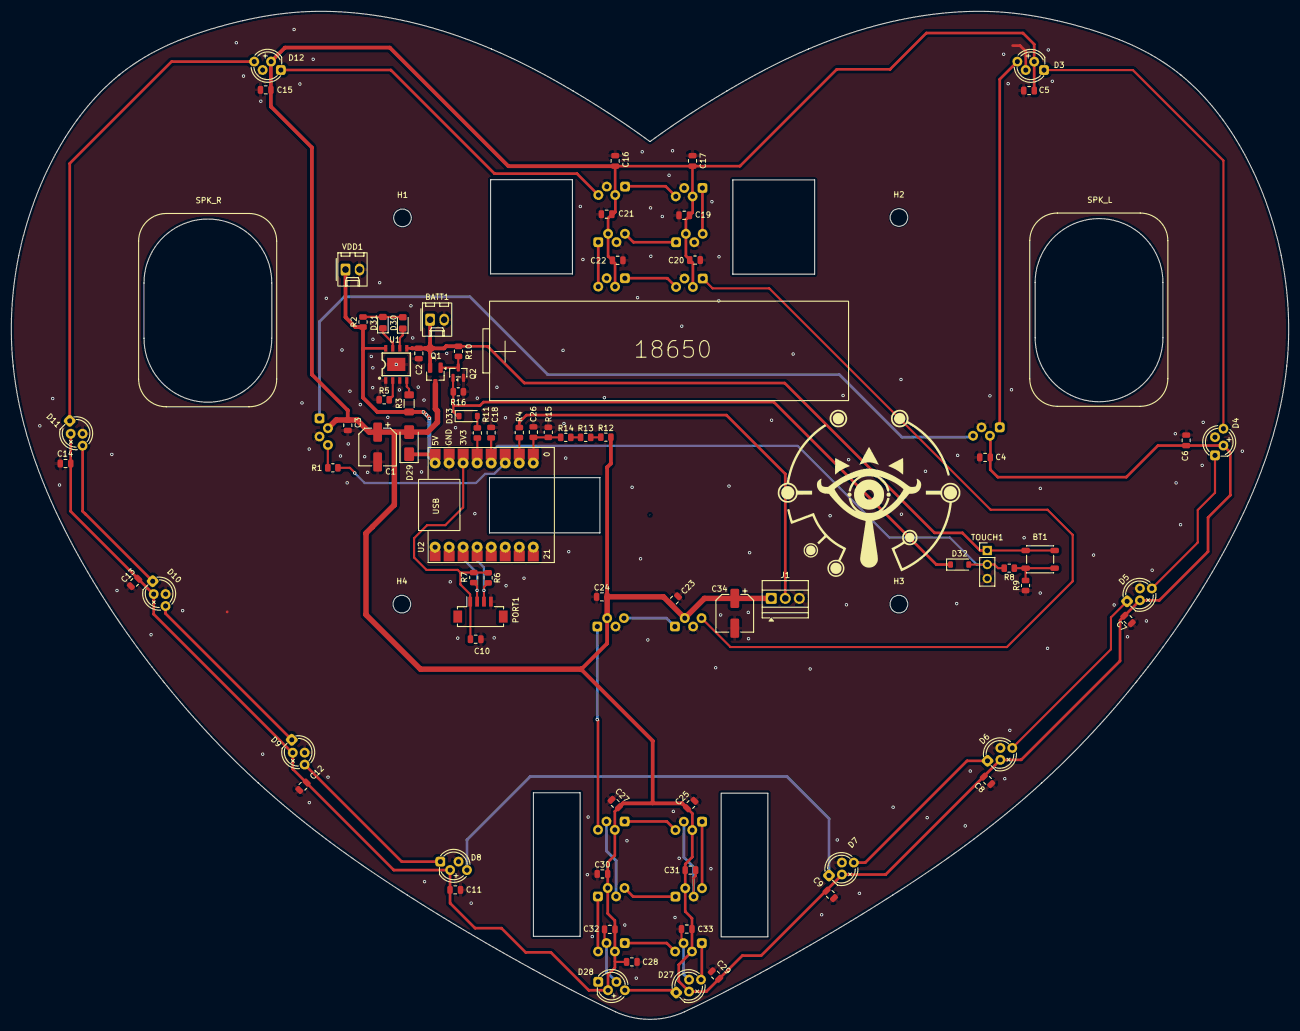
[picture p57: board Marajoara_PCB.kicad_pcb from above]

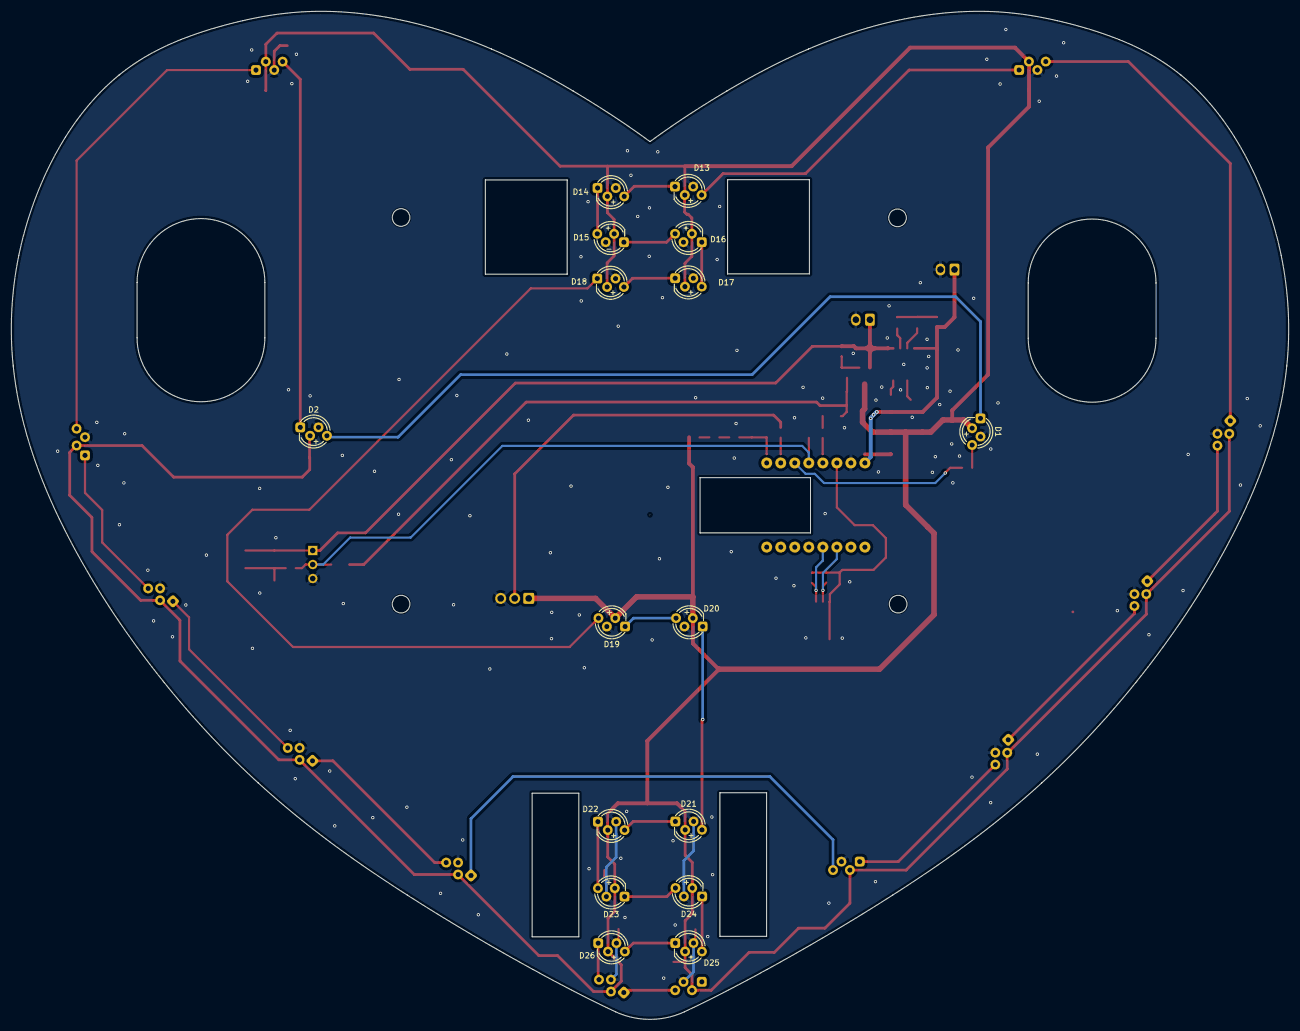
[picture p58: board Marajoara_PCB.kicad_pcb from below]

Board: 2 copper layers, 231.3 x 182.5 mm, 99 parts (16 on the bottom side), 52 nets.

Parts:
BATT1: Conn_01x02_Socket; Molex_KK-254_AE-6410-02A_1x02_P2.54mm_Vertical
BT1: SW_Push; SW_SPST_PTS647_Sx38
C1, C34: 220uF; CP_Elec_6.3x7.7
C2, C10: 10u; C_0805_2012Metric
C3, C4, C5, C6, C7, C8, C9, C11, C12, C13, C14, C15, C16, C17, C18, C19, C20, C21, C22, C23, C24, C25, C26, C27, C28, C29, C30, C31, C32, C33: 100nF; C_0805_2012Metric
D1, D2, D3, D4, D5, D6, D7, D8, D9, D10, D11, D12, D13, D14, D15, D16, D17, D18, D19, D20, D21, D22, D23, D24, D25, D26, D27, D28: WS2812B; WS2812B_PTH_staggered
D29: SS14; D_SMA
D30: LED_BLUE; LED_0805_2012Metric_Pad1.15x1.40mm_HandSolder
D31: LED_RED; LED_0805_2012Metric_Pad1.15x1.40mm_HandSolder
D32, D33: 1N4148W; D_SOD-123
H1, H2, H3, H4: MountingHole; MountingHole_3.2mm_M3
J1: Conn_01x03_Socket; TerminalBlock_Xinya_XY308-2.54-3P_1x03_P2.54mm_Horizontal
PORT1: Conn_01x04_Socket; Hirose_DF13C_CL535-0404-8-51_1x04-1MP_P1.25mm_Vertical
Q1: XR5P04; SOT-23_Handsoldering
Q2: 2N7002K; SOT-23
R1, R4, R11: 330; R_0805_2012Metric
R2, R5, R6, R7, R8: 2.2k; R_0805_2012Metric
R3: 220mR 1W 1%; R_1206_3216Metric_Pad1.30x1.75mm_HandSolder
R9, R10, R12, R13, R14, R15: 100k; R_0805_2012Metric
R16: 10k; R_0805_2012Metric
SPK_L: Speaker_4R_3W_35x25mm
SPK_R: Speaker_4R_3W_35x25mm
TOUCH1: Conn_01x03_Socket; PinHeader_1x03_P2.54mm_Vertical
U1: TP4056; ESOP-8_L4.9-W3.9-P1.27-LS6.0-BL-EP
U2: ESP32-C3-Supermini
VDD1: Conn_01x02_Socket; Molex_KK-254_AE-6410-02A_1x02_P2.54mm_Vertical

Connections:
+3.3V: C10.1, PORT1.1, R6.1, R7.1, U2.14 (3V3)
+5V: D29.1 (K), R2.1, R3.1, U1.8 (CE), U2.16 (5V), VDD1.1
+BATT: BATT1.1, BT1.1, C2.1, Q1.2 (S), R10.2, TOUCH1.1, U1.5 (BAT)
ADC1_0: C26.2, R14.1, R15.1, U2.9 (GPIO0)
Button_GPIO: C18.2, D32.2 (A), R8.2, TOUCH1.2, U2.12 (GPIO3)
GND: BATT1.2, C1.2, C2.2, C3.1, C4.1, C5.1, C6.1, C7.1, C8.1, C9.1, C10.2, C11.1, C12.1, C13.1, C14.1, C15.1, C16.1, C17.1, C18.1, C19.1, C20.1, C21.1, C22.1, C23.1, C24.1, C25.1, C26.1, C27.1, C28.1, C29.1, C30.1, C31.1, C32.1, C33.1, C34.2, D1.2 (VSS), D2.2 (VSS), D3.2 (VSS), D4.2 (VSS), D5.2 (VSS), D6.2 (VSS), D7.2 (VSS), D8.2 (VSS), D9.2 (VSS), D10.2 (VSS), D11.2 (VSS), D12.2 (VSS), D13.2 (VSS), D14.2 (VSS), D15.2 (VSS), D16.2 (VSS), D17.2 (VSS), D18.2 (VSS), D19.2 (VSS), D20.2 (VSS), D21.2 (VSS), D22.2 (VSS), D23.2 (VSS), D24.2 (VSS), D25.2 (VSS), D26.2 (VSS), D27.2 (VSS), D28.2 (VSS), J1.3, PORT1.4, Q2.2 (S), R5.1, R9.1, R15.2, R16.2, TOUCH1.3, U1.1 (TEMP), U1.3 (GND), U1.9 (EP), U2.15 (GND), VDD1.2
Majora_out: R1.1, U2.11 (GPIO2)
unnamed: BT1.2, R8.1, R9.2
unnamed: D1.1 (DIN), R1.2
unnamed: D1.4 (DOUT), D2.1 (DIN)
unnamed: D2.4 (DOUT), D3.1 (DIN)
unnamed: D3.4 (DOUT), D4.1 (DIN)
unnamed: D4.4 (DOUT), D5.1 (DIN)
unnamed: D5.4 (DOUT), D6.1 (DIN)
unnamed: D6.4 (DOUT), D7.1 (DIN)
unnamed: D7.4 (DOUT), D8.1 (DIN)
unnamed: D8.4 (DOUT), D9.1 (DIN)
unnamed: D9.4 (DOUT), D10.1 (DIN)
unnamed: D10.4 (DOUT), D11.1 (DIN)
unnamed: D11.4 (DOUT), D12.1 (DIN)
unnamed: D12.4 (DOUT), D13.1 (DIN)
unnamed: D13.4 (DOUT), D14.1 (DIN)
unnamed: D14.4 (DOUT), D15.1 (DIN)
unnamed: D15.4 (DOUT), D16.1 (DIN)
unnamed: D16.4 (DOUT), D17.1 (DIN)
unnamed: D17.4 (DOUT), D18.1 (DIN)
unnamed: D18.4 (DOUT), D19.1 (DIN)
unnamed: D19.4 (DOUT), D20.1 (DIN)
unnamed: D20.4 (DOUT), D21.1 (DIN)
unnamed: D21.4 (DOUT), D22.1 (DIN)
unnamed: D22.4 (DOUT), D23.1 (DIN)
unnamed: D23.4 (DOUT), D24.1 (DIN)
unnamed: D24.4 (DOUT), D25.1 (DIN)
unnamed: D25.4 (DOUT), D26.1 (DIN)
unnamed: D26.4 (DOUT), D27.1 (DIN)
unnamed: D27.4 (DOUT), D28.1 (DIN)
unnamed: D30.2 (A), D31.2 (A), R2.2
unnamed: D30.1 (K), U1.6 (STDBY#)
unnamed: D31.1 (K), U1.7 (CHRG#)
unnamed: D32.1 (K), D33.1 (K), Q2.1 (G), R16.1
unnamed: D33.2 (A), R11.2
unnamed: J1.2, R4.2
unnamed: Q1.1 (G), Q2.3 (D), R10.1
unnamed: R12.1, R13.2
unnamed: R13.1, R14.2
unnamed: R5.2, U1.2 (PROG)
unnamed: R3.2, U1.4 (VCC)
SCL: PORT1.3, R6.2, U2.4 (GPIO8)
SDA: PORT1.2, R7.2, U2.3 (GPIO7)
Strip_out: R4.1, U2.10 (GPIO1)
V_REG: C1.1, C3.2, C4.2, C5.2, C6.2, C7.2, C8.2, C9.2, C11.2, C12.2, C13.2, C14.2, C15.2, C16.2, C17.2, C19.2, C20.2, C21.2, C22.2, C23.2, C24.2, C25.2, C27.2, C28.2, C29.2, C30.2, C31.2, C32.2, C33.2, C34.1, D1.3 (VDD), D2.3 (VDD), D3.3 (VDD), D4.3 (VDD), D5.3 (VDD), D6.3 (VDD), D7.3 (VDD), D8.3 (VDD), D9.3 (VDD), D10.3 (VDD), D11.3 (VDD), D12.3 (VDD), D13.3 (VDD), D14.3 (VDD), D15.3 (VDD), D16.3 (VDD), D17.3 (VDD), D18.3 (VDD), D19.3 (VDD), D20.3 (VDD), D21.3 (VDD), D22.3 (VDD), D23.3 (VDD), D24.3 (VDD), D25.3 (VDD), D26.3 (VDD), D27.3 (VDD), D28.3 (VDD), D29.2 (A), J1.1, Q1.3 (D), R12.2
latch_enable: R11.1, U2.13 (GPIO4)
