machadoleonardo94/Echoes-of-Termina/Hardware/Mid_2_WS2812B/Mid_2_WS2812B.kicad_pcb

## KiCad design Hardware/Mid_2_WS2812B/Mid_2_WS2812B.kicad_pcb (2026-09-29)

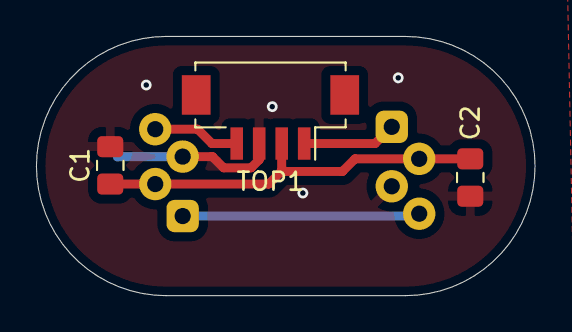
[picture p59: board Mid_2_WS2812B.kicad_pcb from above]

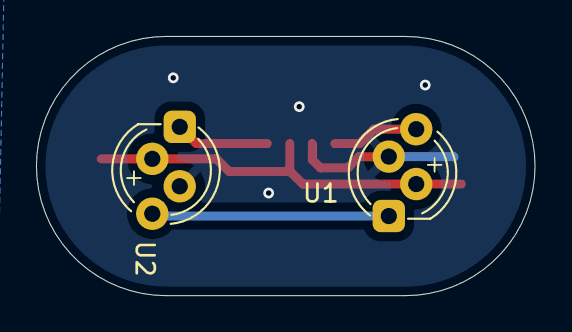
[picture p60: board Mid_2_WS2812B.kicad_pcb from below]

Board: 2 copper layers, 27.7 x 14.4 mm, 5 parts (2 on the bottom side), 5 nets.

Parts:
C1, C2: 100n; C_0805_2012Metric_Pad1.18x1.45mm_HandSolder
TOP1: Conn_01x04_Socket; Hirose_DF13C_CL535-0404-8-51_1x04-1MP_P1.25mm_Vertical
U1, U2: WS2812B; WS2812B_PTH_staggered

Connections:
GND: C1.2, C2.2, TOP1.3, U1.2 (VSS), U2.2 (VSS)
unnamed: U1.4 (DOUT), U2.1 (DIN)
Strip_in: TOP1.4, U1.1 (DIN)
Strip_out: TOP1.1, U2.4 (DOUT)
VCC: C1.1, C2.1, TOP1.2, U1.3 (VDD), U2.3 (VDD)
