machadoleonardo94/Echoes-of-Termina/(commit log)

2026-08-06 Migrated to its own repository
    Moved all related projects (sound board, mask LED substrate, firmware, executable) to a single repository.
2026-10-21 Firmware update
    Two-button UI, portal OTA/API, V1/Marajoara/N16 envs — all Firmware/echoes_of_termina/** source, platformio.ini, boards/, partitions_*.csv, docs/, tools/, delete partitions.csv.
2026-10-21 Executable update
    Theme extraction, FFT spectrum analyser, transport fixes — Executable/echoes/** changes, new ui/theme.py + spectrum* files + Run Spectrum.bat, delete Changing Seasons (projects/ stays empty, README kept).
2026-10-21 Hardware update
    hardware: Marajoara V3 routing refresh, Echoes case/3D — KiCad + production outputs + Case/, Speaker_40mm_Case/
2026-10-21 chore: untrack KiCad fp-info-cache files
    Per-machine footprint caches that slipped into the hardware commit. The root
    ignore rules already cover them, so they can only reappear if re-added.
2026-10-21 chore: document .gitignore sections and rationale
    Rewrite the ignore file as the single documented source: numbered sections
    with the reason for each group, a deliberately-tracked list (board JSONs,
    partition tables, docs, tools, fab outputs, datasheets), the empty-projects
    release policy, and the note that *.kicad_prl stays tracked by design.
2026-10-21 Executable hotfix + trim code
    Split project format from mask export; make note highway match LED engine
    Projects now save one [TrackName] section per track so every track reopens
    as an editable slot, and the firmware's single time-ordered stream is
    produced separately by "Export to Mask" (Ctrl+E) and by "Upload Project",
    which uploads a merged scratch copy instead of the multi-track project.
    - _parse_tracks keeps pre-header text as a leading 'Default' track and
    loads header-less (merged) scripts as a single track
    - NoteHighway paints every note body at one alpha, samples the geometric
    fade used by ScriptEngine (new fade_value), draws RAMP holds past the
    ramp end, and de-duplicates co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
2026-10-21 Updated PCB PDF references
2026-10-22 chore: pin LF checkout via .gitattributes
2026-10-22 refactor(hardware): split KiCad and printed-part trees; add Echoes V2
2026-10-22 docs(firmware): add status-lights section (§13) to two-button UI doc
2026-10-22 feat(import): add drum pedal cue and labelled slots
